mokweri/2560_TrainingKit/README.md

# 2560_TrainingKit
 A Microcontroller Training Kit based on ATmega2560
 
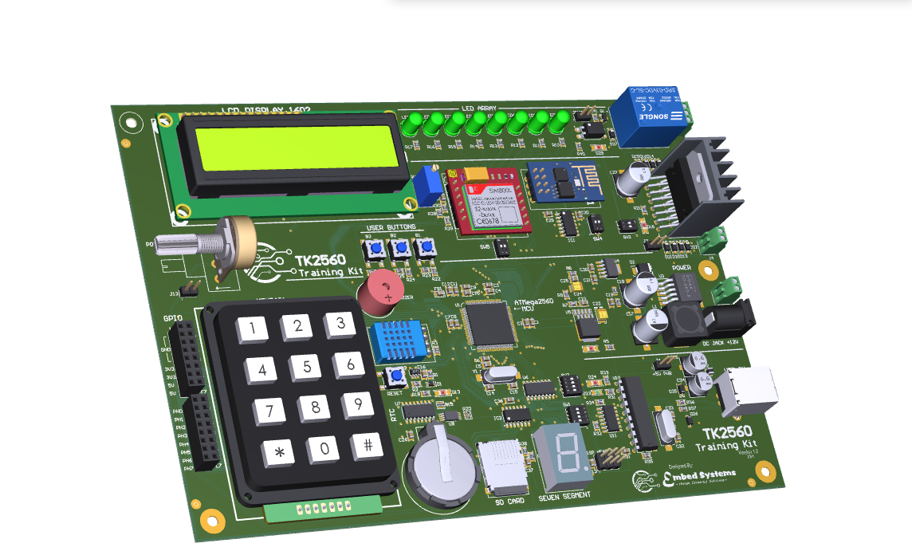
[picture p1: DesignFiles/TK2560_Images/TK2560_1.png]
