mokweri/2560_TrainingKit/Documentation/TK2560 Features.pptx

## TK2560 FEATURES

- Realtime Clock (DS3231) with backup battery

- ATMega2560 MCU

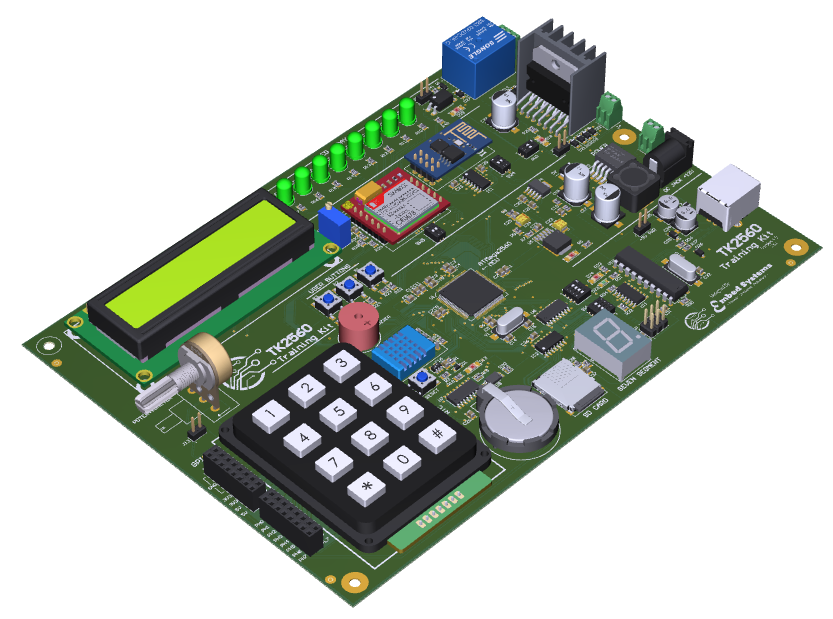
[picture p2: figure]

- 1 Digit Seven Segment

- 16x2 LCD Display

- EEPROM

- WIFI (ESP8166)

- Buzzer

- 8 LEDs Array

- Micro SD Card Slot

- GSM (SIM800L)

- Opto-coupled Solenoid relay

- 4x3 Keypad

- Motor Driver (L298N)

- Onboard ISP (USBTiny)

- DHT11 Temp. sensor

- 3 User Buttons

- Analog in; Potentiometer

- 24 GPIOs

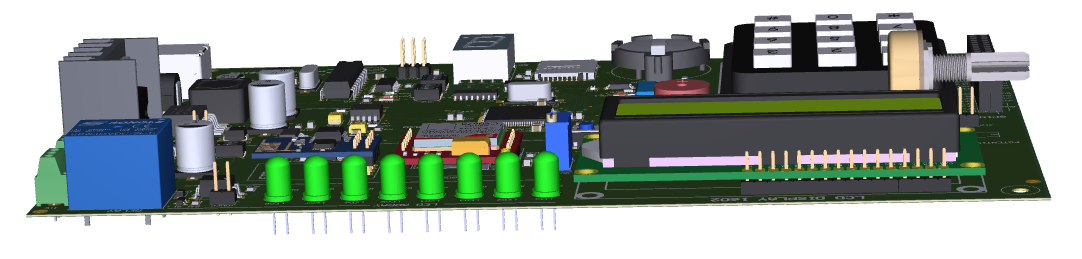
[picture p3: figure]

## TK2560 FEATURES

- ATMega2560 MCU

- Realtime Clock (DS3231) with backup battery

- 1 Digit Seven Segment

- 16x2 LCD Display

- EEPROM

- WIFI (ESP8166)

- Buzzer

- 8 LEDs Array

- Micro SD Card Slot

- GSM (SIM800L)

- Opto-coupled Solenoid relay

- 4x3 Keypad

- Motor Driver (L298N)

- Onboard ISP (USBTiny)

- DHT11 Temp. sensor

- 3 User Buttons

- Analog in; Potentiometer

- 24 GPIOs

## Slide 3

Opto-coupled Solenoid relay

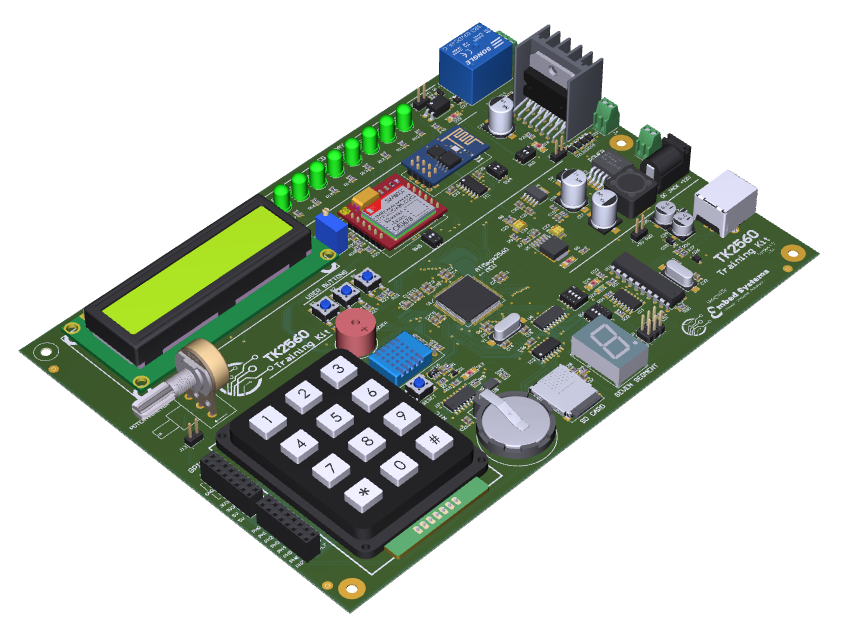
[picture p4: figure]

Motor Driver (L298N)

GSM (SIM800L)

WIFI (ESP8166)

Power: 5-12V

8 LEDs Array

3 User Buttons

16x2 LCD Display

Onboard ISP (USBTiny)

Buzzer

ATMega2560 MCU

1 Digit Seven Segment

Analog in; Potentiometer

24 GPIOs

Realtime Clock (DS3231) with backup battery

Micro SD Card Slot

4x3 Keypad

DHT11 Temp. sensor

## Slide 4

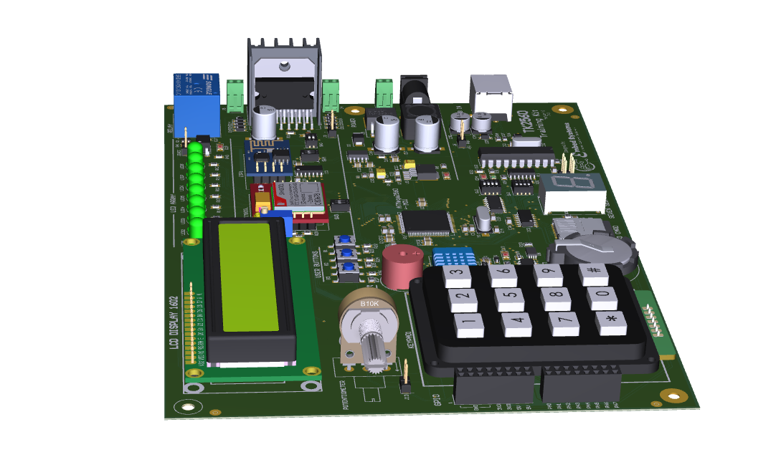
[picture p5: figure]

## Slide 5

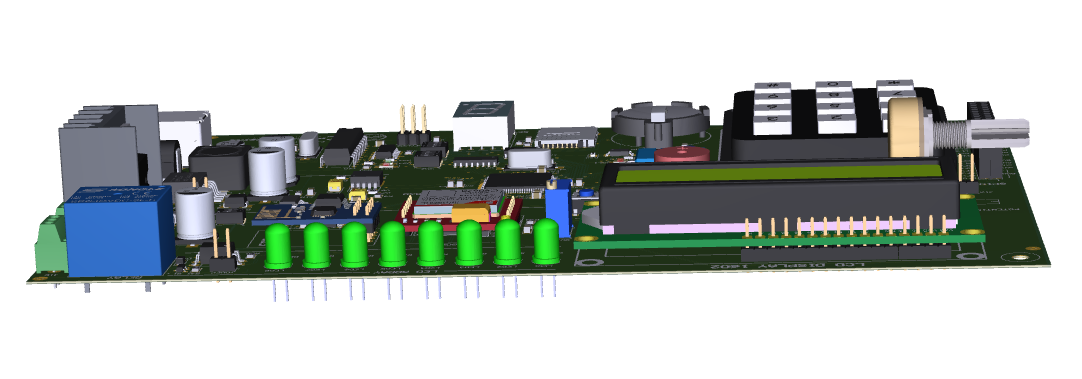
[picture p6: figure]
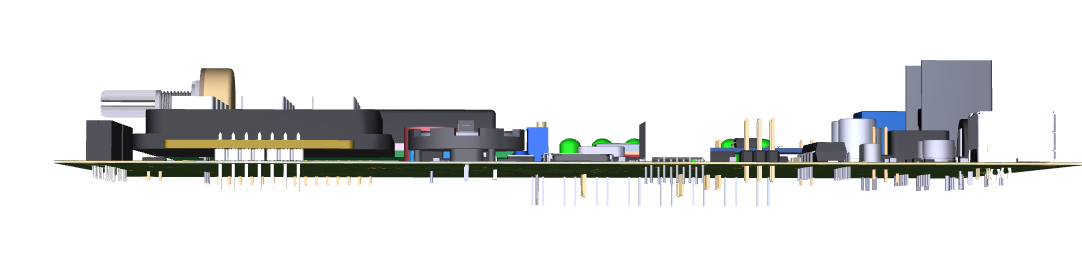
[picture p7: figure]

## Slide 6

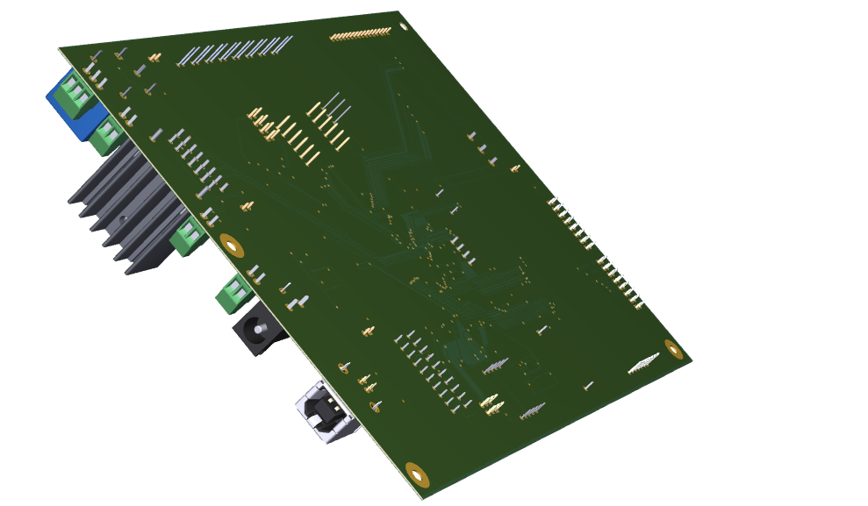
[picture p8: figure]
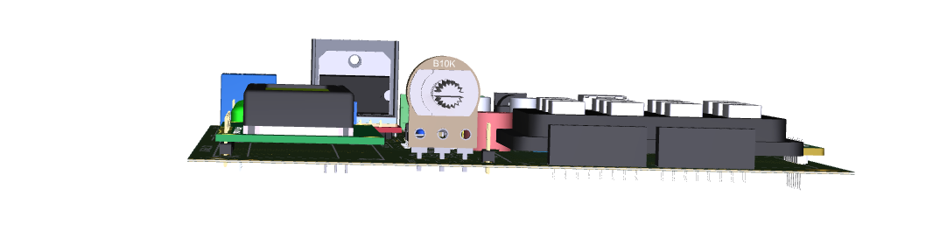
[picture p9: figure]

## TK2560 FEATURES

- Realtime Clock (DS3231) with backup battery

- ATMega2560 MCU

- 1 Digit Seven Segment

- 16x2 LCD Display

- EEPROM

- WIFI (ESP8166)

- Buzzer

- 8 LEDs Array

- Micro SD Card Slot

- GSM (SIM800L)

- Opto-coupled Solenoid relay

- 4x3 Keypad

- Motor Driver (L298N)

- Onboard ISP (USBTiny)

- DHT11 Temp. sensor

- 3 User Buttons

- Analog in; Potentiometer

- 24 GPIOs
