mokweri/2560_TrainingKit/Release Files/Invoice.pdf

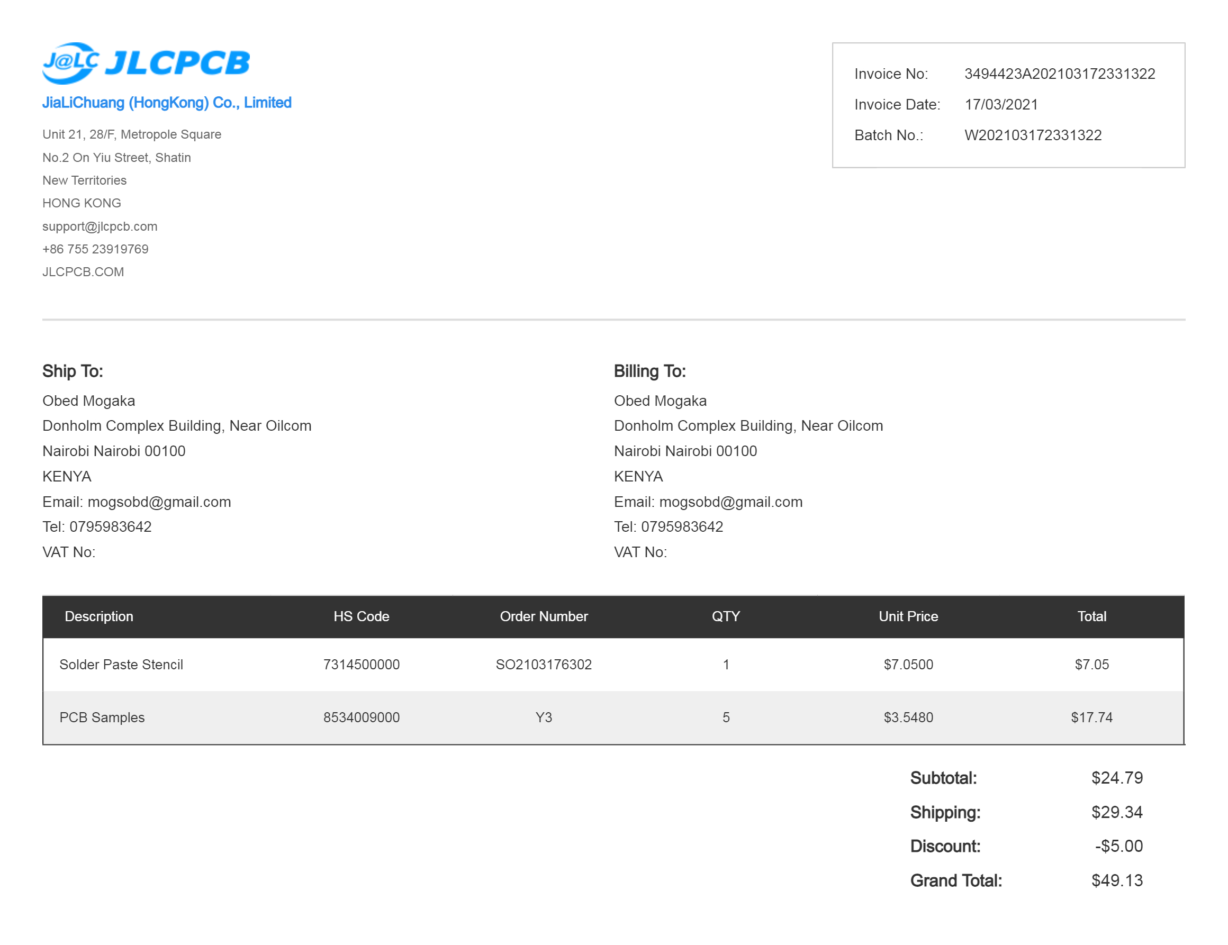
[picture p10: figure]
