mokweri/2560_TrainingKit/DesignFiles/TK2560_Images/TK2560 Features/Slide3.JPG

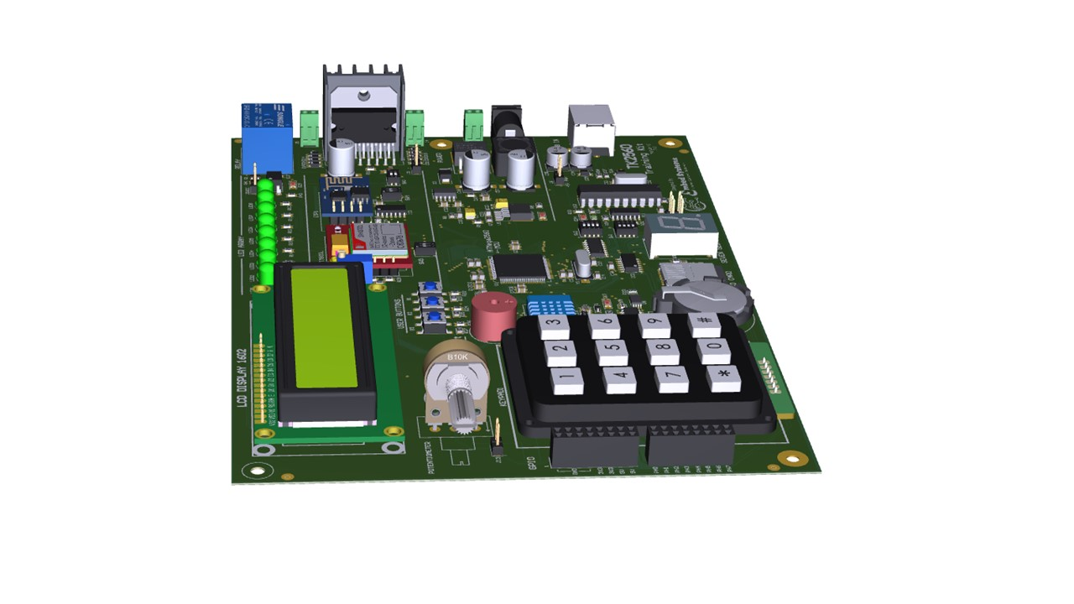
DesignFiles/TK2560_Images/TK2560 Features/Slide3.JPG
