mokweri/2560_TrainingKit/DesignFiles/TK2560_Images/TK2560 Features/Slide5.JPG

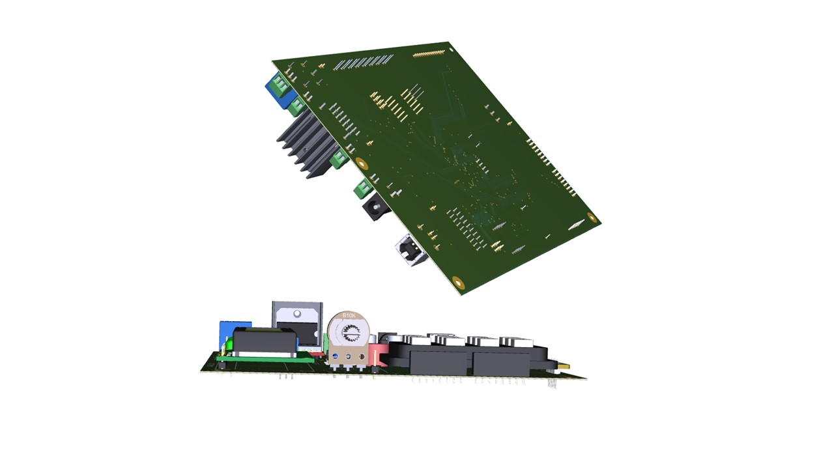
DesignFiles/TK2560_Images/TK2560 Features/Slide5.JPG
