mokweri/2560_TrainingKit/Documentation/Datasheet Library/100tqfp.gif

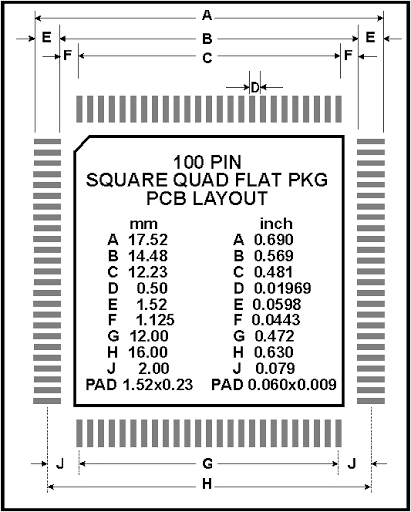
Documentation/Datasheet Library/100tqfp.gif
