mokweri/2560_TrainingKit/Documentation/Datasheet Library/Arduino_Mega_2560_schematic-AasmEVd7P.png

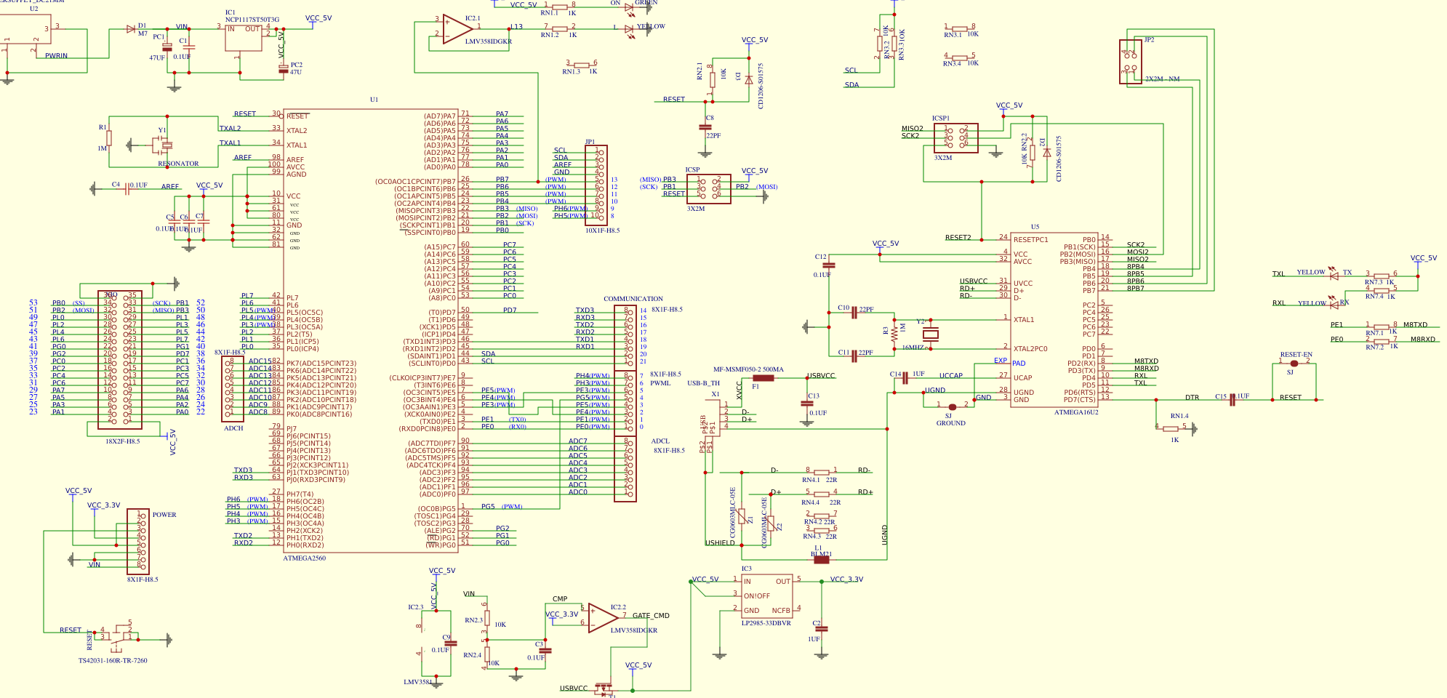
Documentation/Datasheet Library/Arduino_Mega_2560_schematic-AasmEVd7P.png
