mokweri/2560_TrainingKit/Documentation/Datasheet Library/Card Detection Switches.PNG

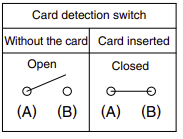
Documentation/Datasheet Library/Card Detection Switches.PNG
