mokweri/2560_TrainingKit/Documentation/Datasheet Library/DS3231-with-EEPROM-Schematic-2.jpg

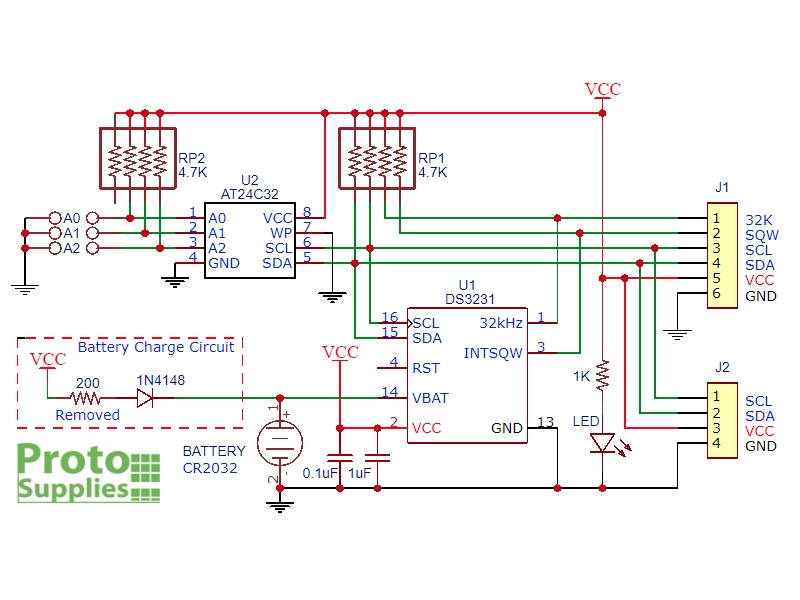
Documentation/Datasheet Library/DS3231-with-EEPROM-Schematic-2.jpg
