mokweri/2560_TrainingKit/Documentation/Schematic Samples/Existing_Reference.jpg

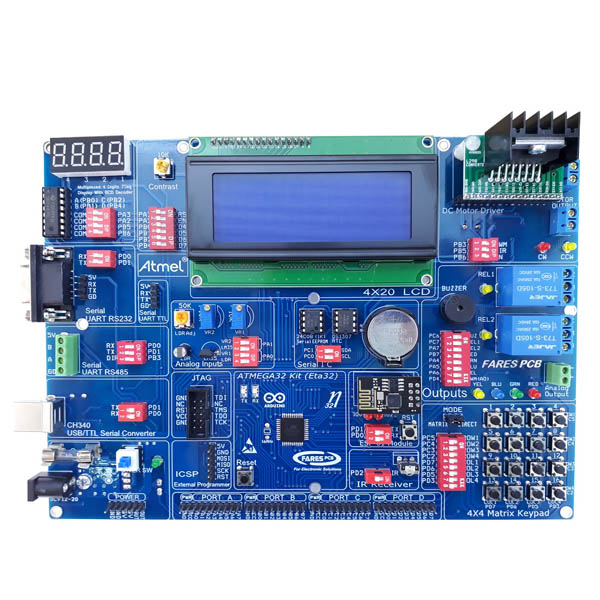
Documentation/Schematic Samples/Existing_Reference.jpg
