mokweri/2560_TrainingKit/Release Files/Images/TK2560/Slide1.JPG

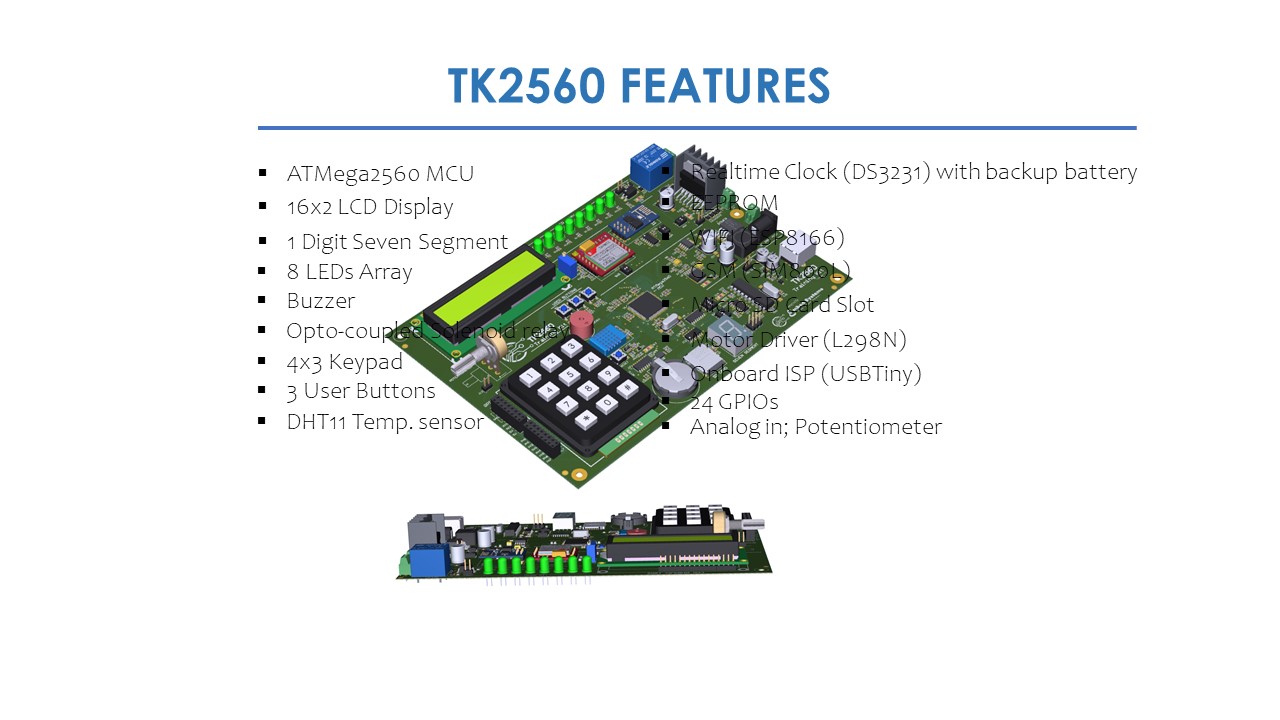
Release Files/Images/TK2560/Slide1.JPG
