mokweri/2560_TrainingKit/Release Files/Images/TK2560/Slide2.JPG

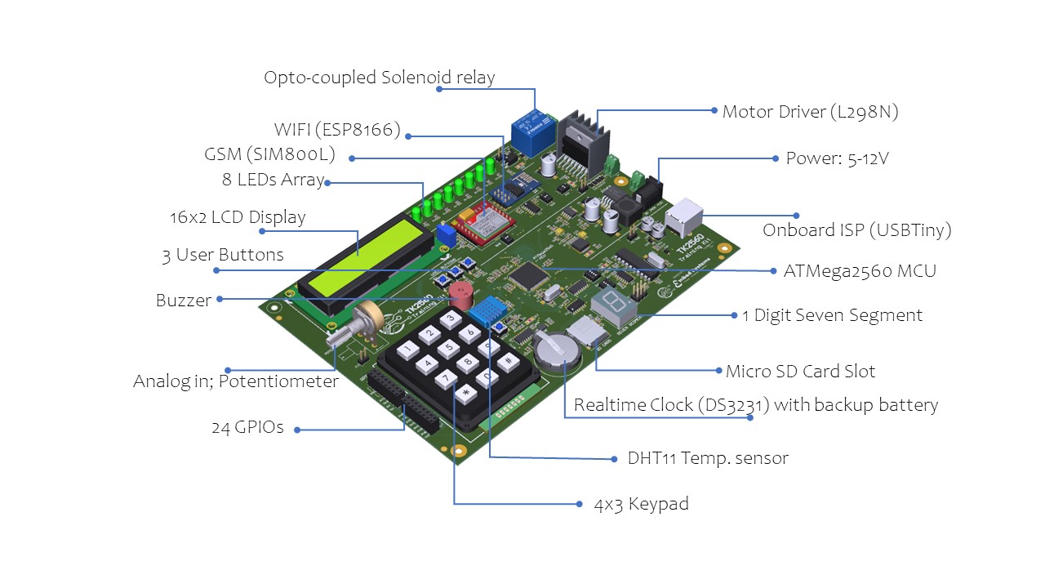
Release Files/Images/TK2560/Slide2.JPG
