mokweri/2560_TrainingKit/Release Files/Images/TK2560/Slide6.JPG

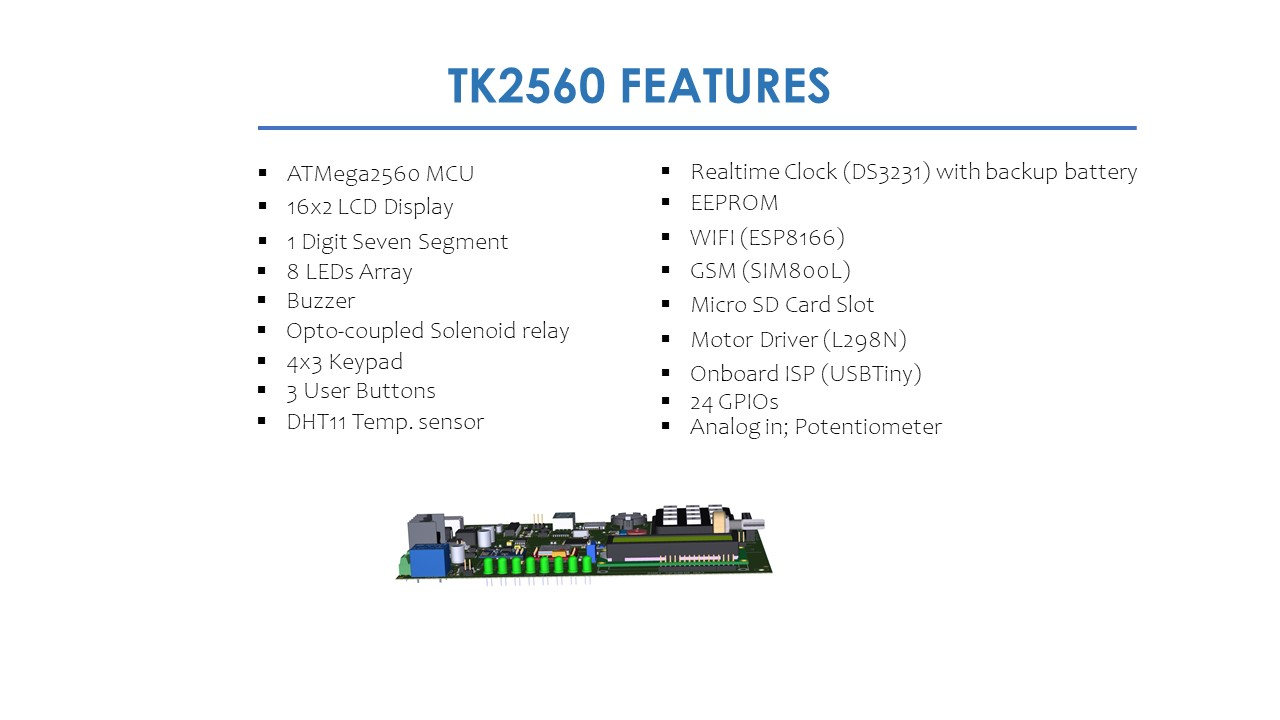
Release Files/Images/TK2560/Slide6.JPG
