mokweri/2560_TrainingKit/Release Files/Images/TK2560/TK2560_10.png

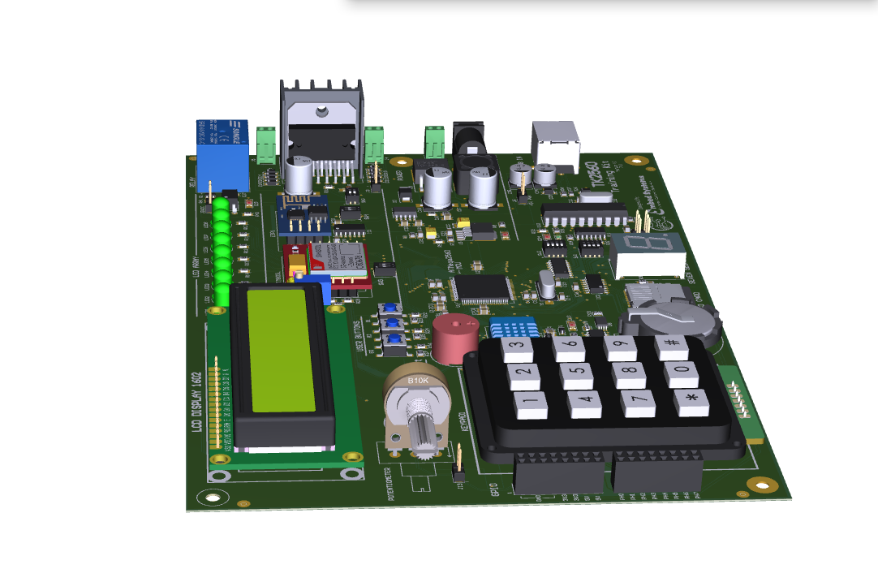
Release Files/Images/TK2560/TK2560_10.png
