mokweri/2560_TrainingKit/Production/TK2560_Grouped BOM.xlsx

Sheet: Part List Report
 | Component reference list (grouped) |  |  |  | 2560_TrainingKit
 | Source Data From: |  | 2560_TrainingKit.PrjPcb |  |  | Contact: |  | Generated by:
 | Project: |  | 2560_TrainingKit.PrjPcb
 | Variant: |  | None |  |  |  |  | EMBEDSYSTEMS
 | Report Date: |  | 3/13/2021 | 19:58
 | Print Date: |  | 2021-03-16 | 12:39:30
# | Designator | Quantity | Comment | Description | Manufacturer 1 | Manufacturer Part Number 1 | Package / Case | Supplier 1 | Supplier Part Number 1
1 | Y2 | 1 | 12MHz | CRYSTAL 12.0000MHZ 30PF SMD |  |  | HC-49/US | DigiKey | 535-14871-1-ND
2 | Y1 | 1 | 16MHz | CRYSTAL 16.0000MHZ 16PF SMD |  |  | HC-49/US | DigiKey | 535-14880-1-ND
3 | USB IN | 1 | 61729-1011BLF | CONN RCPT USB2.0 TYPEB 4POS R/A |  |  |  | DigiKey | 609-3657-ND
4 | U11 | 1 | SN74AHC125NSR | Buffer/Line Driver 4-CH Non-Inverting 3-ST CMOS 14-Pin SOP T/R |  |  |  | Digi-Key | 296-31733-1-ND
5 | U10 | 1 | ATTINY2313-20PU | ATMEL ATTINY2313-20PU 8 Bit Microcontroller, Low Power High Performance, ATtiny, 20 MHz, 2 KB, 128 Byte, 20 Pins, DIP |  |  |  | Digi-Key | ATTINY2313-20PU-ND
6 | U9 | 1 | L298N | Motor / Motion / Ignition Controllers & Drivers Dual Full Bridge |  |  |  | Digi-Key | 497-1395-5-ND
7 | U8 | 1 | AT24C32D-SSHM-T | EEPROM Serial-2Wire 32K-bit 4K x 8 1.8V/2.5V/3.3V/5V 8-Pin SOIC T/R |  |  |  |  | AT24C32D-SSHM-TCT-ND
8 | U7 | 1 | DS3231SN | MAXIM INTEGRATED PRODUCTS - DS3231SN#T&R - IC, RTC, Datum-/Zeitformat (Tag/Datum/Monat/Jahr, hh:mm:ss), I2C, 2.3V-5.5V Versorgung, SOIC-16 |  |  |  | Digi-Key | DS3231SN#T&RCT-ND
9 | U6 | 1 | MC74HC595ADR2 | IC SHIFT REGISTR 8BIT 3ST 16SOIC |  |  |  | Digi-Key | MC74HC595ADR2OSCT-ND
10 | U5 | 1 | MIC29302AWD-TR | IC REG LINEAR POS ADJ 3A TO252-5 |  |  |  | Digi-Key | 576-4106-1-ND
11 | U4 | 1 | TL1963A-33DCQR | IC REG LINEAR 3.3V 1.5A SOT223-6 |  |  |  | Arrow Electronics | TL1963A-33DCQR
12 | U3 | 1 | LM2596DSADJR4G | Sw. Regulator 3A Adj. Step-Down D2PAK-5 |  |  |  | Digi-Key | LM2596DSADJR4GOSCT-ND
13 | U2 | 1 | SN74AHC1G09DBVR | TEXAS INSTRUMENTS - SN74AHC1G09DBVR - AND Gate, 74AHC1G09, 2 Input, 2 V to 5.5 V, SOT-23-5 |  |  |  | Digi-Key | 296-29202-1-ND
14 | U1 | 1 | ATMEGA2560-16AUR | ATMEGA2560 IC MCU 8BIT 256KB FLASH 100TQFP |  |  |  | Digi-Key | ATMEGA2560-16AURCT-ND
15 | SW3, SW4, SW5 | 3 | 218-2LPST | SWITCH SLIDE DIP SPST 25MA 24V |  |  |  | DigiKey | CT2182LPST-ND
16 | SW1, SW2 | 2 | DIP SWITCH | SWITCH SLIDE DIP SPST 25MA 24V |  |  |  | DigiKey | CT3110CT-ND
17 | SIM800L | 1 | Sim800l Breakout
18 | SEVEN SEGMENT | 1 | 7SEG_1DG | LED Displays & Accessories Single Red 640nm Common Anode |  |  |  | Digi-Key | 754-1677-5-ND
19 | SD CARD | 1 | DM3BT-DSF-PEJS | CONN MICRO SD CARD PUSH-PUSH R/A |  |  |  | DigiKey | HR1942TR-ND
20 | RV1 | 1 | 3296W-10K_Trim_Pot | TRIMMER 10K OHM 0.5W PC PIN TOP |  |  |  |  | 3296W-103-ND
21 | RELAY | 1 | SRD-05VDC | TE CONNECTIVITY - 1-1721150-0 - POWER RELAY, SPDT, 277VAC, 10A, TH |  |  |  | Digi-Key | PB2032-ND
22 | R36, R37 | 2 | 33.2 Ohms | RES 33.2 OHM 1% 1/4W 0805 |  |  | 0805 (2012 Metric) | DigiKey | RNCP0805FTD33R2CT-ND
23 | R35 | 1 | 10 kOhms | RES 10K OHM 5% 1/4W 0805 |  |  | 0805 (2012 Metric) | DigiKey | 2019-SG73S2ATTD103JCT-ND
24 | R32, R34 | 2 | 1.5 kOhms | RES 1.5K OHM 1% 1/4W 0805 |  |  | 0805 (2012 Metric) | DigiKey | 2019-SG73S2ATTD1501FCT-ND
25 | R31, R33 | 2 | 220 Ohms | RES 220 OHM 1% 1/4W 0805 |  |  | 0805 (2012 Metric) | DigiKey | 2019-RK73H2ATTD2200FCT-ND
26 | R30 | 1 | 2 kOhms | RES SMD 2K OHM 1% 0.4W 0805 |  |  | 0805 (2012 Metric) | DigiKey | 541-2840-1-ND
27 | R28, R29 | 2 | 1 kOhms | RES 1K OHM 0.1% 1/10W 0805 |  |  | 0805 (2012 Metric) | DigiKey | RNCS0805BKE1K00CT-ND
28 | R23, R25, R27, R39 | 4 | 10 kOhms | RES SMD 10K OHM 0.1% 1/10W 0805 |  |  | 0805 (2012 Metric) | DigiKey | A106043CT-ND
29 | R22, R24, R26, R38 | 4 | 220 Ohms | RES SMD 220 OHM 1% 1/8W 0805 |  |  | 0805 (2012 Metric) | DigiKey | P220CCT-ND
30 | R19, R20 | 2 | EXB-28V472JX | RES ARRAY 4 RES 4.7K OHM 0804 |  |  | 0804, Convex, Long Side Terminals | DigiKey | Y7472CT-ND
31 | R10, R11, R12, R13, R14, R15, R16, R17 | 8 | 330 Ohms | RES SMD 330 OHM 1% 1/8W 0805 |  |  | 0805 (2012 Metric) | DigiKey | 311-330CRCT-ND
32 | R9 | 1 | 43 kOhms | RES SMD 43K OHM 0.1% 1/8W 0805 |  |  | 0805 (2012 Metric) | DigiKey | YAG1899CT-ND
33 | R8 | 1 | 470 Ohms | RES SMD 470 OHM 1% 1/2W 0805 |  |  | 0805 (2012 Metric) | DigiKey | 541-470TCT-ND
34 | R7 | 1 | 100 kOhms | RES SMD 100K OHM 1% 0.4W 0805 |  |  | 0805 (2012 Metric) | DigiKey | 541-2850-1-ND
35 | R6, R40, R41 | 3 | 1 kOhms | RES 1K OHM 1% 1/4W 0805 |  |  | 0805 (2012 Metric) | DigiKey | RNCP0805FTD1K00CT-ND
36 | R5, R18, R21 | 3 | 330 Ohms | RES SMD 330 OHM 5% 1/8W 0805 |  |  | 0805 (2012 Metric) | DigiKey | P330ACT-ND
37 | R4 | 1 | 3 kOhms | RES SMD 3K OHM 0.5% 1/4W 0805 |  |  | 0805 (2012 Metric) | DigiKey | P21071CT-ND
38 | R3 | 1 | 4.7 kOhms | RES SMD 4.7K OHM 1% 1/8W 0805 |  |  | 0805 (2012 Metric) | DigiKey | YAG1325CT-ND
39 | R2 | 1 | 22 Ohms | RES SMD 22 OHM 5% 1/8W 0805 |  |  | 0805 (2012 Metric) | DigiKey | 311-22ARCT-ND
40 | R1 | 1 | 10 kOhms | RES SMD 10K OHM 0.5% 1/8W 0805 |  |  | 0805 (2012 Metric) | DigiKey | 311-2699-1-ND
41 | Q1 | 1 | BC847BLT3G | TRANS NPN 45V 0.1A SOT-23 |  |  | TO-236-3, SC-59, SOT-23-3 | DigiKey | BC847BLT3GOSCT-ND
42 | POTENTIOMETER | 1 | POT 10K | Res Conductive Plastic POT 10K Ohm 20% 1/5W 1(Elec)/1(Mech)Turn 6mm Pin Panel Mount/Through Hole |  |  |  | Digi-Key | 987-1715-ND
43 | MH4 | 1 | MH_7.4MMNC_3.2MMD | Mounting Hole 7.4mm Diameter (Non Copper), 3.2mm Dril NPTH
44 | MH1, MH2, MH3 | 3 | MH_7.4MMC_3.2MMD | Mounting Hole 7.4mm Diameter, 3.2mm Dril
45 | LED1, LED2, LED3, LED4, LED5, LED6, LED7, LED8 | 8 | LED_5mm | 5MM LED |  |  |  | Digi-Key | 754-1896-ND
46 | LCD DISPLAY 1602 | 1 | LCD-1602 | LUMEX LCM-S01602DTR/C Alphanumeric LCD, 16 x 2, Black on Grey, 5V, Parallel, English, Japanese, Reflective |  |  |  | Digi-Key | 67-1780-ND
47 | L2 | 1 | 2.2µH | FIXED IND 2.2UH 2A 168 MOHM SMD |  |  | 0806 (2016 Metric) | DigiKey | 490-10609-1-ND
48 | L1 | 1 | 33µH | FIXED IND 33UH 3.5A 57 MOHM SMD |  |  | Nonstandard | DigiKey | SRR1280-330MCT-ND
49 | KEYPAD1 | 1 | 3X4Keypad | 3x4 Matrix Keypad |  |  |  | Digi-Key | 1528-2673-ND
50 | J10 | 1 | 282834-3 | TERM BLK 3P SIDE ENT 2.54MM PCB |  |  |  | DigiKey | A98334-ND
51 | J4, J5, J14 | 3 | 282834-2 | TERM BLK 2P SIDE ENT 2.54MM PCB |  |  |  | DigiKey | A98333-ND
52 | J3, J6, J13, JDVCC | 4 | HDR_1x2, OUTPWR, JDVCC | Pin Header 2.54MM Pitch Str, 1X2PIN, Full G/f, NY6T, 6.1MM*2.5MM*3.0MM / Bag |  |  |  | Mouser | 523-G800W306018EU
53 | ISP HEADER | 1 | ISP HDR | CONN HEADER 6POS .100 STR 30AU |  |  |  | Digi-Key | 609-3393-ND
54 | IC1, IC2 | 2 | TXB0104DR | IC TRNSLTR BIDIRECTIONAL 14SOIC |  |  | 14-SOIC (0.154", 3.90mm Width) | DigiKey | 296-21928-1-ND
55 | GPIO, J12 | 2 | HDR_2x8 | CONN HDR FEMALE 16POS 0.1 GOLD PCB |  |  |  | Digi-Key | S7111-ND
56 | FID1, FID2, FID3, FID4 | 4 | FID_1MM | Fiducial 40mil Diameter, 120mil mask
57 | FB1 | 1 | MPZ2012S601AT000 | FERRITE BEAD 600 OHM 0805 1LN |  |  |  | Digi-Key | 445-2206-1-ND
58 | ESP1 | 1 | ESP-01M | TXRX ESP8266 MOD WIFI TRACE ANT |  |  |  | Digi-Key | 1597-1145-ND
59 | DHT11 | 1 | DHT11 | SENSOR HUMID/TEMP 5V DTL 5% MOD |  |  |  | Digi-Key | 1528-1228-ND
60 | DC JACK +12V | 1 | PJ-102AH | CONN PWR JACK 2X5.5MM SOLDER |  |  |  | DigiKey | CP-102AH-ND
61 | D28 | 1 | LTV-817S-TA1 | OPTOISOLATR 5KV TRANSISTOR 4-SMD |  |  | 4-SMD, Gull Wing | DigiKey | 160-1893-1-ND
62 | D25, D26 | 2 | MMSZ5227B-E3-08 | DIODE ZENER 3.6V 500MW SOD123 |  |  | SOD-123 | DigiKey | MMSZ5227B-E3-08GICT-ND
63 | D24, D29 | 2 | Red | LED RED CLEAR 2SMD |  |  | 1206 (3216 Metric) | DigiKey | 1497-1289-1-ND
64 | D23 | 1 | Green | LED GREEN CLEAR 0805 SMD |  |  | 0805 (2012 Metric) | DigiKey | 1080-1411-1-ND
65 | D14, D15, D16, D17, D19, D20, D21, D22, D27 | 9 | 1N4007FLTR | STANDARD RECTIFIER 1000V SOD-123 |  |  | SOD-123F | DigiKey | 1655-1N4007FLCT-ND
66 | D3, D13, D18 | 3 | Red | LED SMD |  |  | 1206 (3216 Metric) | DigiKey | 754-APTL3216SURCK-01CT-ND
67 | D2 | 1 | B340BQ-13-F | DIODE SCHOTTKY 40V 3A SMB |  |  | DO-214AA, SMB | DigiKey | B340BQ-13-FDICT-ND
68 | D1 | 1 | BAT54HT1G | DIODE SCHOTTKY 30V 200MA SOD323 |  |  | SC-76, SOD-323 | DigiKey | BAT54HT1GOSCT-ND
69 | C34, C35 | 2 | 100µF | CAP ALUM 100UF 20% 10V SMD |  |  | Radial, Can - SMD | DigiKey | 493-16092-1-ND
70 | C32, C33 | 2 | 30pF | CAP CER 30PF 25V NP0 0805 |  |  | 0805 (2012 Metric) | DigiKey | 399-17444-1-ND
71 | C27 | 1 | 220µF | CAP ALUM 220UF 20% 35V SMD |  |  | Radial, Can - SMD | DigiKey | PCE4321CT-ND
72 | C24 | 1 | 330µF | CAP TANT 330UF 10% 4V 1411 |  |  | 1411 (3528 Metric) | DigiKey | 478-8377-1-ND
73 | C23 | 1 | 1µF | CAP CER 1UF 16V X5R 0805 |  |  | 0805 (2012 Metric) | DigiKey | 478-11535-1-ND
74 | C22 | 1 | 100µF | CAP TANT 100UF 20% 6.3V 1411 |  |  | 1411 (3528 Metric) | DigiKey | 399-3833-1-ND
75 | C19 | 1 | 0.1µF | CAP CER 0.1UF 16V X7R 0805 |  |  | 0805 (2012 Metric) | DigiKey | 709-1183-1-ND
76 | C18 | 1 | 220µF | CAP ALUM 220UF 20% 25V SMD |  |  | Radial, Can - SMD | DigiKey | 493-6222-1-ND
77 | C17 | 1 | 100µF | CAP ALUM 100UF 20% 50V SMD |  |  | Radial, Can - SMD | DigiKey | 493-6336-1-ND
78 | C14, C15 | 2 | 22pF | CAP CER 22PF 100V C0G/NP0 0805 |  |  | 0805 (2012 Metric) | DigiKey | 478-10819-1-ND
79 | C2, C4, C6, C8, C10, C12, C13, C16, C25, C26, C28, C29, C30, C31, C36, C37 | 16 | 100nF, 0.1µF | CAP CER 0805 10% X8R 50V 100NF |  |  | 0805 (2012 Metric) | DigiKey | 311-4624-1-ND
80 | C1, C3, C5, C7, C9, C11, C20, C21 | 8 | 10µF | CAP CER 10UF 16V X5R 0805 |  |  | 0805 (2012 Metric) | DigiKey | 1763-1170-1-ND
81 | BUZZER | 1 | BUZZER | AUDIO MAGNETIC XDCR 3-7V TH |  |  |  | Digi-Key | 668-1470-ND
82 | BH1 | 1 | Batt Holder | BATTERY HOLDER COIN 20MM PC PIN |  |  |  | Digi-Key | BS-7-ND
83 | B1, B2, B3, RESET | 4 | PTS645SM43SMTR92 LFS | SWITCH TACTILE SPST-NO 0.05A 12V |  |  |  | DigiKey | CKN9112CT-ND
Approved |  |  |  |  | Notes

Sheet: Project Information
Project Full Path | D:\2560_TrainingKit\DesignFiles\2560_TrainingKit\2560_TrainingKit.PrjPcb
Project Filename | 2560_TrainingKit.PrjPcb
Variant Name | None
Data-Source Filename | 2560_TrainingKit.PrjPcb
Data-Source Full Path | D:\2560_TrainingKit\DesignFiles\2560_TrainingKit\2560_TrainingKit.PrjPcb
Title | 2560_TrainingKit.PrjPcb
Total Quantity | 167
Report Time | 19:58
Report Date | 3/13/2021
Report Date & Tine | 3/13/2021 19:58
Output Name | TK2560_Grouped BOM
Output Type | BOM_PartType
Output Generator Name | BOM
Output Generator Description | Bill of Materials
