mokweri/2560_TrainingKit/Production/TK2560_BOM Purchasing.xlsx

Sheet: Part List Report
 | Component list |  |  | TK2560_BOM Purchasing for Project [2560_TrainingKit.PrjPcb] (No PCB Document Selected)
 | Source Data From: | 2560_TrainingKit.PrjPcb |  |  | Contact: |  |  |  | Generated by:
 | Project: | 2560_TrainingKit.PrjPcb
 | Variant: | None |  |  |  |  |  |  | EMDEDSYSTEMS
 | Report Date: | 3/13/2021 | 19:37
 | Print Date: | 2021-03-13 | 19:38:11
# | Category | Manufacturer 1 | Manufacturer Part Number 1 | Package / Case | Description | Quantity | Supplier 1 | Supplier Part Number 1 | Supplier Order Qty 1 | Supplier Stock 1 | Supplier Unit Price 1 | Supplier Subtotal 1 | Supplier Currency 1
1 |  |  |  | 0805 (2012 Metric) | CAP CER 0805 10% X8R 50V 100NF, CAP CER 0.1UF 16V X7R 0805 | 2 | DigiKey | 311-4624-1-ND, 709-1183-1-ND
2 |  |  |  | 0805 (2012 Metric) | RES 1K OHM 1% 1/4W 0805, RES 1K OHM 0.1% 1/10W 0805 | 5 | DigiKey | RNCP0805FTD1K00CT-ND, RNCS0805BKE1K00CT-ND
3 |  |  |  | 0805 (2012 Metric) | CAP CER 1UF 16V X5R 0805 | 1 | DigiKey | 478-11535-1-ND
4 |  |  |  | SOD-123F | STANDARD RECTIFIER 1000V SOD-123 | 9 | DigiKey | 1655-1N4007FLCT-ND
5 |  |  |  | 0805 (2012 Metric) | RES 1.5K OHM 1% 1/4W 0805 | 2 | DigiKey | 2019-SG73S2ATTD1501FCT-ND
6 |  |  |  | 0805 (2012 Metric) | RES SMD 2K OHM 1% 0.4W 0805 | 1 | DigiKey | 541-2840-1-ND
7 |  |  |  | 0806 (2016 Metric) | FIXED IND 2.2UH 2A 168 MOHM SMD | 1 | DigiKey | 490-10609-1-ND
8 |  |  |  | 0805 (2012 Metric) | RES SMD 3K OHM 0.5% 1/4W 0805 | 1 | DigiKey | P21071CT-ND
9 |  |  |  |  | 3x4 Matrix Keypad | 1 | Digi-Key | 1528-2673-ND
10 |  |  |  | 0805 (2012 Metric) | RES SMD 4.7K OHM 1% 1/8W 0805 | 1 | DigiKey | YAG1325CT-ND
11 |  |  |  | 0805 (2012 Metric) | RES SMD 10K OHM 0.5% 1/8W 0805, RES SMD 10K OHM 0.1% 1/10W 0805, RES 10K OHM 5% 1/4W 0805 | 6 | DigiKey | 311-2699-1-ND, A106043CT-ND, 2019-SG73S2ATTD103JCT-ND
12 |  |  |  | 0805 (2012 Metric) | CAP CER 10UF 16V X5R 0805 | 8 | DigiKey | 1763-1170-1-ND
13 |  |  |  | HC-49/US | CRYSTAL 12.0000MHZ 30PF SMD | 1 | DigiKey | 535-14871-1-ND
14 |  |  |  | HC-49/US | CRYSTAL 16.0000MHZ 16PF SMD | 1 | DigiKey | 535-14880-1-ND
15 |  |  |  | 0805 (2012 Metric) | RES SMD 22 OHM 5% 1/8W 0805 | 1 | DigiKey | 311-22ARCT-ND
16 |  |  |  | 0805 (2012 Metric) | CAP CER 22PF 100V C0G/NP0 0805 | 2 | DigiKey | 478-10819-1-ND
17 |  |  |  | 0805 (2012 Metric) | CAP CER 30PF 25V NP0 0805 | 2 | DigiKey | 399-17444-1-ND
18 |  |  |  | Nonstandard | FIXED IND 33UH 3.5A 57 MOHM SMD | 1 | DigiKey | SRR1280-330MCT-ND
19 |  |  |  | 0805 (2012 Metric) | RES 33.2 OHM 1% 1/4W 0805 | 2 | DigiKey | RNCP0805FTD33R2CT-ND
20 |  |  |  | 0805 (2012 Metric) | RES SMD 43K OHM 0.1% 1/8W 0805 | 1 | DigiKey | YAG1899CT-ND
21 |  |  |  | 0805 (2012 Metric) | RES SMD 100K OHM 1% 0.4W 0805 | 1 | DigiKey | 541-2850-1-ND
22 |  |  |  | Radial, Can - SMD | CAP ALUM 100UF 20% 10V SMD | 2 | DigiKey | 493-16092-1-ND
23 |  |  |  | Radial, Can - SMD | CAP ALUM 100UF 20% 50V SMD | 1 | DigiKey | 493-6336-1-ND
24 |  |  |  | 1411 (3528 Metric) | CAP TANT 100UF 20% 6.3V 1411 | 1 | DigiKey | 399-3833-1-ND
25 |  |  |  | 0805 (2012 Metric) | CAP CER 0805 10% X8R 50V 100NF | 15 | DigiKey | 311-4624-1-ND
26 |  |  |  |  | SWITCH SLIDE DIP SPST 25MA 24V | 3 | DigiKey | CT2182LPST-ND
27 |  |  |  | 0805 (2012 Metric) | RES SMD 220 OHM 1% 1/8W 0805, RES 220 OHM 1% 1/4W 0805 | 6 | DigiKey | P220CCT-ND, 2019-RK73H2ATTD2200FCT-ND
28 |  |  |  | Radial, Can - SMD | CAP ALUM 220UF 20% 25V SMD, CAP ALUM 220UF 20% 35V SMD | 2 | DigiKey | 493-6222-1-ND, PCE4321CT-ND
29 |  |  |  | 0805 (2012 Metric) | RES SMD 330 OHM 5% 1/8W 0805, RES SMD 330 OHM 1% 1/8W 0805 | 11 | DigiKey | P330ACT-ND, 311-330CRCT-ND
30 |  |  |  | 1411 (3528 Metric) | CAP TANT 330UF 10% 4V 1411 | 1 | DigiKey | 478-8377-1-ND
31 |  |  |  | 0805 (2012 Metric) | RES SMD 470 OHM 1% 1/2W 0805 | 1 | DigiKey | 541-470TCT-ND
32 |  |  |  |  | CONN RCPT USB2.0 TYPEB 4POS R/A | 1 | DigiKey | 609-3657-ND
33 |  |  |  |  | TERM BLK 2P SIDE ENT 2.54MM PCB | 3 | DigiKey | A98333-ND
34 |  |  |  |  | TERM BLK 3P SIDE ENT 2.54MM PCB | 1 | DigiKey | A98334-ND
35 |  |  |  | DO-214AA, SMB | DIODE SCHOTTKY 40V 3A SMB | 1 | DigiKey | B340BQ-13-FDICT-ND
36 |  |  |  | SC-76, SOD-323 | DIODE SCHOTTKY 30V 200MA SOD323 | 1 | DigiKey | BAT54HT1GOSCT-ND
37 |  |  |  | TO-236-3, SC-59, SOT-23-3 | TRANS NPN 45V 0.1A SOT-23 | 1 | DigiKey | BC847BLT3GOSCT-ND
38 |  |  |  |  | SWITCH SLIDE DIP SPST 25MA 24V | 2 | DigiKey | CT3110CT-ND
39 |  |  |  |  | CONN MICRO SD CARD PUSH-PUSH R/A | 1 | DigiKey | HR1942TR-ND
40 |  |  |  | 0804, Convex, Long Side Terminals | RES ARRAY 4 RES 4.7K OHM 0804 | 2 | DigiKey | Y7472CT-ND
41 |  |  |  |  | Fiducial 40mil Diameter, 120mil mask | 4
42 |  |  |  | 0805 (2012 Metric) | LED GREEN CLEAR 0805 SMD | 1 | DigiKey | 1080-1411-1-ND
43 |  |  |  |  | Pin Header 2.54MM Pitch Str, 1X2PIN, Full G/f, NY6T, 6.1MM*2.5MM*3.0MM / Bag | 2 | Mouser | 523-G800W306018EU
44 |  |  |  |  | Pin Header 2.54MM Pitch Str, 1X2PIN, Full G/f, NY6T, 6.1MM*2.5MM*3.0MM / Bag | 1 | Mouser | 523-G800W306018EU
45 |  |  |  |  | 5MM LED | 8 | Digi-Key | 754-1896-ND
46 |  |  |  | 4-SMD, Gull Wing | OPTOISOLATR 5KV TRANSISTOR 4-SMD | 1 | DigiKey | 160-1893-1-ND
47 |  |  |  |  | Mounting Hole 7.4mm Diameter, 3.2mm Dril | 3
48 |  |  |  |  | Mounting Hole 7.4mm Diameter (Non Copper), 3.2mm Dril NPTH | 1
49 |  |  |  | SOD-123 | DIODE ZENER 3.6V 500MW SOD123 | 2 | DigiKey | MMSZ5227B-E3-08GICT-ND
50 |  |  |  |  | Pin Header 2.54MM Pitch Str, 1X2PIN, Full G/f, NY6T, 6.1MM*2.5MM*3.0MM / Bag | 1 | Mouser | 523-G800W306018EU
51 |  |  |  |  | CONN PWR JACK 2X5.5MM SOLDER | 1 | DigiKey | CP-102AH-ND
52 |  |  |  |  | SWITCH TACTILE SPST-NO 0.05A 12V | 4 | DigiKey | CKN9112CT-ND
53 |  |  |  | 1206 (3216 Metric) | LED SMD, LED RED CLEAR 2SMD | 5 | DigiKey | 754-APTL3216SURCK-01CT-ND, 1497-1289-1-ND
54 |  |  |  |  |  | 1
55 |  |  |  | 14-SOIC (0.154", 3.90mm Width) | IC TRNSLTR BIDIRECTIONAL 14SOIC | 2 | DigiKey | 296-21928-1-ND
56 | Audio Products |  |  |  | AUDIO MAGNETIC XDCR 3-7V TH | 1 | Digi-Key | 668-1470-ND
57 | Batteries and Accessories |  |  |  | BATTERY HOLDER COIN 20MM PC PIN | 1 | Digi-Key | BS-7-ND
58 | Buffers, Drivers and Transceivers |  |  |  | Buffer/Line Driver 4-CH Non-Inverting 3-ST CMOS 14-Pin SOP T/R | 1 | Digi-Key | 296-31733-1-ND
59 | Connectors |  |  |  | CONN HDR FEMALE 16POS 0.1 GOLD PCB | 2 | Digi-Key | S7111-ND
60 | EEPROM |  |  |  | EEPROM Serial-2Wire 32K-bit 4K x 8 1.8V/2.5V/3.3V/5V 8-Pin SOIC T/R | 1 |  | AT24C32D-SSHM-TCT-ND
61 | Embedded Processors and Controllers |  |  |  | TXRX ESP8266 MOD WIFI TRACE ANT | 1 | Digi-Key | 1597-1145-ND
62 | Ferrite Beads and Chips |  |  |  | FERRITE BEAD 600 OHM 0805 1LN | 1 | Digi-Key | 445-2206-1-ND
63 | Headers and Wire Housings |  |  |  | CONN HEADER 6POS .100 STR 30AU | 1 | Digi-Key | 609-3393-ND
64 | LCD, OLED, Graphic Displays |  |  |  | LUMEX LCM-S01602DTR/C Alphanumeric LCD, 16 x 2, Black on Grey, 5V, Parallel, English, Japanese, Reflective | 1 | Digi-Key | 67-1780-ND
65 | LED Displays |  |  |  | LED Displays & Accessories Single Red 640nm Common Anode | 1 | Digi-Key | 754-1677-5-ND
66 | Logic Gates |  |  |  | TEXAS INSTRUMENTS - SN74AHC1G09DBVR - AND Gate, 74AHC1G09, 2 Input, 2 V to 5.5 V, SOT-23-5 | 1 | Digi-Key | 296-29202-1-ND
67 | Microcontrollers |  |  |  | ATMEGA2560 IC MCU 8BIT 256KB FLASH 100TQFP | 1 | Digi-Key | ATMEGA2560-16AURCT-ND
68 | Microcontrollers |  |  |  | ATMEL ATTINY2313-20PU 8 Bit Microcontroller, Low Power High Performance, ATtiny, 20 MHz, 2 KB, 128 Byte, 20 Pins, DIP | 1 | Digi-Key | ATTINY2313-20PU-ND
69 | Motor Drivers |  |  |  | Motor / Motion / Ignition Controllers & Drivers Dual Full Bridge | 1 | Digi-Key | 497-1395-5-ND
70 | Optoelectronics |  |  |  | SENSOR HUMID/TEMP 5V DTL 5% MOD | 1 | Digi-Key | 1528-1228-ND
71 | Real Time Clocks |  |  |  | MAXIM INTEGRATED PRODUCTS - DS3231SN#T&R - IC, RTC, Datum-/Zeitformat (Tag/Datum/Monat/Jahr, hh:mm:ss), I2C, 2.3V-5.5V Versorgung, SOIC-16 | 1 | Digi-Key | DS3231SN#T&RCT-ND
72 | Shift Registers |  |  |  | IC SHIFT REGISTR 8BIT 3ST 16SOIC | 1 | Digi-Key | MC74HC595ADR2OSCT-ND
73 | Signal Relays |  |  |  | TE CONNECTIVITY - 1-1721150-0 - POWER RELAY, SPDT, 277VAC, 10A, TH | 1 | Digi-Key | PB2032-ND
74 | Variable Resistors and Potentiometers |  |  |  | TRIMMER 10K OHM 0.5W PC PIN TOP | 1 |  | 3296W-103-ND
75 | Variable Resistors and Potentiometers |  |  |  | Res Conductive Plastic POT 10K Ohm 20% 1/5W 1(Elec)/1(Mech)Turn 6mm Pin Panel Mount/Through Hole | 1 | Digi-Key | 987-1715-ND
76 | Voltage Regulators - Linear |  |  |  | IC REG LINEAR POS ADJ 3A TO252-5 | 1 | Digi-Key | 576-4106-1-ND
77 | Voltage Regulators - Linear |  |  |  | IC REG LINEAR 3.3V 1.5A SOT223-6 | 1 | Arrow Electronics | TL1963A-33DCQR
78 | Voltage Regulators - Switching |  |  |  | Sw. Regulator 3A Adj. Step-Down D2PAK-5 | 1 | Digi-Key | LM2596DSADJR4GOSCT-ND
 |  |  |  |  |  | 167 |  |  | 0 |  |  | 0
Approved |  |  |  | Notes
 |  |  |  |  |  | 5 | pcs: | Total |  | 0 |  | USD
 |  |  |  |  |  |  |  | Price for 1pcs |  | 0.00 |  | USD

Sheet: Project Information
Project Full Path | D:\2560_TrainingKit\DesignFiles\2560_TrainingKit\2560_TrainingKit.PrjPcb
Project Filename | 2560_TrainingKit.PrjPcb
Variant Name | None
Data-Source Filename | 2560_TrainingKit.PrjPcb
Data-Source Full Path | D:\2560_TrainingKit\DesignFiles\2560_TrainingKit\2560_TrainingKit.PrjPcb
Title | TK2560_BOM Purchasing for Project [2560_TrainingKit.PrjPcb] (No PCB Document Selected)
Total Quantity | 167
Report Time | 19:37
Report Date | 3/13/2021
Report Date & Tine | 3/13/2021 19:37
Output Name | TK2560_BOM Purchasing
Output Type | BOM_PartType
Output Generator Name | BOM
Output Generator Description | Bill of Materials
