mokweri/2560_TrainingKit/Release Files/2 - Board Assembly/JLCSMT_BOM.xlsx

 | Comment | Designator | Description | Footprint | LCSC Part
1 | CRYSTAL 12.0000MHZ 30PF SMD | Y2 | CRYSTAL 12.0000MHZ 30PF SMD | HC-49/US | C188206 (https://lcsc.com/product-detail/SMD-Crystal-Resonators_Yangxing-Tech-X49SM12MSB2SI_C188206.html/?href=jlc-SMT)
2 | CRYSTAL 16.0000MHZ 16PF SMD | Y1 | CRYSTAL 16.0000MHZ 16PF SMD | HC-49/US | C252319 (https://lcsc.com/product-detail/SMD-Crystal-Resonators_SJK-SHENZHEN-CRYSTAL-TECH-6CS16000F20UCG_C252319.html/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)
3 | CONN RCPT USB2.0 TYPEB 4POS R/A | USB IN | CONN RCPT USB2.0 TYPEB 4POS R/A |  | C388656 (https://lcsc.com/product-detail/USB-Connectors_XKB-Connectivity-U241-041N-1WR85-5_C388656.html/?href=jlc-SMT)
4 | SN74AHC125NSR | U11 | Buffer/Line Driver 4-CH Non-Inverting 3-ST CMOS 14-Pin SOP T/R | 14SOP | C7775 (https://lcsc.com/product-detail/74-Series_TI_SN74LV126APWRG4_SN74LV126APWRG4_C7775.html/?href=jlc-SMT)
5 | ATTINY2313-20PU | U10 | ATMEL ATTINY2313-20PU 8 Bit Microcontroller, DIP
6 | L298N | U9 | Motor / Motion / Ignition Controllers & Drivers Dual Full Bridge | Multiwatt15 | C19922 (https://lcsc.com/product-detail/Motor-Drivers_STMicroelectronics-L298N_C19922.html/?href=jlc-SMT)
7 | AT24C32D-SSHM-T | U8 | EEPROM Serial-2Wire 32K-bit 4K x 8 1.8V/2.5V/3.3V/5V 8-Pin SOIC T/R | SOIC-8 | C60583 (https://lcsc.com/product-detail/EEPROM_MICROCHIP_AT24C32D-SSHM-T_AT24C32D-SSHM-T_C60583.html/?href=jlc-SMT)
8 | DS3231SN | U7 | MAXIM INTEGRATED PRODUCTS - DS3231SN#T&R - IC, RTC, Datum-/Zeitformat (Tag/Datum/Monat/Jahr, hh:mm:ss), I2C, 2.3V-5.5V Versorgung, SOIC-16 | SOIC-16 | C9866 (https://lcsc.com/product-detail/Real-time-Clocks_MAXIM_DS3231SN_DS3231SN_C9866.html/?href=jlc-SMT)
9 | MC74HC595ADR2 | U6 | IC SHIFT REGISTR 8BIT 3ST 16SOIC | SOIC-16 | C7344 (https://lcsc.com/product-detail/74-Series_ON-Semicon_MC74HC595ADR2G_ON-Semicon-ON-MC74HC595ADR2G_C7344.html/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)
10 | MIC29302AWD-TR | U5 | IC REG LINEAR POS ADJ 3A TO252-5 | TO252-5 | C411869 (https://lcsc.com/product-detail/Dropout-Regulators-LDO_Microchip-Tech-MIC29302AWU-TR_C411869.html/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)
11 | TL1963A-33DCQR | U4 | IC REG LINEAR 3.3V 1.5A SOT223-6 | SOT223-6
12 | LM2596DSADJR4G | U3 | Sw. Regulator 3A Adj. Step-Down D2PAK-5 | TO-263-5 | C99046 (https://lcsc.com/product-detail/DC-DC-Converters_ON-Semicon_LM2596DSADJR4G_ON-Semicon-ON-LM2596DSADJR4G_C99046.html/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)
13 | SN74AHC1G09DBVR | U2 | TEXAS INSTRUMENTS - SN74AHC1G09DBVR - AND Gate, 74AHC1G09, 2 Input, 2 V to 5.5 V, SOT-23-5 | SOT23-5 | C7835 (https://lcsc.com/product-detail/74-Series_TI_SN74LVC1G14DBVR_SN74LVC1G14DBVR_C7835.html/?href=jlc-SMT)
14 | ATMEGA2560-16AUR | U1 | ATMEGA2560 IC MCU 8BIT 256KB FLASH 100TQFP | TQFP-100 | C22460 (https://lcsc.com/product-detail/ATMEL-AVR_MICROCHIP_ATMEGA2560-16AU_ATMEGA2560-16AU_C22460.html/?href=jlc-SMT)
15 | 218-2LPST | SW3, SW4, SW5 | SWITCH SLIDE DIP SPST 25MA 24V | SW-SMD-4_1.27P | C319052 (https://lcsc.com/product-detail/DIP-Switches_XKB-Connectivity-DSHP02TS-S_C319052.html/?href=jlc-SMT)
16 | DIP SWITCH | SW1, SW2 | SWITCH SLIDE DIP SPST 25MA 24V | SW-SMD-8 | C319050 (https://lcsc.com/product-detail/DIP-Switches_XKB-Connectivity-DSHP04TS-S_C319050.html/?href=jlc-SMT)
17 | Sim800l Breakout | SIM800L
18 | 7SEG_1DG | SEVEN SEGMENT | LED Displays & Accessories Single Red 640nm Common Anode | LED-SEG-TH_SLR0561DBA1BD | C141368 (https://lcsc.com/product-detail/Led-Segment-Display_ARKLED-Wuxi-ARK-Tech-Elec-SM410561N_C141368.html/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)
19 | DM3BT-DSF-PEJS | SD CARD | CONN MICRO SD CARD PUSH-PUSH R/A
20 | 3296W-10K_Trim_Pot | RV1 | TRIMMER 10K OHM 0.5W PC PIN TOP | 3296W | C118954 (https://lcsc.com/product-detail/Precision-Potentiometer_BOCHEN-Chengdu-Guosheng-Tech-3296W-1-103_C118954.html/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)
21 | SRD-05VDC | RELAY | TE CONNECTIVITY - 1-1721150-0 - POWER RELAY, SPDT, 277VAC, 10A, TH | RELAY-TH_SRD-XXVDC-XL-C | C35449 (https://lcsc.com/product-detail/Relays_Ningbo-Songle-Relay-SRD-05VDC-SL-C_C35449.html/?href=jlc-SMT)
22 | 33.2 Ohms | R36, R37 | RES 33.2 OHM 1% 1/4W 0805 | 805 | C37252 (https://lcsc.com/product-detail/Chip-Resistor-Surface-Mount_Uniroyal-Elec-0805W8F3322T5E_C37252.html/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)
23 | 10 kOhms | R35 | RES 10K OHM 5% 1/4W 0805 | 805 | C25612 (https://lcsc.com/product-detail/Chip-Resistor-Surface-Mount_Uniroyal-Elec-0805W8J0103T5E_C25612.html/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)
24 | 1.5 kOhms | R32, R34 | RES 1.5K OHM 1% 1/4W 0805 | 805 | C4310 (https://lcsc.com/product-detail/Chip-Resistor-Surface-Mount_Uniroyal-Elec-0805W8F1501T5E_C4310.html/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)
25 | 220 Ohms | R31, R33 | RES 220 OHM 1% 1/4W 0805 | 805 | C17557 (https://lcsc.com/product-detail/Chip-Resistor-Surface-Mount_Uniroyal-Elec-0805W8F2200T5E_C17557.html/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)
26 | 2 kOhms | R30 | RES SMD 2K OHM 1% 0.4W 0805 | 805 | C17604 (https://lcsc.com/product-detail/Chip-Resistor-Surface-Mount_Uniroyal-Elec-0805W8F2001T5E_C17604.html/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)
27 | 1 kOhms | R28, R29 | RES 1K OHM 0.1% 1/10W 0805 | 805 | C17513 (https://lcsc.com/product-detail/Chip-Resistor-Surface-Mount_Uniroyal-Elec-0805W8F1001T5E_C17513.html/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)
28 | 10 kOhms | R23, R25, R27, R39 | RES SMD 10K OHM 0.1% 1/10W 0805 | 805 | C17414 (https://lcsc.com/product-detail/Chip-Resistor-Surface-Mount_Uniroyal-Elec-0805W8F1002T5E_C17414.html/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)
29 | 220 Ohms | R22, R24, R26, R38 | RES SMD 220 OHM 1% 1/8W 0805 | 805 | C17557 (https://lcsc.com/product-detail/Chip-Resistor-Surface-Mount_Uniroyal-Elec-0805W8F2200T5E_C17557.html/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)
30 | RES ARRAY 4 RES 4.7K | R19, R20 | RES ARRAY 4 RES 4.7K OHM 0804 | 805 | C1980 (https://lcsc.com/product-detail/Resistor-Networks-Arrays_Uniroyal-Elec-4D03WGJ0472T5E_C1980.html/?href=jlc-SMT)
31 | 330 Ohms | R10, R11, R12, R13, R14, R15, R16, R17 | RES SMD 330 OHM 1% 1/8W 0805 | 805 | C17630 (https://lcsc.com/product-detail/Chip-Resistor-Surface-Mount_Uniroyal-Elec-0805W8F3300T5E_C17630.html/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)
32 | 43 kOhms | R9 | RES SMD 43K OHM 0.1% 1/8W 0805 | 805 | C17695 (https://lcsc.com/product-detail/Chip-Resistor-Surface-Mount_Uniroyal-Elec-0805W8F4302T5E_C17695.html/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)
33 | 470 Ohms | R8 | RES SMD 470 OHM 1% 1/2W 0805 | 805 | C17710 (https://lcsc.com/product-detail/Chip-Resistor-Surface-Mount_Uniroyal-Elec-0805W8F4700T5E_C17710.html/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)
34 | 100 kOhms | R7 | RES SMD 100K OHM 1% 0.4W 0805 | 805 | C17407 (https://lcsc.com/product-detail/Chip-Resistor-Surface-Mount_Uniroyal-Elec-0805W8F1003T5E_C17407.html/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)
35 | 1 kOhms | R6, R40, R41 | RES 1K OHM 1% 1/4W 0805 | 805 | C17513 (https://lcsc.com/product-detail/Chip-Resistor-Surface-Mount_Uniroyal-Elec-0805W8F1001T5E_C17513.html/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)
36 | 330 Ohms | R5, R18, R21 | RES SMD 330 OHM 5% 1/8W 0805 | 805 | C25306 (https://lcsc.com/product-detail/Chip-Resistor-Surface-Mount_Uniroyal-Elec-0805W8J0331T5E_C25306.html/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)
37 | 3 kOhms | R4 | RES SMD 3K OHM 0.5% 1/4W 0805 | 805 | C17661 (https://lcsc.com/product-detail/Chip-Resistor-Surface-Mount_Uniroyal-Elec-0805W8F3001T5E_C17661.html/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)
38 | 4.7 kOhms | R3 | RES SMD 4.7K OHM 1% 1/8W 0805 | 805 | C17673 (https://lcsc.com/product-detail/Chip-Resistor-Surface-Mount_Uniroyal-Elec-0805W8F4701T5E_C17673.html/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)
39 | 22 Ohms | R2 | RES SMD 22 OHM 5% 1/8W 0805 | 805 | C65068 (https://lcsc.com/product-detail/High-Precision-Low-TCR-SMD-Resistors_Uniroyal-Elec-TC0525F220JT5E_C65068.html/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)
40 | 10 kOhms | R1 | RES SMD 10K OHM 0.5% 1/8W 0805 | 805 | C17414 (https://lcsc.com/product-detail/Chip-Resistor-Surface-Mount_Uniroyal-Elec-0805W8F1002T5E_C17414.html/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)
41 | BC847 TRANS NPN 45V 0.1A | Q1 | TRANS NPN 45V 0.1A SOT-23 | SOT-23-3 | C391423 (https://lcsc.com/product-detail/Transistors-NPN-PNP_PANJIT-International-BC847C-R1-00001_C391423.html/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)
42 | POT 10K | POTENTIOMETER | Res Conductive Plastic POT 10K Ohm 20% 1/5W 1(Elec)/1(Mech)Turn 6mm Pin Panel Mount/Through Hole
43 | MH_7.4MMNC_3.2MMD | MH4 | Mounting Hole 7.4mm Diameter (Non Copper), 3.2mm Dril NPTH
44 | MH_7.4MMC_3.2MMD | MH1, MH2, MH3 | Mounting Hole 7.4mm Diameter, 3.2mm Dril
45 | LED_5mm | LED1, LED2, LED3, LED4, LED5, LED6, LED7, LED8 | 5MM LED | LED-TH_BD5.8-P2.54-FD | C559115 (https://lcsc.com/product-detail/Light-Emitting-Diodes-LED_MEIHUA-MHL5013UWDT_C559115.html/?href=jlc-SMT)
46 | LCD-1602 | LCD DISPLAY 1602 | Alphanumeric LCD, 16 x 2, Yellow
47 | 2.2µH 2A | L2 | FIXED IND 2.2UH 2A 168 MOHM SMD
48 | 33µH 3.5A 57Mohm | L1 | FIXED IND 33UH 3.5A 57 MOHM SMD
49 | 3X4Keypad | KEYPAD1 | 3x4 Matrix Keypad
50 | 282834-3 | J10 | TERM BLK 3P SIDE ENT 2.54MM PCB
51 | 282834-2 | J4, J5, J14 | TERM BLK 2P SIDE ENT 2.54MM PCB
52 | HDR_1x2, OUTPWR, JDVCC | J3, J6, J13, JDVCC | Pin Header 2.54MM Pitch Str, 1X2PIN, Full G/f, NY6T, 6.1MM*2.5MM*3.0MM / Bag
53 | ISP HDR | ISP HEADER | CONN HEADER 6POS .100 STR 30AU
54 | TXB0104DR | IC1, IC2 | IC TRNSLTR BIDIRECTIONAL 14SOIC | SOIC-14
55 | HDR_2x8 | GPIO, J12 | CONN HDR FEMALE 16POS 0.1 GOLD PCB
56 | FID_1MM | FID1, FID2, FID3, FID4 | Fiducial 40mil Diameter, 120mil mask
57 | FERRITE BEAD 600 OHM 0805 1LN | FB1 | FERRITE BEAD 600 OHM 0805 1LN | 805 | C81034 (https://lcsc.com/product-detail/Ferrite-Beads_TDK-MPZ2012S601ATD25_C81034.html/?href=jlc-SMT)
58 | ESP-01M | ESP1 | TXRX ESP8266 MOD WIFI TRACE ANT
59 | DHT11 | DHT11 | SENSOR HUMID/TEMP 5V DTL 5% MOD | SIP-4_6.0x12.5x2.54P | C117051 (https://lcsc.com/product-detail/Temperature-Humidity-Sensors_Aosong-Guangzhou-Elec-DHT11_C117051.html/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)
60 | PJ-102AH | DC JACK +12V | CONN PWR JACK 2X5.5MM SOLDER
61 | LTV-817S-TA1 | D28 | OPTOISOLATR 5KV TRANSISTOR 4-SMD | SMD-4_4.6x6.5x2.54P | C22113 (https://lcsc.com/product-detail/SMD-Optocouplers_LTV-817S-TA1-A_C22113.html/?href=jlc-SMT)
62 | MMSZ5227B-E3-08 3.6V | D25, D26 | DIODE ZENER 3.6V 500MW SOD123 | SOD-123 | C154803 (https://lcsc.com/product-detail/Zener-Diodes_ON-Semicon_MMSZ5227BT1G_ON-Semicon-ON-MMSZ5227BT1G_C154803.html/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)
63 | Red | D24, D29 | LED RED CLEAR 2SMD | LED_0805 | C72037 (https://lcsc.com/product-detail/Light-Emitting-Diodes-LED_0805-Red-LED-Iv-61mcd-Typ-atIF-20mA_C72037.html/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)
64 | Green | D23 | LED GREEN CLEAR 0805 SMD | LED_0806 | C63855 (https://lcsc.com/product-detail/Light-Emitting-Diodes-LED_LED-green0805_C63855.html/?href=jlc-SMT)
65 | 1N4007FLTR | D14, D15, D16, D17, D19, D20, D21, D22, D27 | STANDARD RECTIFIER 1000V SOD-123 | SOD-123 | C110856 (https://lcsc.com/product-detail/Diodes-General-Purpose_Shikues-1N4007F_C110856.html/?href=jlc-SMT)
66 | Red | D3, D13, D18 | LED SMD | LED_0805 | C72037 (https://lcsc.com/product-detail/Light-Emitting-Diodes-LED_0805-Red-LED-Iv-61mcd-Typ-atIF-20mA_C72037.html/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)
67 | B340BQ-13-F | D2 | DIODE SCHOTTKY 40V 3A SMB | DO-214AA, SMB | C85099 (https://lcsc.com/product-detail/Schottky-Barrier-Diodes-SBD_DIODES_B340B-13-F_B340B-13-F_C85099.html/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)
68 | BAT54HT1G | D1 | DIODE SCHOTTKY 30V 200MA SOD323 | SOD-323 | C21107 (https://lcsc.com/product-detail/Schottky-Barrier-Diodes-SBD_ON-Semicon_BAT54HT1G_ON-Semicon-ON-BAT54HT1G_C21107.html/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)
69 | 100µF | C34, C35 | CAP ALUM 100UF 20% 10V SMD | SMD | C445049 (https://lcsc.com/product-detail/Aluminum-Electrolytic-Capacitors-SMD_Nichicon-UWX1A101MCL1GB_C445049.html/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)
70 | 30pF | C32, C33 | CAP CER 30PF 25V NP0 0805 | 805 | C1809 (https://lcsc.com/product-detail/Multilayer-Ceramic-Capacitors-MLCC-SMD-SMT_SAMSUNG_CL21C300JBANNNC_30pF-300-5-50V_C1809.html/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)
71 | 220µF | C27 | CAP ALUM 220UF 20% 35V SMD | SMD-ECAP-8x10 | C311611 (https://lcsc.com/product-detail/Others_Lelon-VEH221M1VTR-0810_C311611.html/?href=jlc-SMT)
72 | 330µF | C24 | CAP TANT 330UF 10% 4V 1411 | CASE-D_7343 | C313072 (https://lcsc.com/product-detail/Others_AVX_TPSD337K006R0100_AVX-TPSD337K006R0100_C313072.html/?href=jlc-SMT)
73 | 1µF | C23 | CAP CER 1UF 16V X5R 0805 | 805 | C89190 (https://lcsc.com/product-detail/Multilayer-Ceramic-Capacitors-MLCC-SMD-SMT_FH-Guangdong-Fenghua-Advanced-Tech-0805B105K250NT_C89190.html/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)
74 | 100µF | C22 | CAP TANT 100UF 20% 6.3V 1411 | CASE-B_3528 | C16133 (https://lcsc.com/product-detail/Tantalum-Capacitors_AVX_TAJB107K006RNJ_100uF-107-10-6-3V_C16133.html/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)
75 | 0.1µF | C19 | CAP CER 0.1UF 16V X7R 0805
76 | 220µF | C18 | CAP ALUM 220UF 20% 25V SMD | SMD-ECAP-10x10 | C176670 (https://lcsc.com/product-detail/Aluminum-Electrolytic-Capacitors-SMD_Lelon-VEJ221M1HTR-1010_C176670.html/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)
77 | 100µF | C17 | CAP ALUM 100UF 20% 50V SMD | SMD-ECAP-8x10 | C176665 (https://lcsc.com/product-detail/Aluminum-Electrolytic-Capacitors-SMD_Lelon-VEJ101M1HTR-0810_C176665.html/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)
78 | 22pF | C14, C15 | CAP CER 22PF 100V C0G/NP0 0805 | 805 | C1804 (https://lcsc.com/product-detail/Multilayer-Ceramic-Capacitors-MLCC-SMD-SMT_SAMSUNG_CL21C220JBANNNC_22pF-220-5-50V_C1804.html/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)
79 | 100nF, 0.1µF | C2, C4, C6, C8, C10, C12, C13, C16, C25, C26, C28, C29, C30, C31, C36, C37 | CAP CER 0805 10% X8R 50V 100NF | 805 | C49678 (https://lcsc.com/product-detail/Multilayer-Ceramic-Capacitors-MLCC-SMD-SMT_100nF-104-10-50V_C49678.html/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)
80 | 10µF | C1, C3, C5, C7, C9, C11, C20, C21 | CAP CER 10UF 16V X5R 0805 | 805 | C90545 (https://lcsc.com/product-detail/Multilayer-Ceramic-Capacitors-MLCC-SMD-SMT_FH-Guangdong-Fenghua-Advanced-Tech-0805F106M160NT_C90545.html/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)
81 | BUZZER | BUZZER | AUDIO MAGNETIC XDCR 3-7V TH | BUZ-TH_BD12.0-P7.60-D0.6-FD | C482357 (https://lcsc.com/product-detail/Buzzers_FUET-FMB1275-05_C482357.html/?href=jlc-SMT)
82 | Batt Holder | BH1 | BATTERY HOLDER COIN 20MM PC PIN
83 | PTS645SM43SMTR92 LFS | B1, B2, B3, RESET | SWITCH TACTILE SPST-NO 0.05A 12V | SMD | C480315 (https://lcsc.com/product-detail/Tactile-Switches_XKB-Connectivity-TS-1109S-B-B_C480315.html/?href=jlc-SMT)
