mokweri/2560_TrainingKit/DesignFiles/3d models/TO-252-5_MCH.step

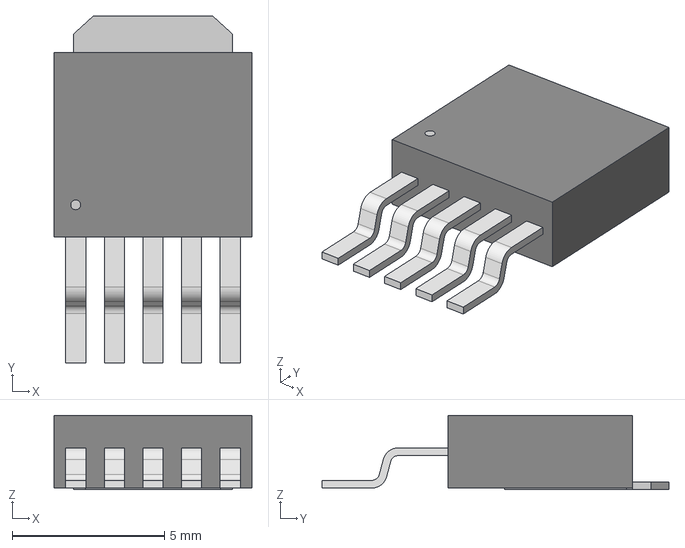
[picture p37: CAD file, 2021-02-23]
DesignFiles/3d models/TO-252-5_MCH.step
6.50 x 11.4 x 2.44 mm
