mokweri/2560_TrainingKit/Mechanical Casing/Bottom.SLDPRT

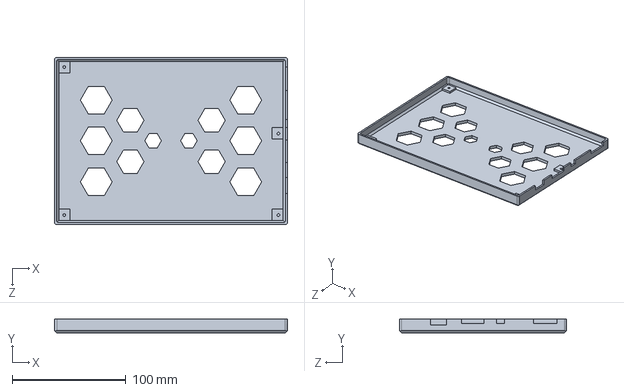
[picture p38: CAD file, 2021-07-04]
Mechanical Casing/Bottom.SLDPRT
205.0 x 12.0 x 147.0 mm
