mokweri/2560_TrainingKit/DesignFiles/3d models/Header1x2.STEP

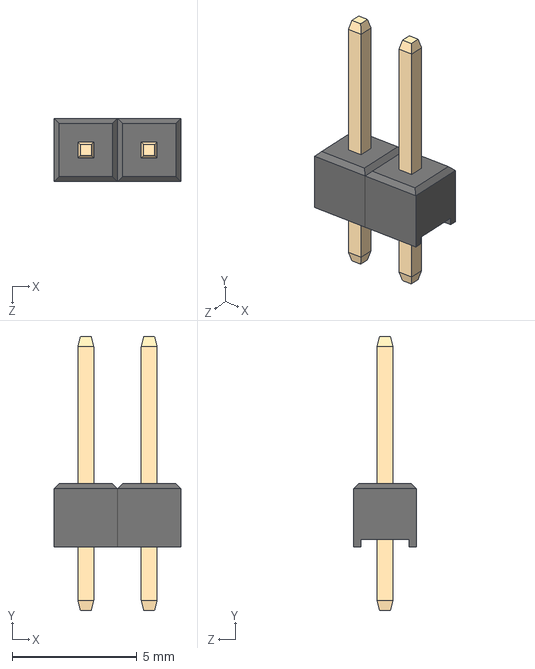
[picture p39: CAD file, 2021-02-23]
DesignFiles/3d models/Header1x2.STEP
5.08 x 11.0 x 2.54 mm
Header1_1 x 2
