mokweri/2560_TrainingKit/DesignFiles/3d models/5MM-LED-GREEN.STEP

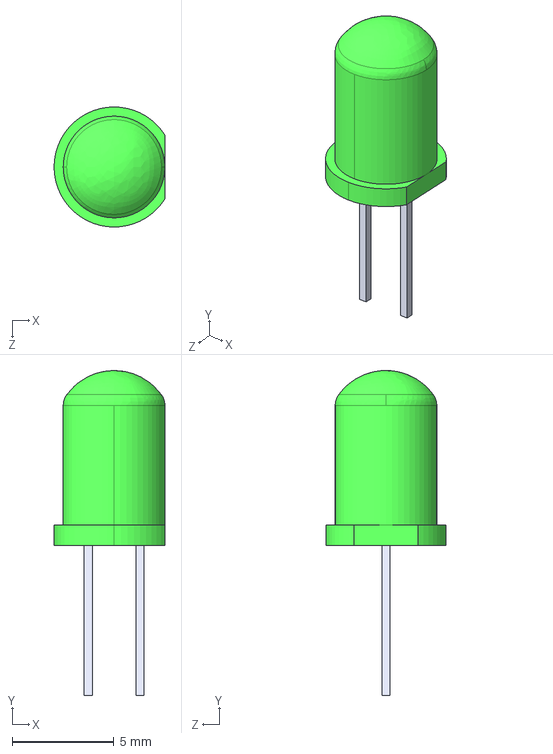
[picture p40: CAD file, 2021-02-18]
DesignFiles/3d models/5MM-LED-GREEN.STEP
5.45 x 16.0 x 5.90 mm
