mokweri/2560_TrainingKit/DesignFiles/3d models/14-SOIC.step

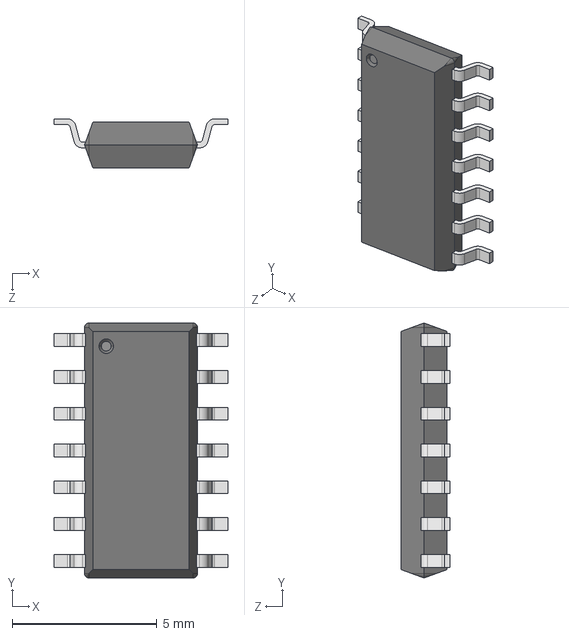
[picture p41: CAD file, 2021-02-07]
DesignFiles/3d models/14-SOIC.step
6.00 x 8.80 x 1.70 mm
