mokweri/2560_TrainingKit/DesignFiles/3d models/NS0014A.stp

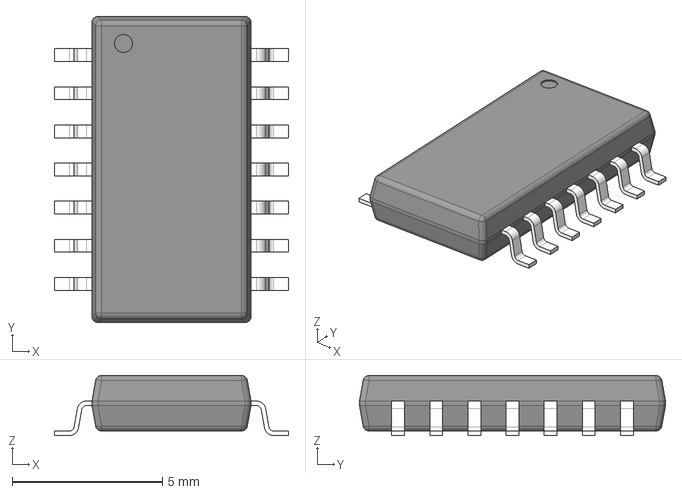
[picture p42: CAD file, 2021-02-07]
DesignFiles/3d models/NS0014A.stp
7.80 x 10.2 x 2.00 mm
BODY-SO
LEAD-SO x 14
