mokweri/2560_TrainingKit/DesignFiles/3d models/Keypad3x4.step

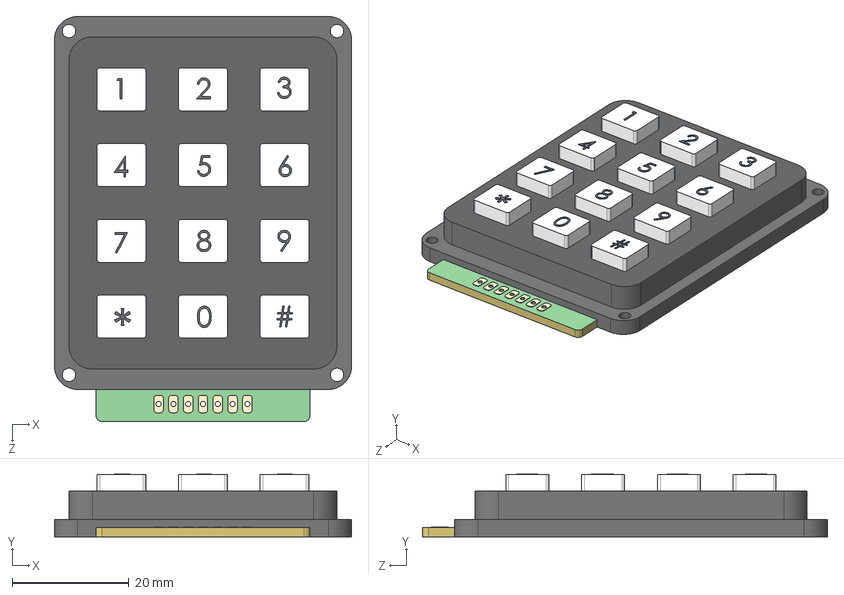
[picture p43: CAD file, 2021-02-01]
DesignFiles/3d models/Keypad3x4.step
51.0 x 10.8 x 69.5 mm
