mokweri/2560_TrainingKit/DesignFiles/3d models/DIP20.STEP

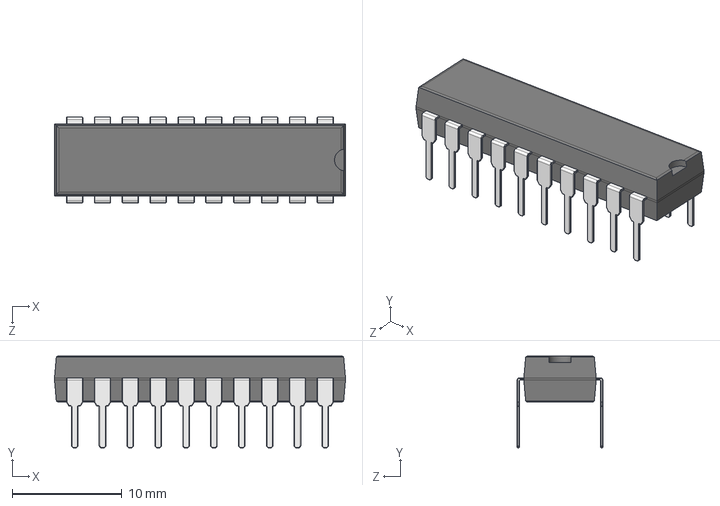
[picture p44: CAD file, 2021-02-01]
DesignFiles/3d models/DIP20.STEP
26.5 x 8.38 x 7.82 mm
K_X_F6rper DIP20_1
Pins Narrow_1 x 20
