mokweri/2560_TrainingKit/DesignFiles/3d models/User Library-DIP-20P-M01.step

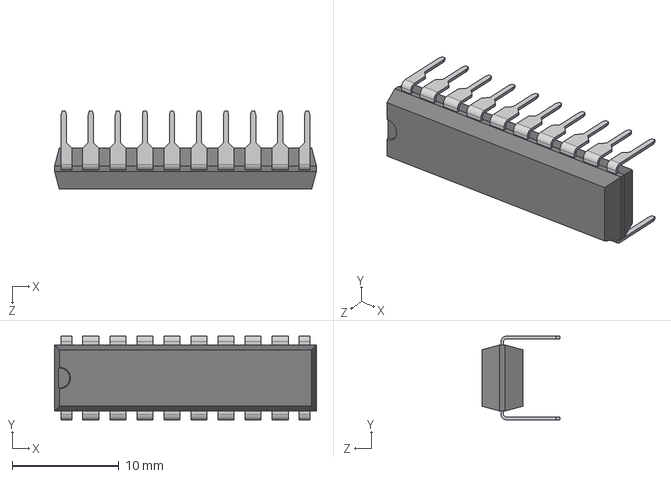
[picture p45: CAD file, 2021-02-01]
DesignFiles/3d models/User Library-DIP-20P-M01.step
24.6 x 7.87 x 7.36 mm
