mokweri/2560_TrainingKit/DesignFiles/3d models/NS16.step

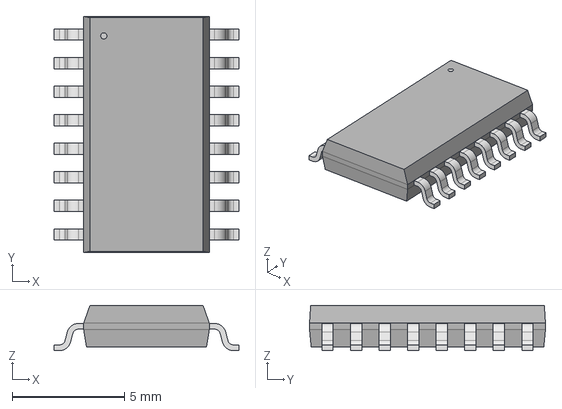
[picture p46: CAD file, 2021-01-28]
DesignFiles/3d models/NS16.step
8.20 x 10.5 x 2.01 mm
