mokweri/2560_TrainingKit/DesignFiles/3d models/3296_Bourns.step

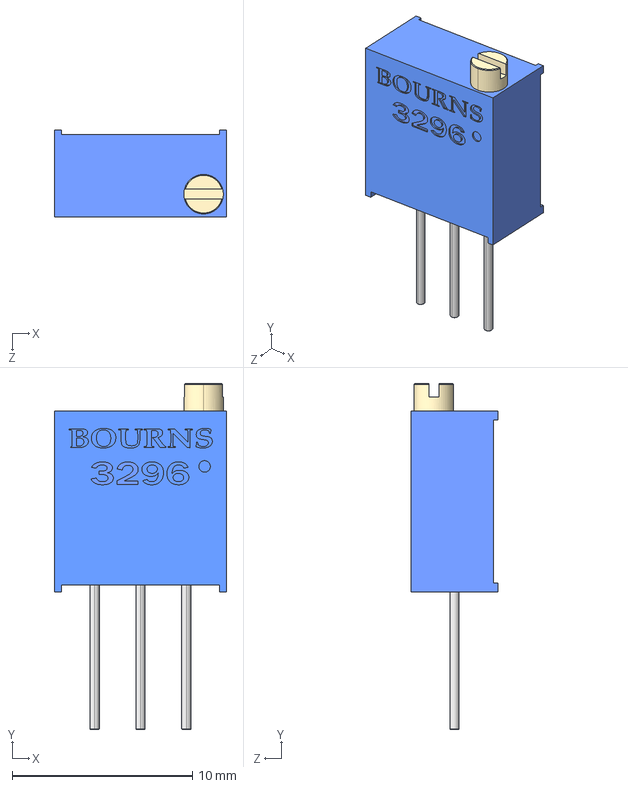
[picture p47: CAD file, 2021-01-25]
DesignFiles/3d models/3296_Bourns.step
9.53 x 19.2 x 4.83 mm
