mokweri/2560_TrainingKit/DesignFiles/3d models/l298n.stp

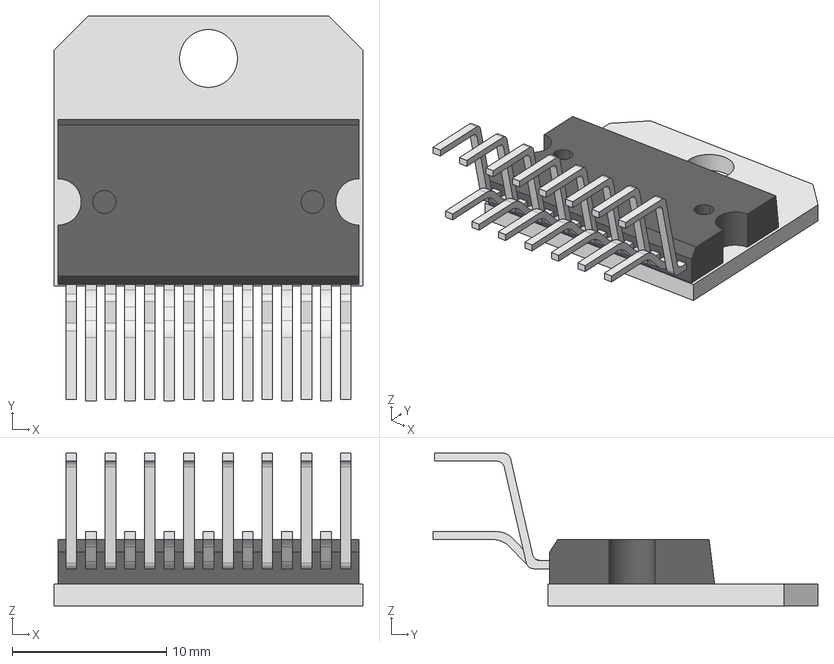
[picture p48: CAD file, 2021-01-25]
DesignFiles/3d models/l298n.stp
20.0 x 24.9 x 9.89 mm
