mokweri/2560_TrainingKit/DesignFiles/3d models/led10mm.STEP

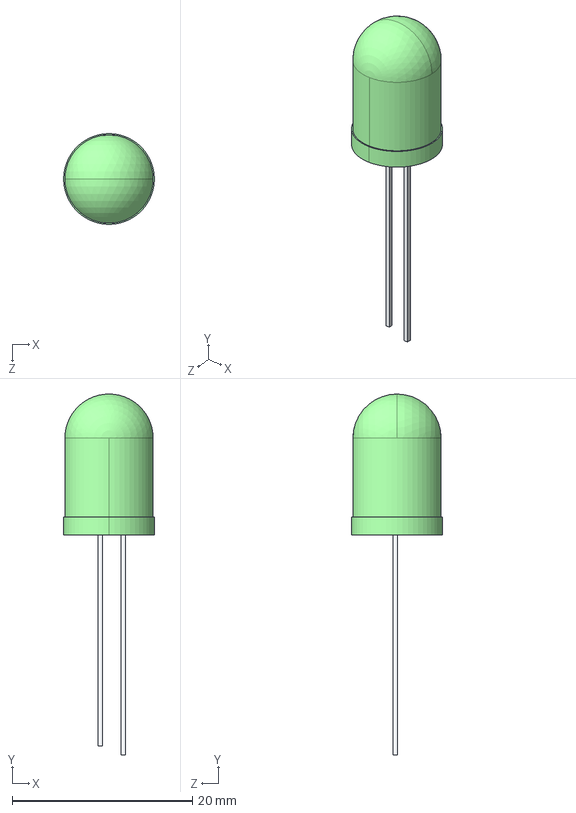
[picture p49: CAD file, 2021-01-25]
DesignFiles/3d models/led10mm.STEP
10.1 x 40.0 x 10.1 mm
leg_an
led_cat
led
