mokweri/2560_TrainingKit/DesignFiles/3d models/radiator_l298.STEP

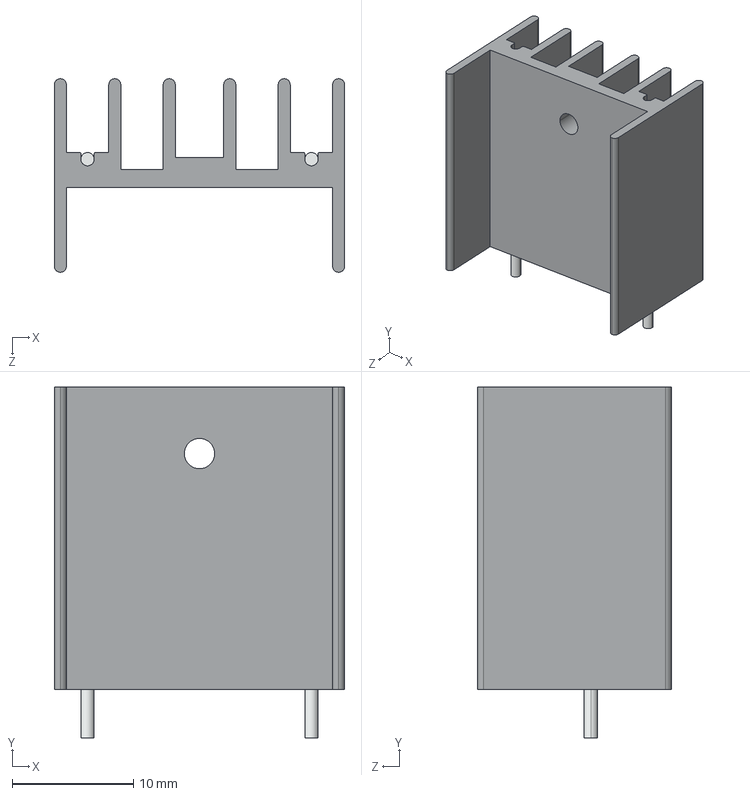
[picture p50: CAD file, 2021-01-25]
DesignFiles/3d models/radiator_l298.STEP
24.0 x 29.0 x 16.0 mm
RADIATOR_L298_SOLID_1
RADIATOR_L298_QUILT_1
