mokweri/2560_TrainingKit/DesignFiles/3d models/SOIC-8-1.step

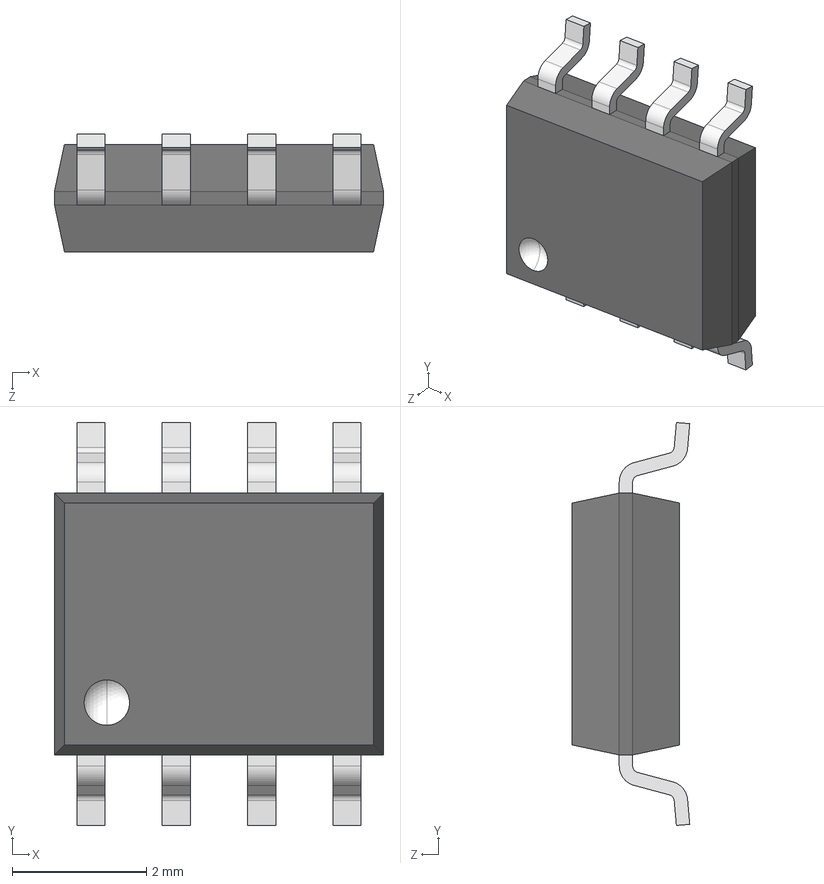
[picture p51: CAD file, 2021-01-21]
DesignFiles/3d models/SOIC-8-1.step
4.90 x 6.00 x 1.75 mm
