mokweri/2560_TrainingKit/DesignFiles/3d models/8 (TSSOP).step

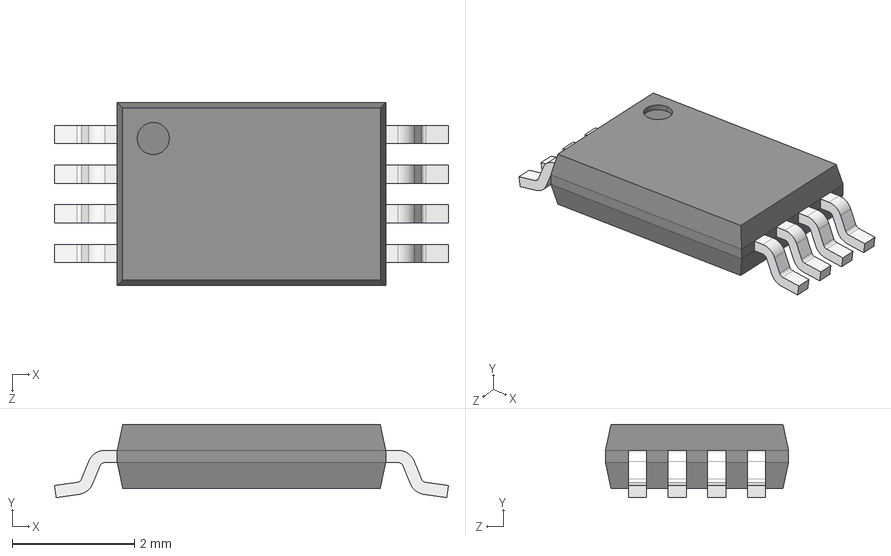
[picture p52: CAD file, 2021-01-21]
DesignFiles/3d models/8 (TSSOP).step
6.46 x 1.20 x 3.00 mm
