mokweri/2560_TrainingKit/DesignFiles/3d models/SOIC-16.step

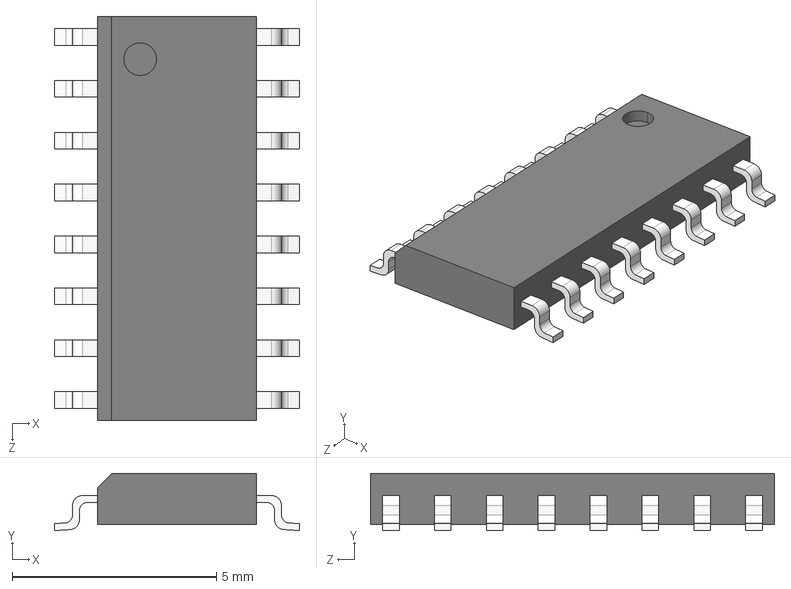
[picture p53: CAD file, 2021-01-21]
DesignFiles/3d models/SOIC-16.step
6.00 x 1.40 x 9.90 mm
