mokweri/2560_TrainingKit/DesignFiles/3d models/User Library-20mm_coin_holder.step

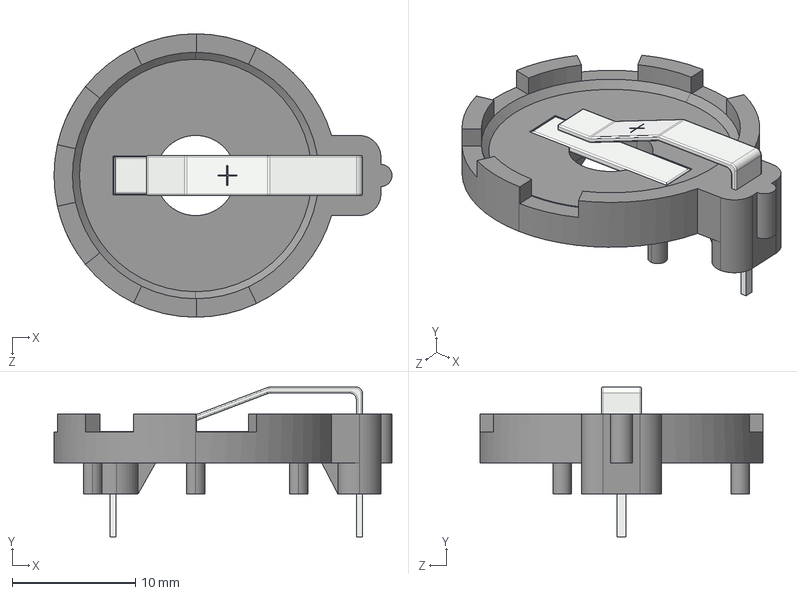
[picture p54: CAD file, 2021-01-21]
DesignFiles/3d models/User Library-20mm_coin_holder.step
27.4 x 12.2 x 23.0 mm
