mokweri/2560_TrainingKit/DesignFiles/3d models/User Library-CR 2032 Lithium Cell.step

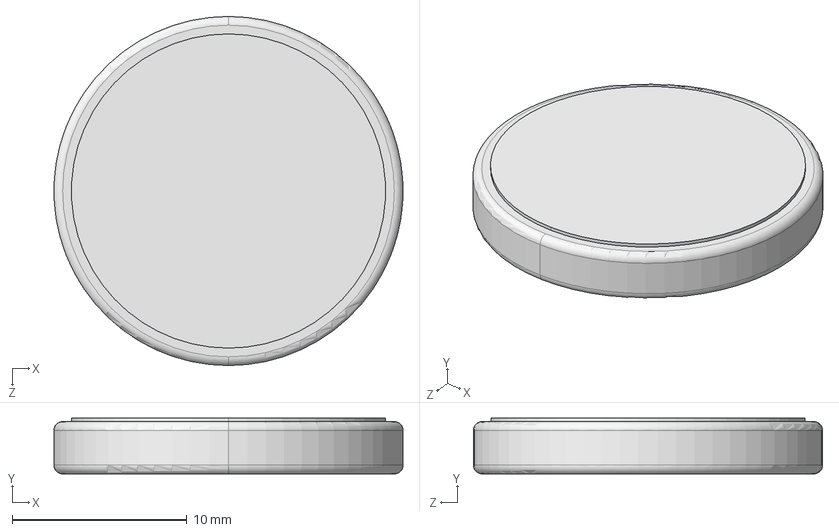
[picture p55: CAD file, 2021-01-21]
DesignFiles/3d models/User Library-CR 2032 Lithium Cell.step
20.0 x 3.20 x 20.0 mm
