mokweri/2560_TrainingKit/DesignFiles/3d models/D²PAK TO-263-5.step

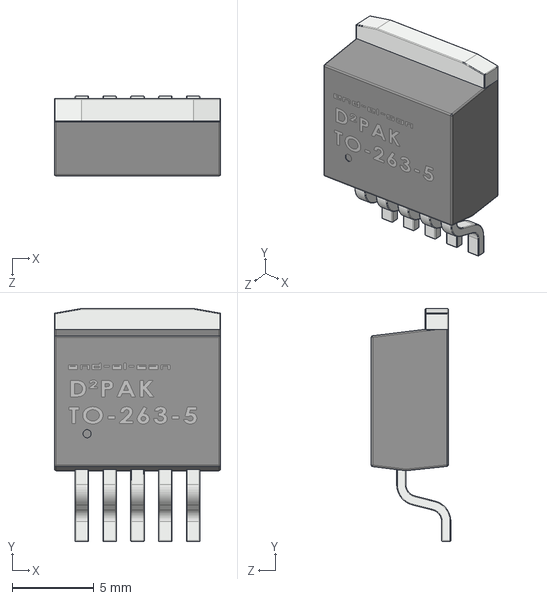
[picture p56: CAD file, 2021-01-21]
DesignFiles/3d models/D²PAK TO-263-5.step
10.2 x 14.2 x 4.87 mm
