mokweri/2560_TrainingKit/DesignFiles/3d models/User Library-DHT11-right.step

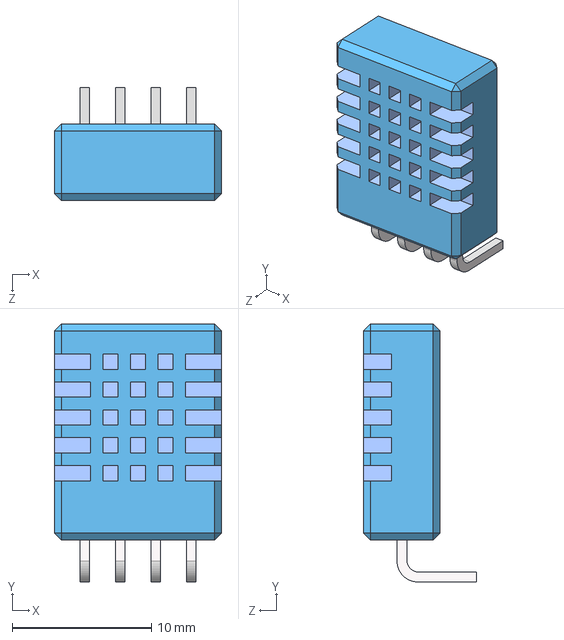
[picture p57: CAD file, 2021-01-20]
DesignFiles/3d models/User Library-DHT11-right.step
12.0 x 18.5 x 8.10 mm
