mokweri/2560_TrainingKit/DesignFiles/3d models/buzzer.STEP

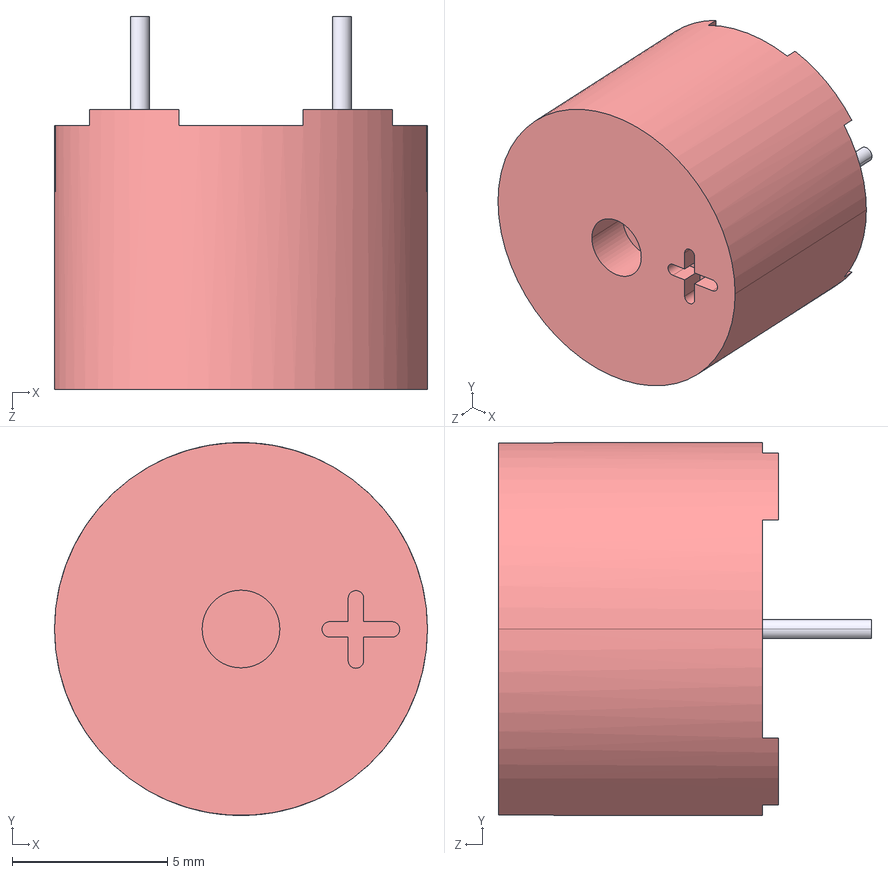
[picture p58: CAD file, 2021-01-20]
DesignFiles/3d models/buzzer.STEP
12.0 x 12.0 x 12.0 mm
Imported
Imported_2
Imported_3
