mokweri/2560_TrainingKit/DesignFiles/3d models/Relay - SRD-03VDC-SL-C.stp

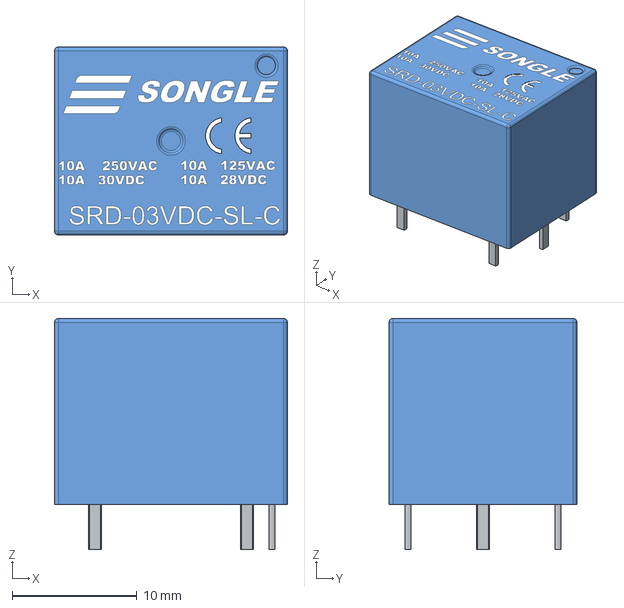
[picture p59: CAD file, 2021-01-14]
DesignFiles/3d models/Relay - SRD-03VDC-SL-C.stp
18.7 x 15.1 x 18.6 mm
