mokweri/2560_TrainingKit/DesignFiles/3d models/PotentiometerB10K.step

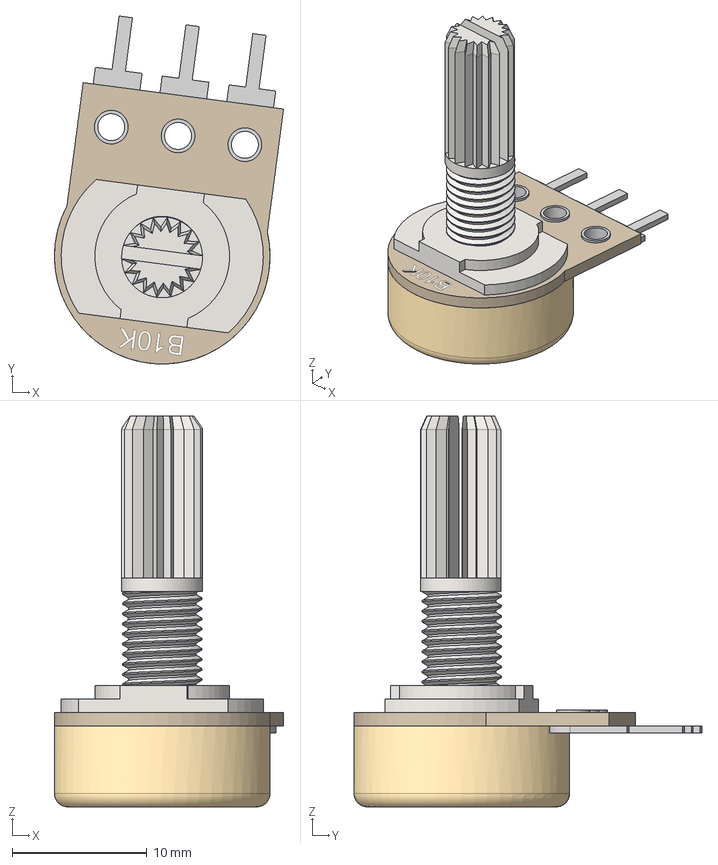
[picture p60: CAD file, 2021-01-14]
DesignFiles/3d models/PotentiometerB10K.step
17.0 x 25.8 x 29.0 mm
Shaft
ScrewBase
Board
Pin1
Pin2
Pin3
Casing
