mokweri/2560_TrainingKit/DesignFiles/3d models/ESP8266 ESP-01.step

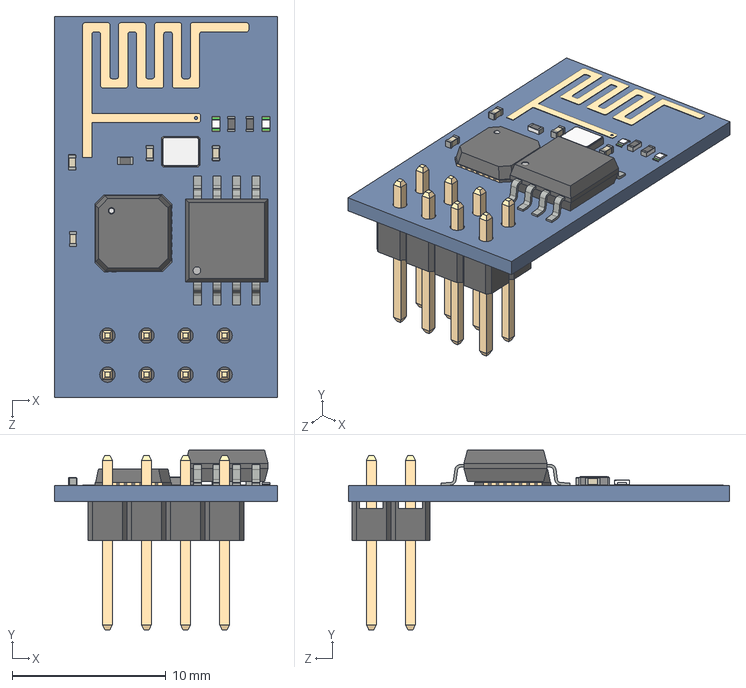
[picture p61: CAD file, 2021-01-13]
DesignFiles/3d models/ESP8266 ESP-01.step
14.5 x 11.7 x 24.8 mm
