mokweri/2560_TrainingKit/DesignFiles/3d models/Potentiometer.step

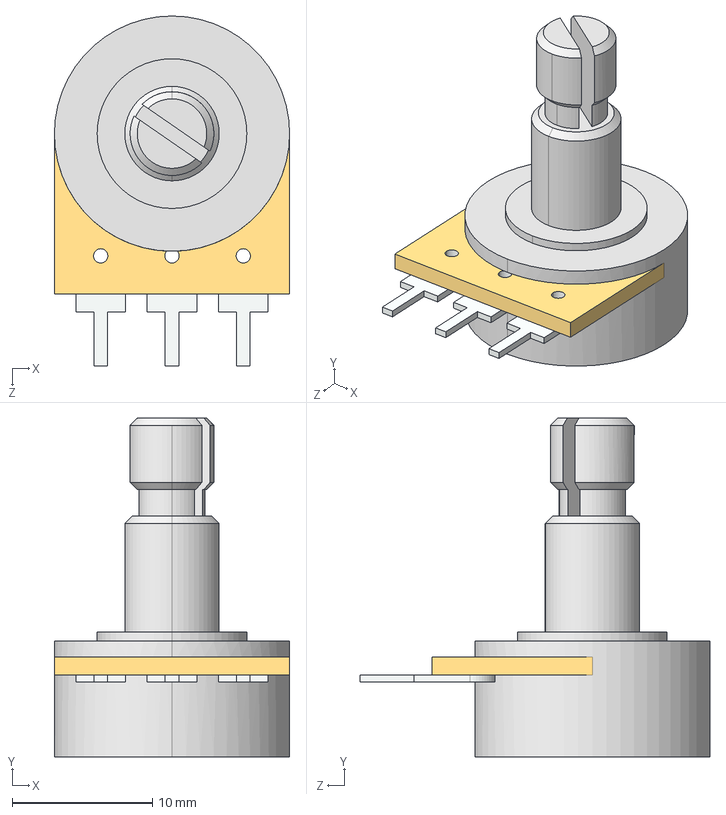
[picture p62: CAD file, 2021-01-13]
DesignFiles/3d models/Potentiometer.step
16.8 x 24.1 x 24.9 mm
