mokweri/2560_TrainingKit/DesignFiles/3d models/King Bright SA05-11.step

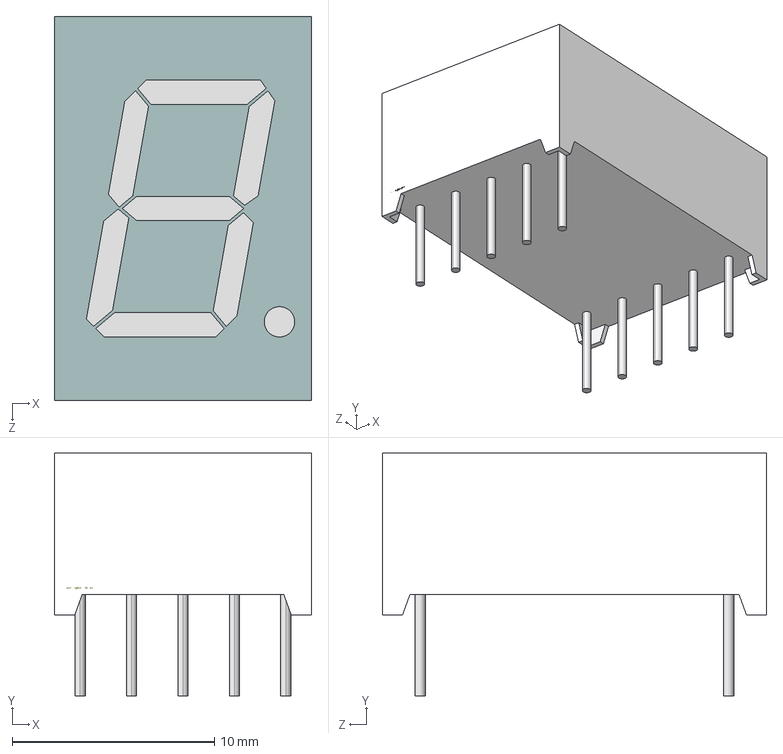
[picture p63: CAD file, 2021-01-13]
DesignFiles/3d models/King Bright SA05-11.step
12.7 x 12.0 x 19.0 mm
