mokweri/2560_TrainingKit/DesignFiles/3d models/TQFP100_Grid_0_5.STEP

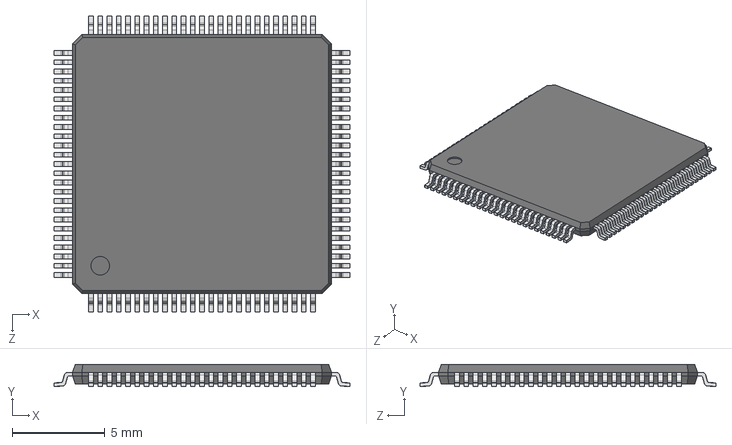
[picture p64: CAD file, 2021-01-12]
DesignFiles/3d models/TQFP100_Grid_0_5.STEP
16.0 x 1.20 x 16.0 mm
TQFP100_Koerper_2
TQFP_PIN_2 x 100
