mokweri/2560_TrainingKit/(list of files, cad)

Other CAD files:
Mechanical Casing/Bottom.STL
