mokweri/2560_TrainingKit/Release Files/5 - Schematic/TK2560_Schematic_V1I1.PDF

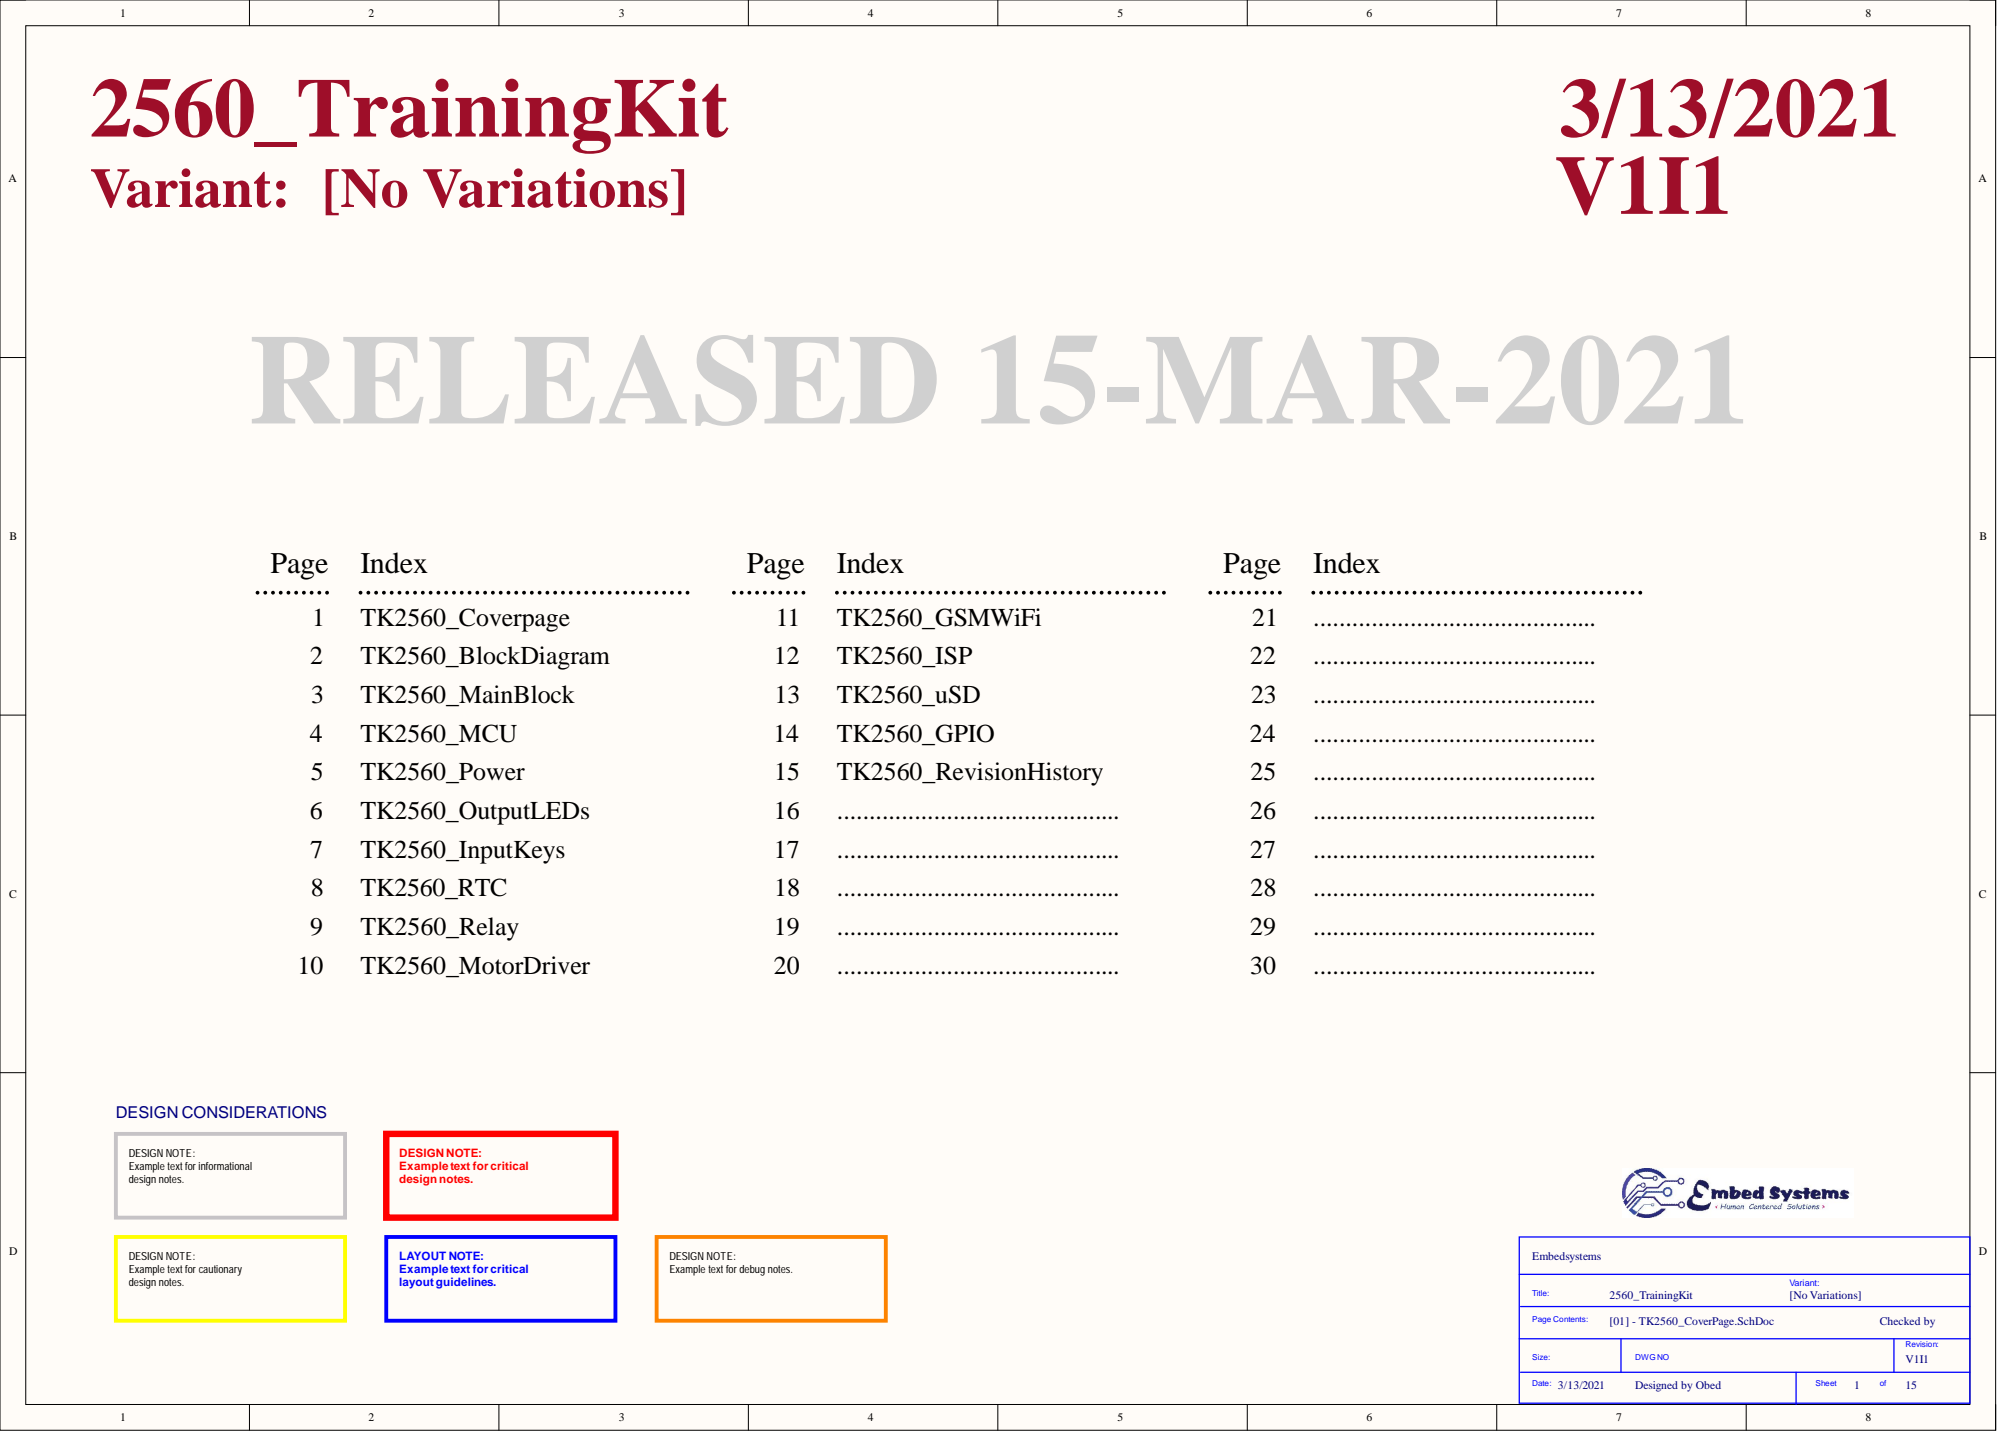
[picture p65: page 1]

DESIGN NOTE:
Example text for informational
design notes.

Example text for critical

Example text for cautionary

LAYOUT NOTE:
layout guidelines.

Example text for debug notes.

Size: | DWG NO | Revision: V1I1

Date: 3/13/2021 Designed by Obed | Sheet of

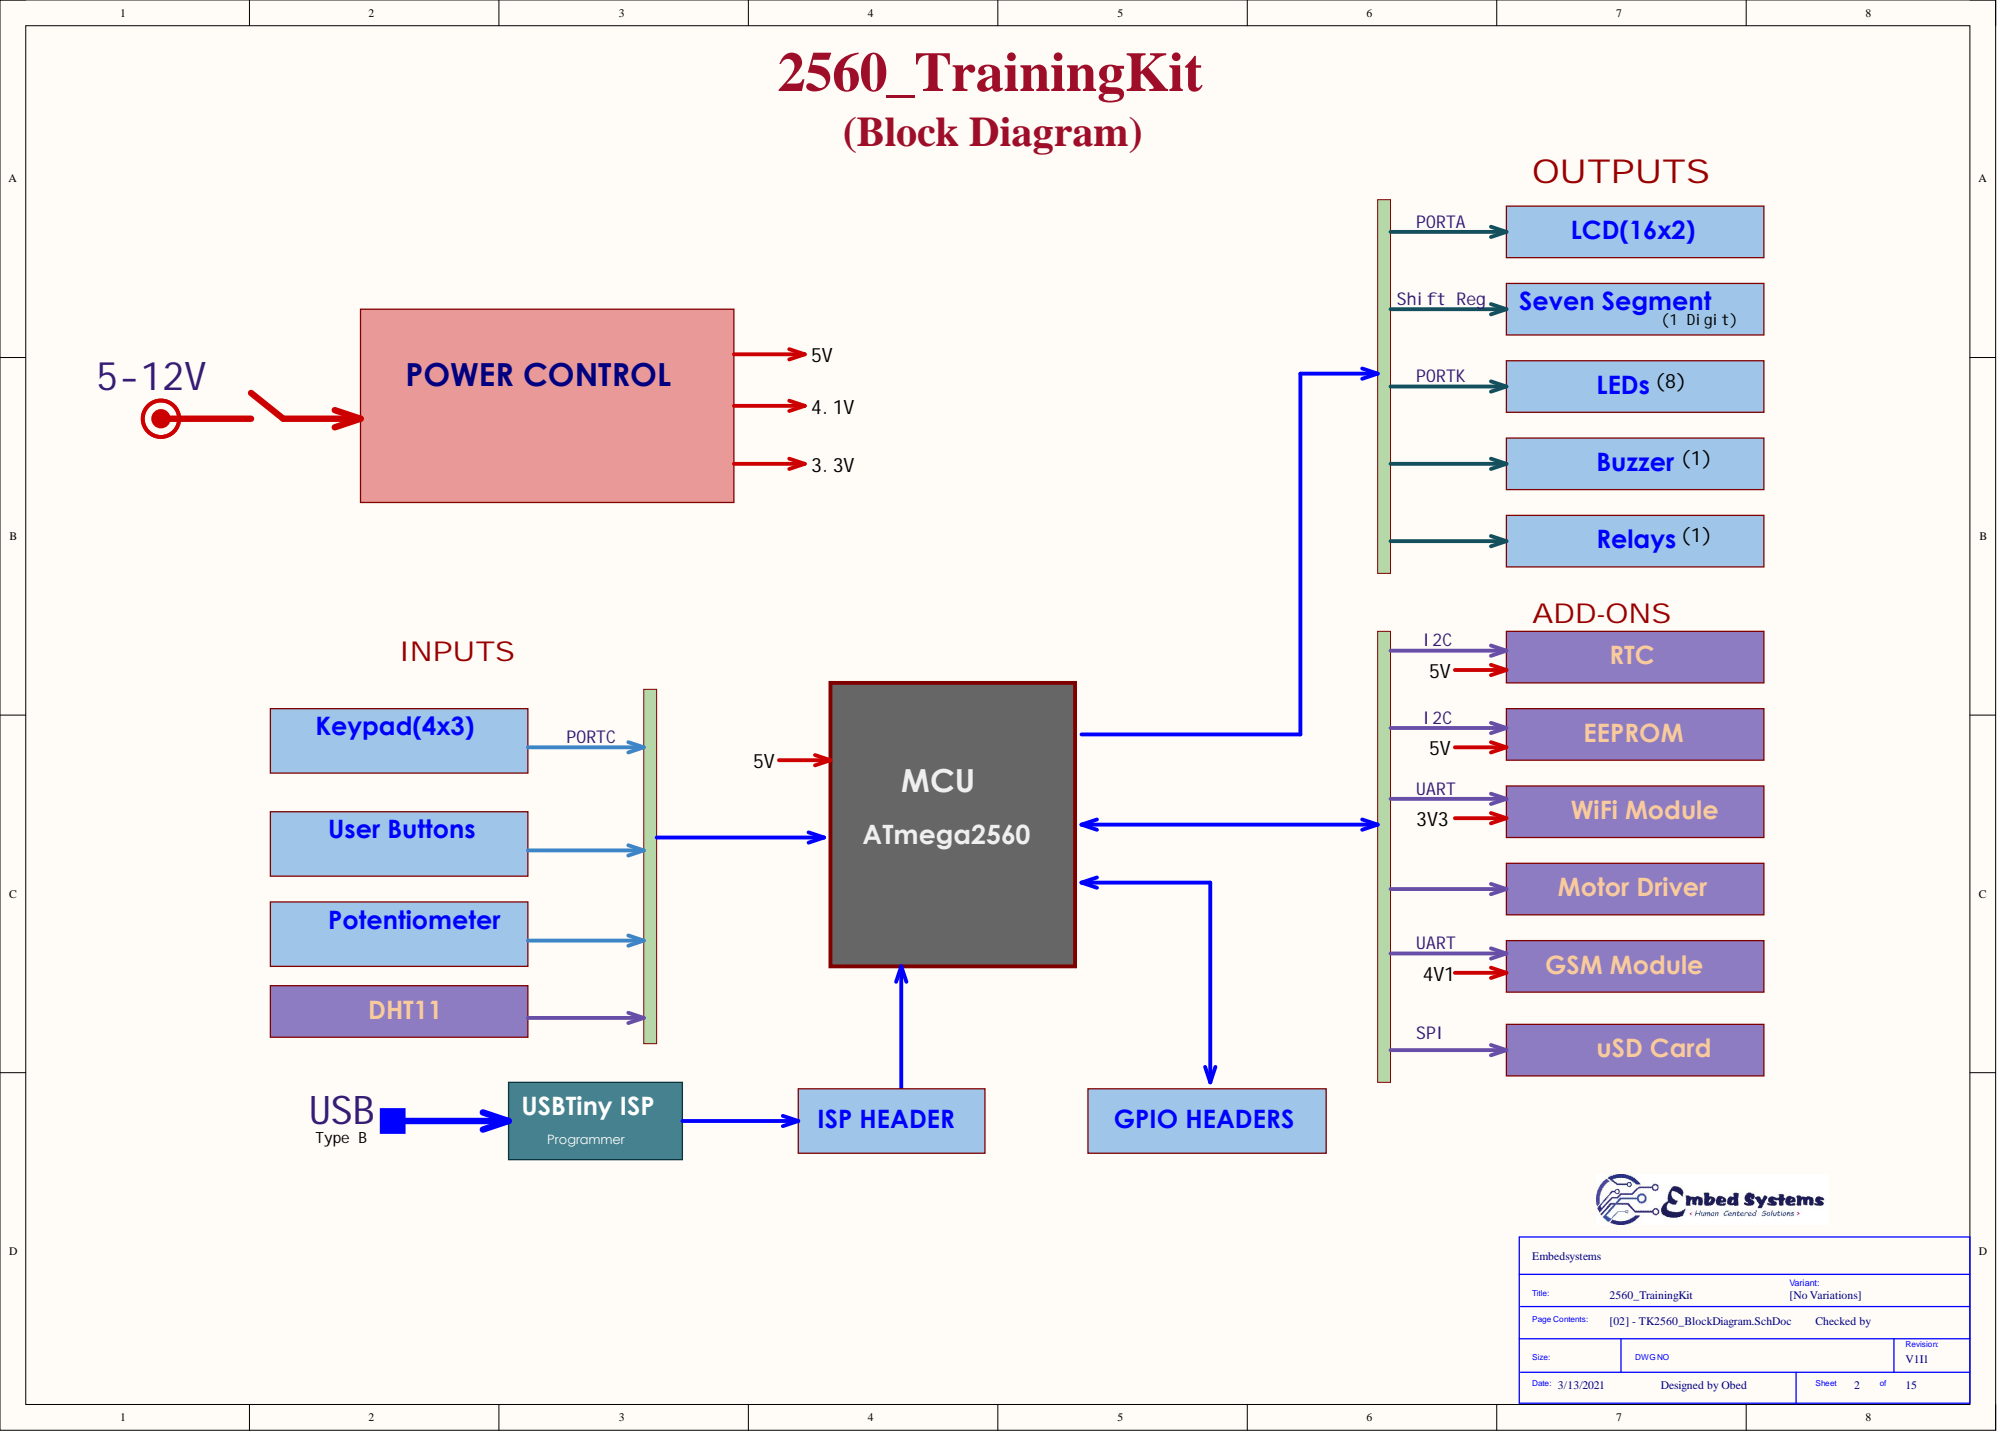
[picture p66: page 2]

GPIO HEADERS USBTiny ISP

Revision:

3/13/2021 Designed by Obed

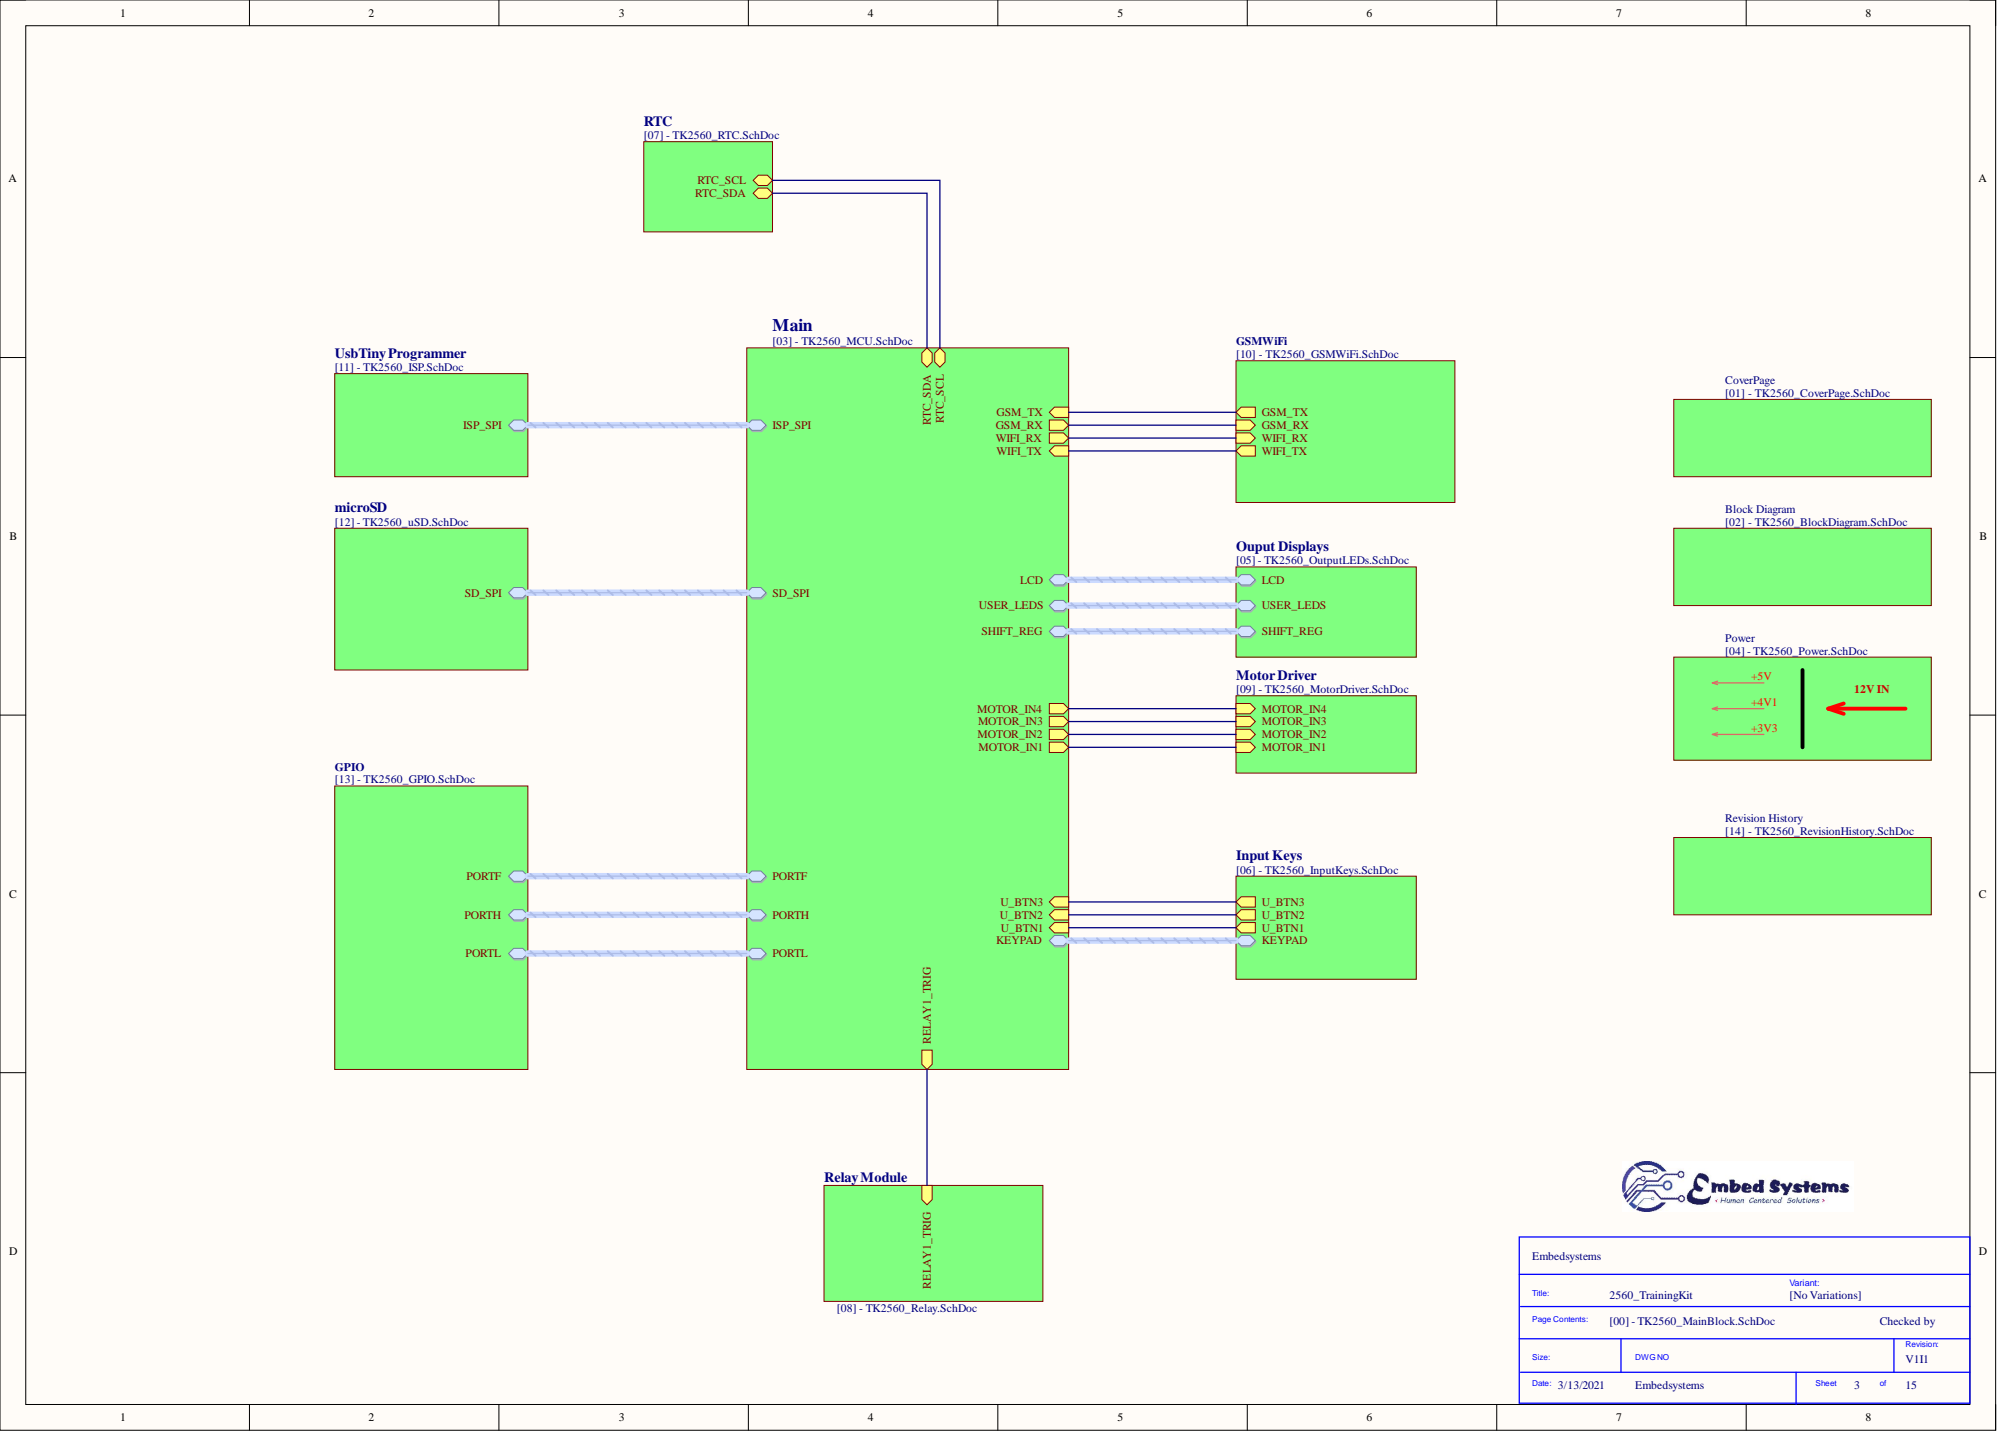
[picture p67: page 3]

Revision:

3/13/2021 Embedsystems

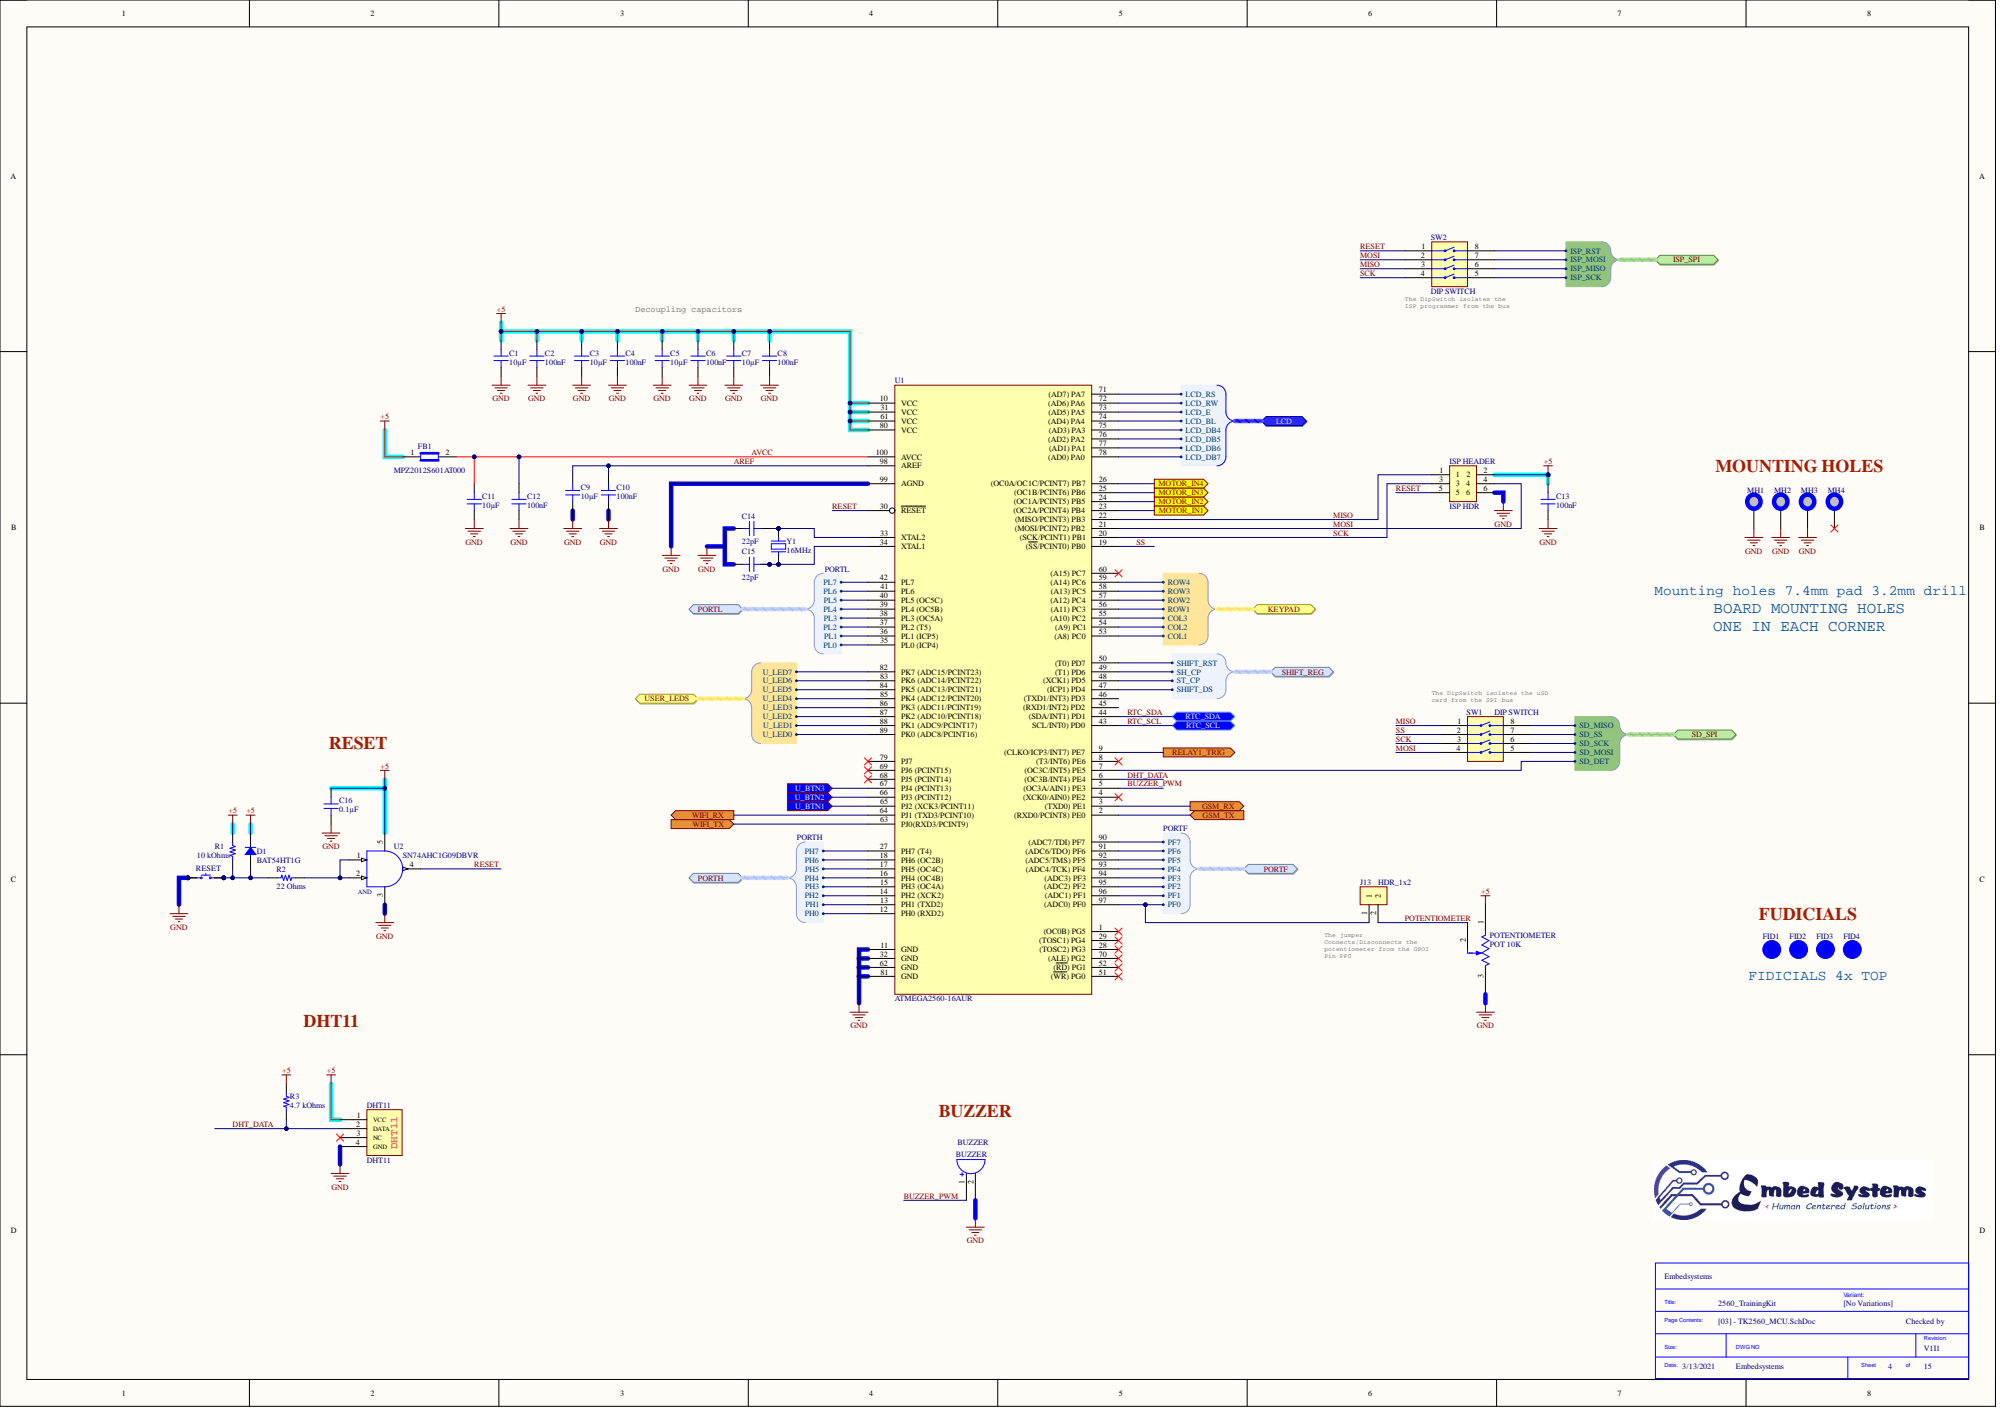
[picture p68: page 4]

The DipSwitch isolates the
ISP programmer from the bus

VCC 31
VCC 61

RESET C14 | | RESET 30 XTAL2 33 | RESET MOTOR_IN3 MOTOR_IN2 MOTOR_IN1 MISO

MOSI

22pF | | | SCK

Mounting holes 7.4mm pad 3.2mm drill

BOARD MOUNTING HOLES
ONE IN EACH CORNER

The DipSwitch isolates the uSD
card from the SPI bus

The jumper
Connects/Disconnects the
potentiometer from the GPOI
Pin PF0

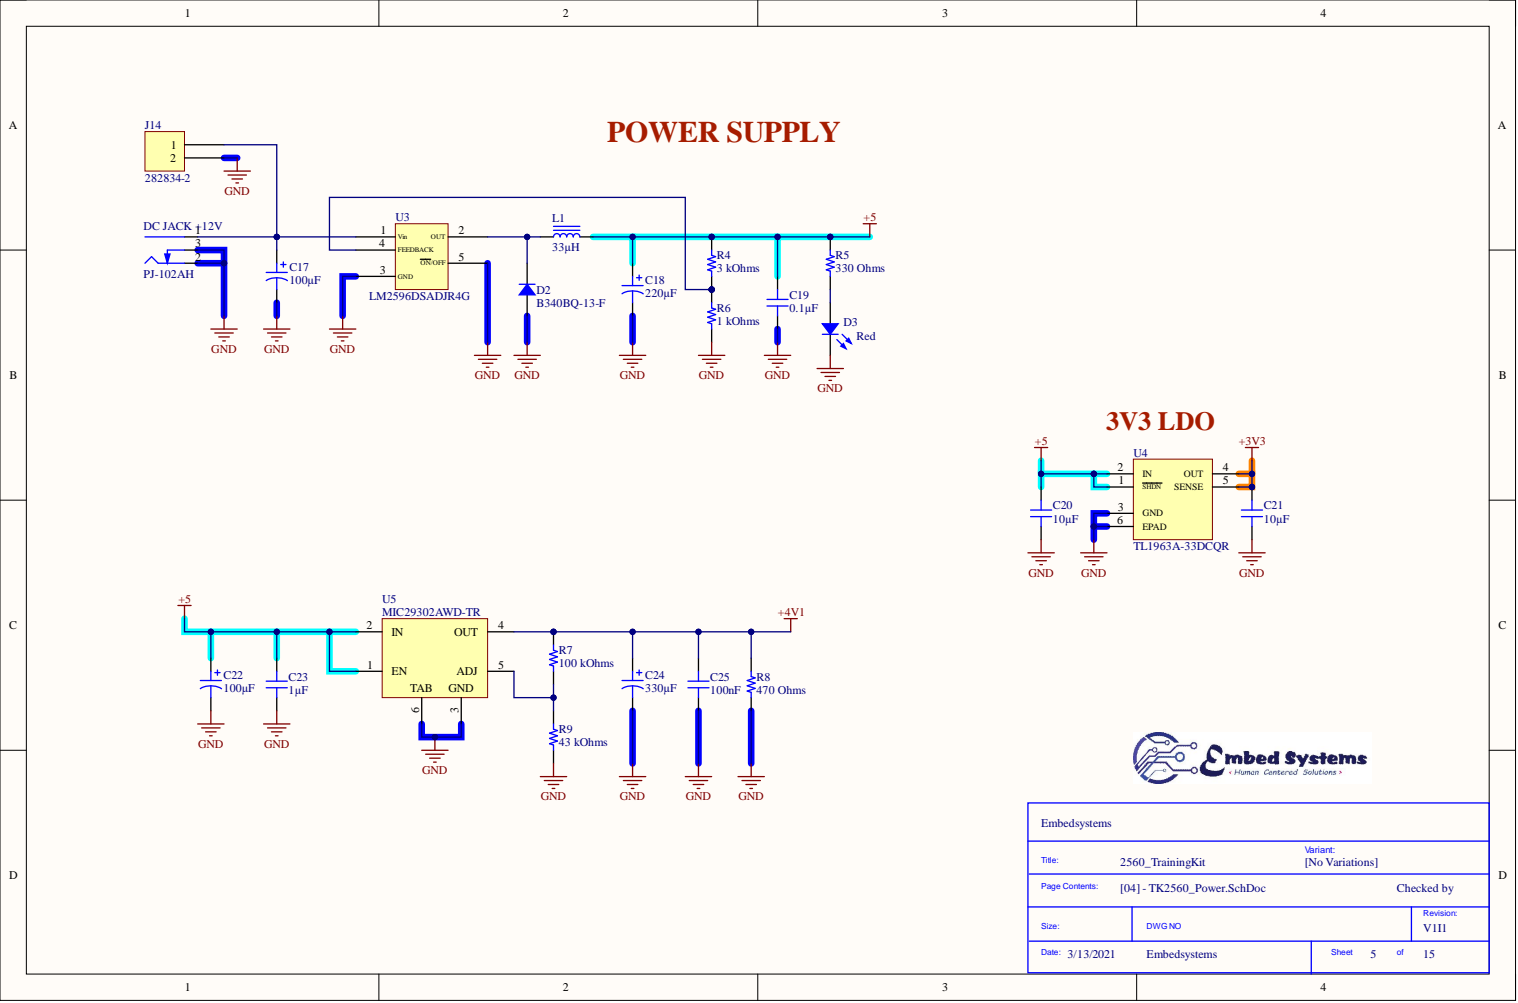
[picture p69: page 5]

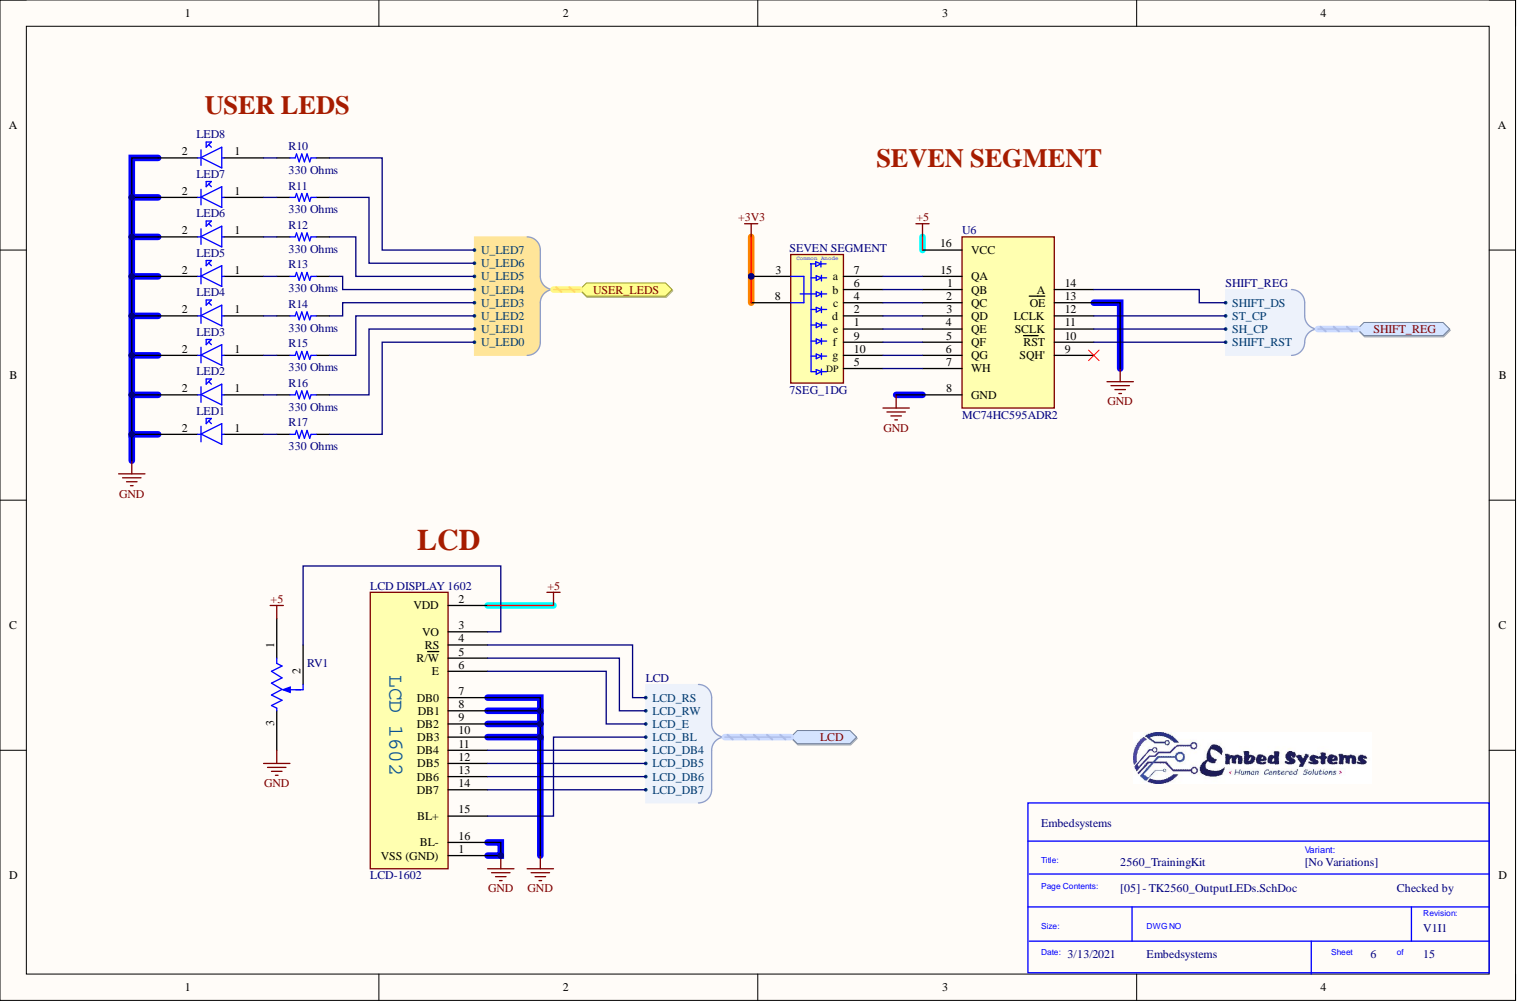
[picture p70: page 6]

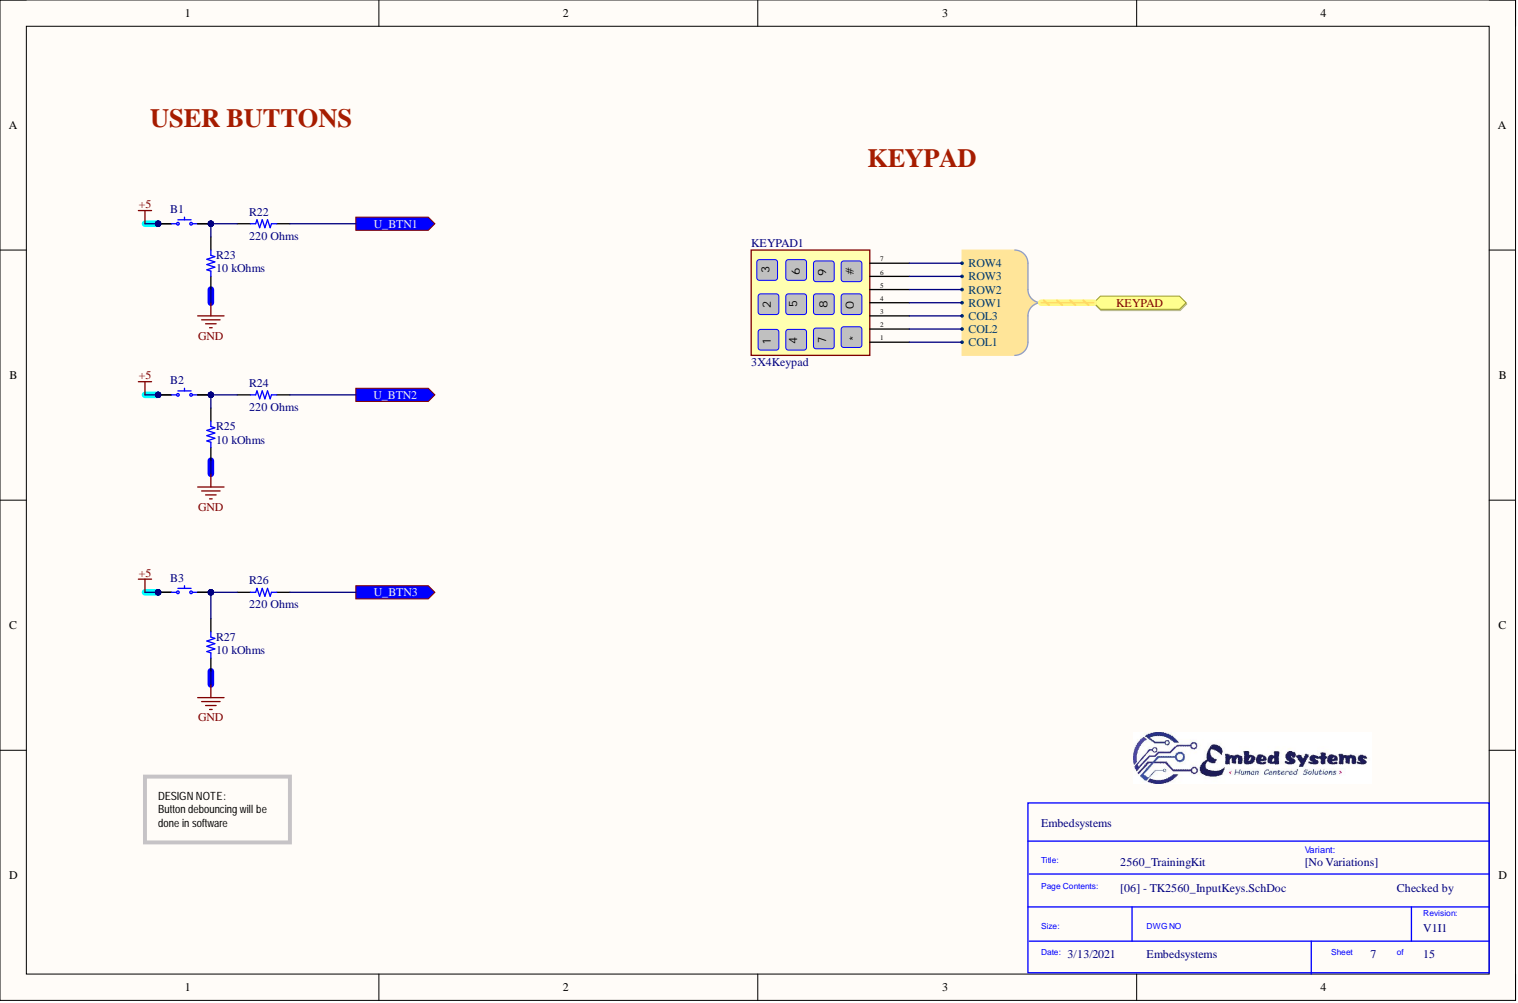
[picture p71: page 7]

DESIGN NOTE:
Button debouncing will be
done in software

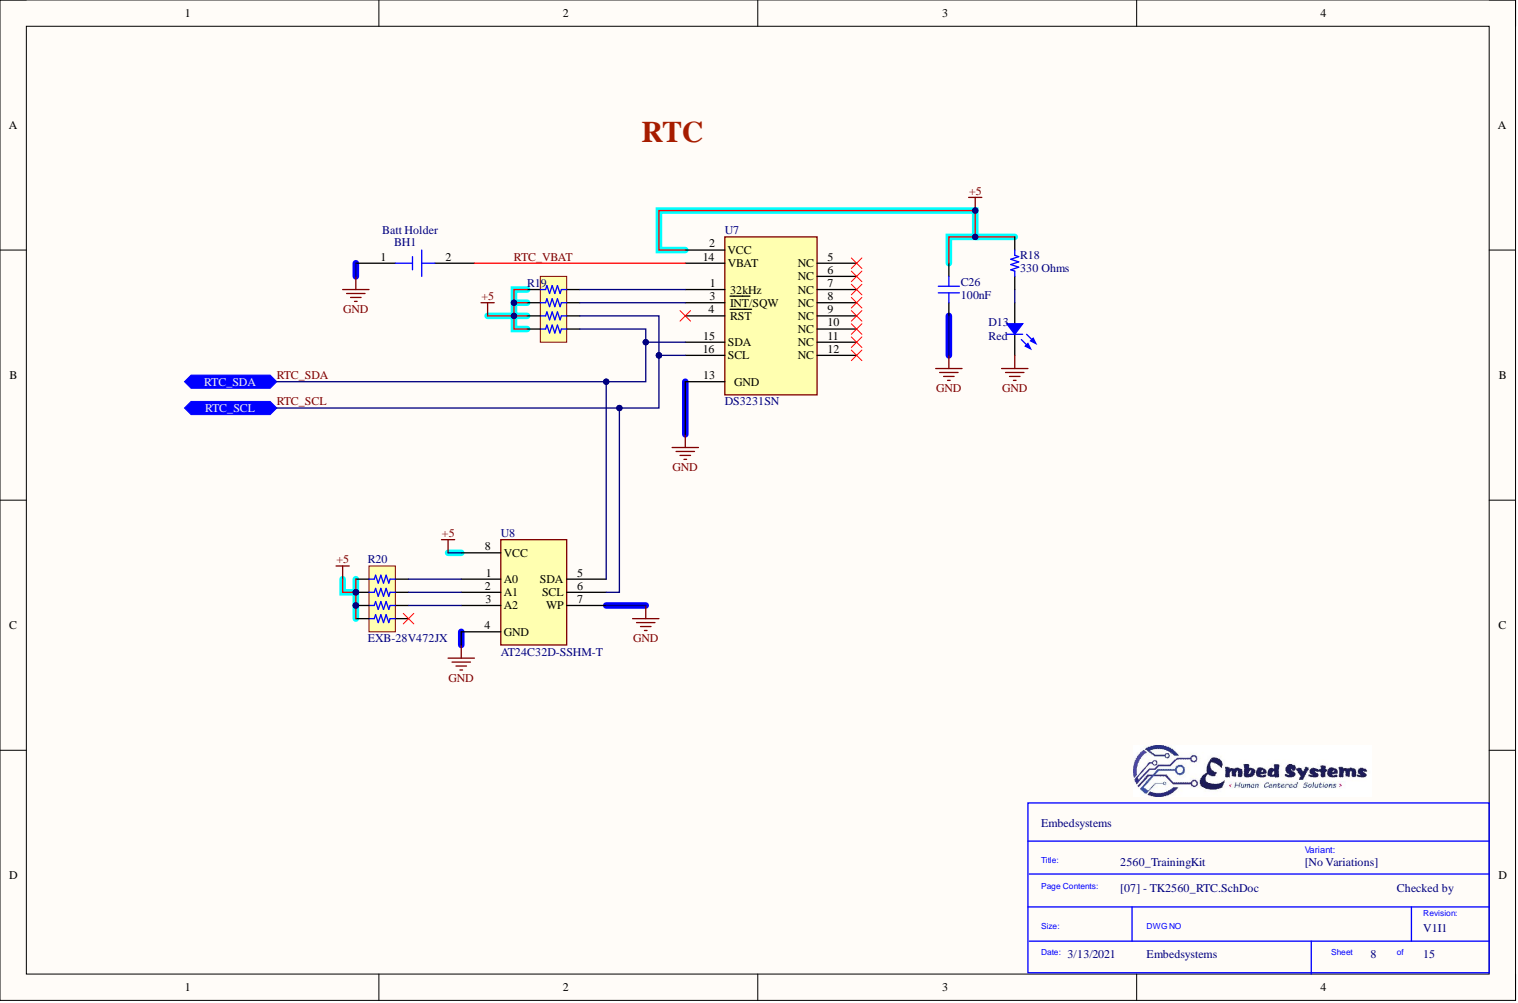
[picture p72: page 8]

32kHz 1

RST 4

SCL 16

RTC_SDA | GND 13

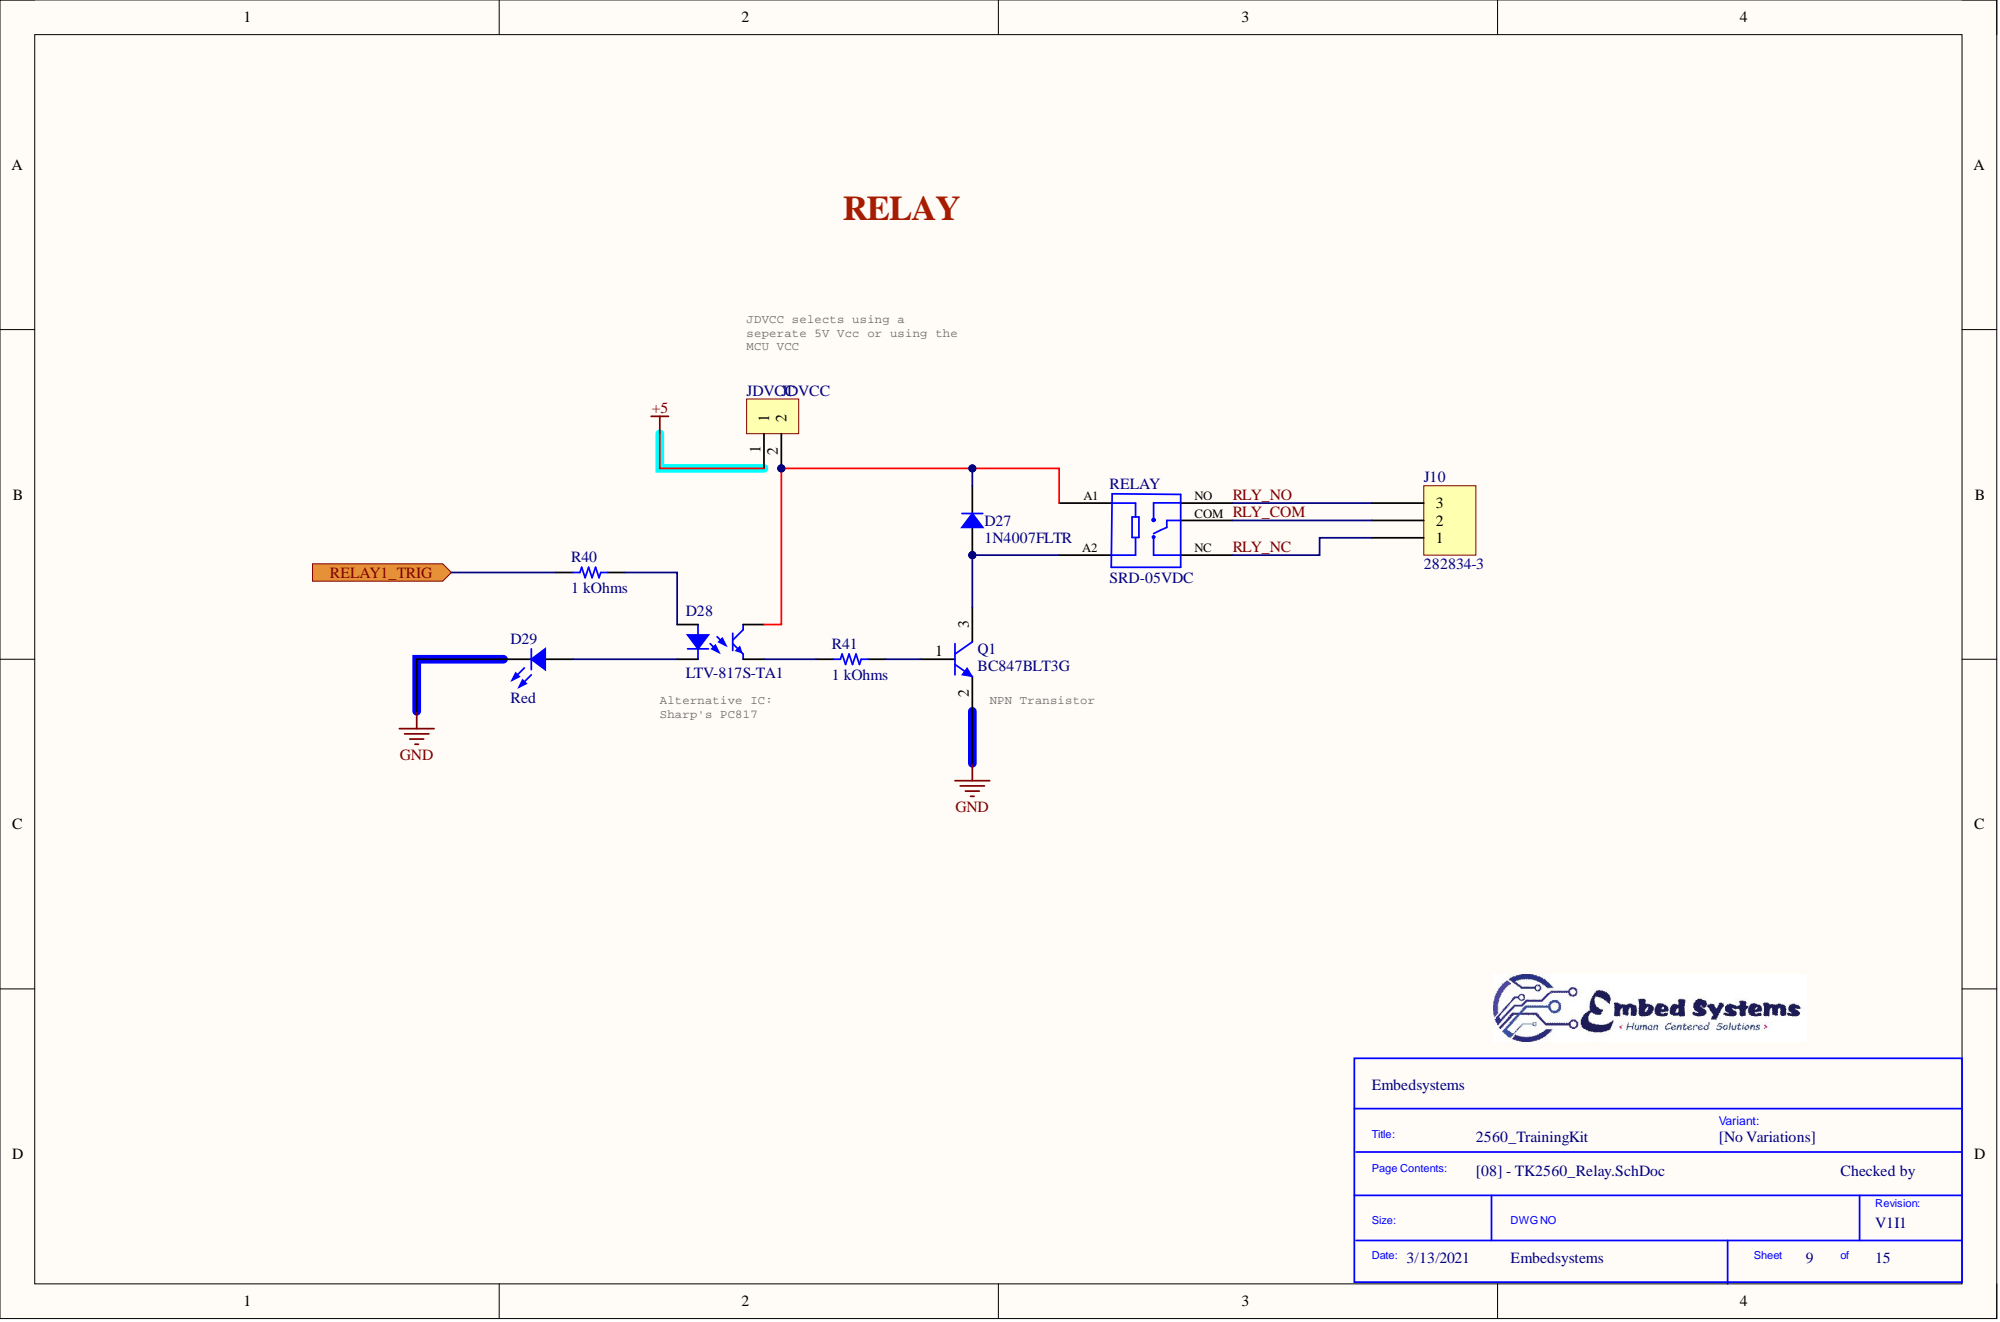
[picture p73: page 9]

D a t e : / / E mbed s y s tem s | S h e e t o f

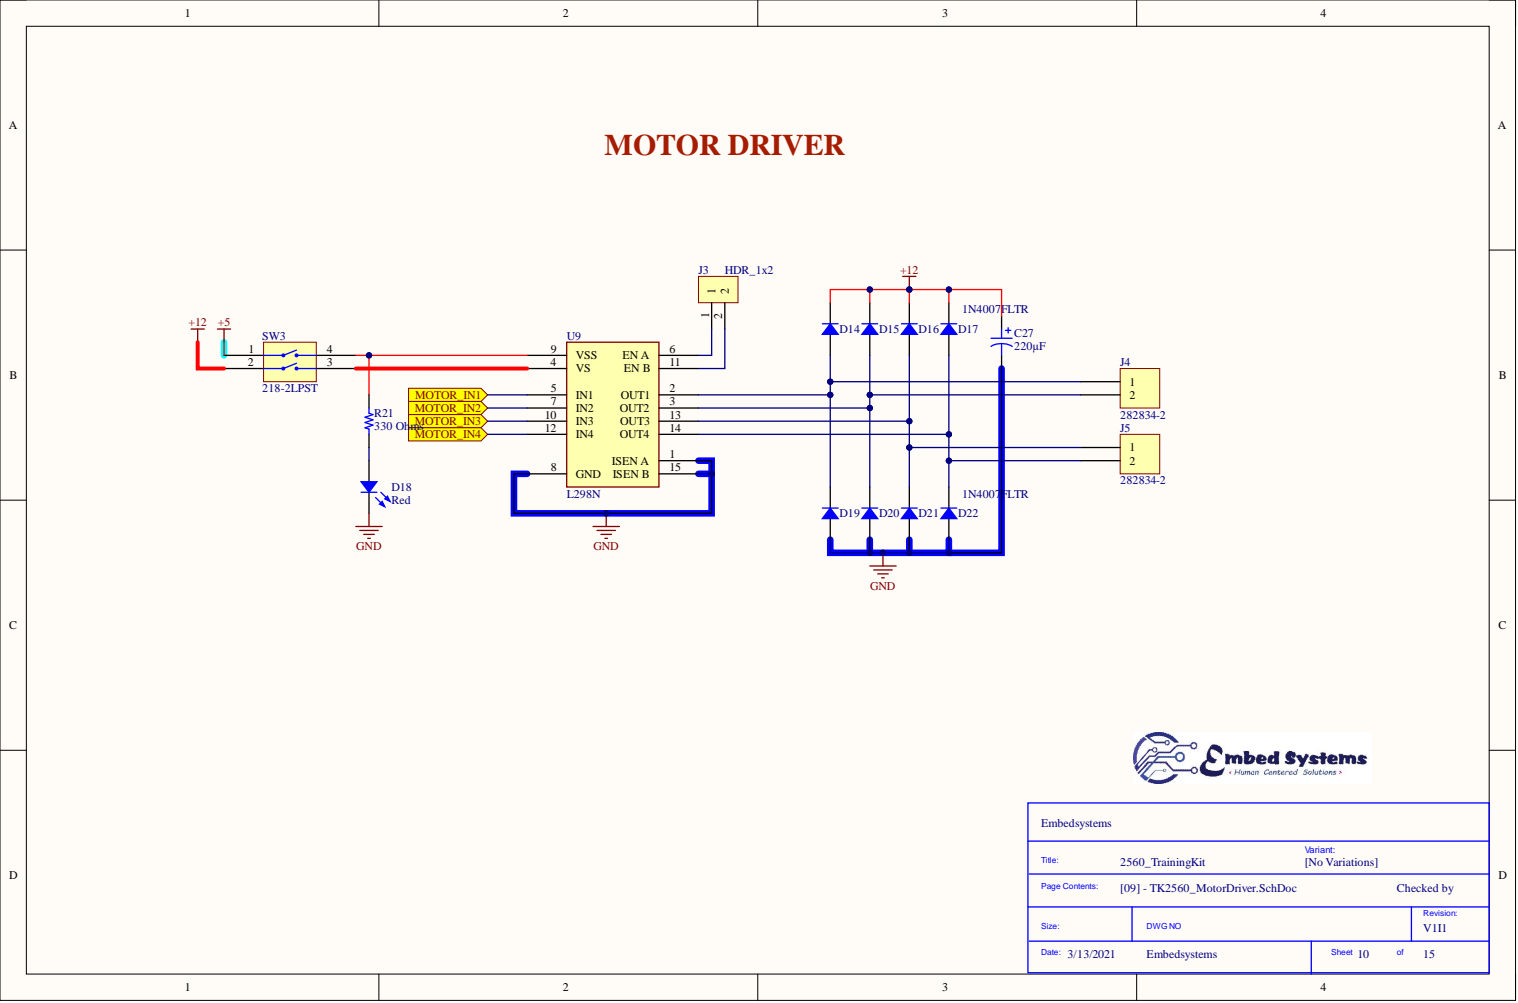
[picture p74: page 10]

1 3
1 4

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

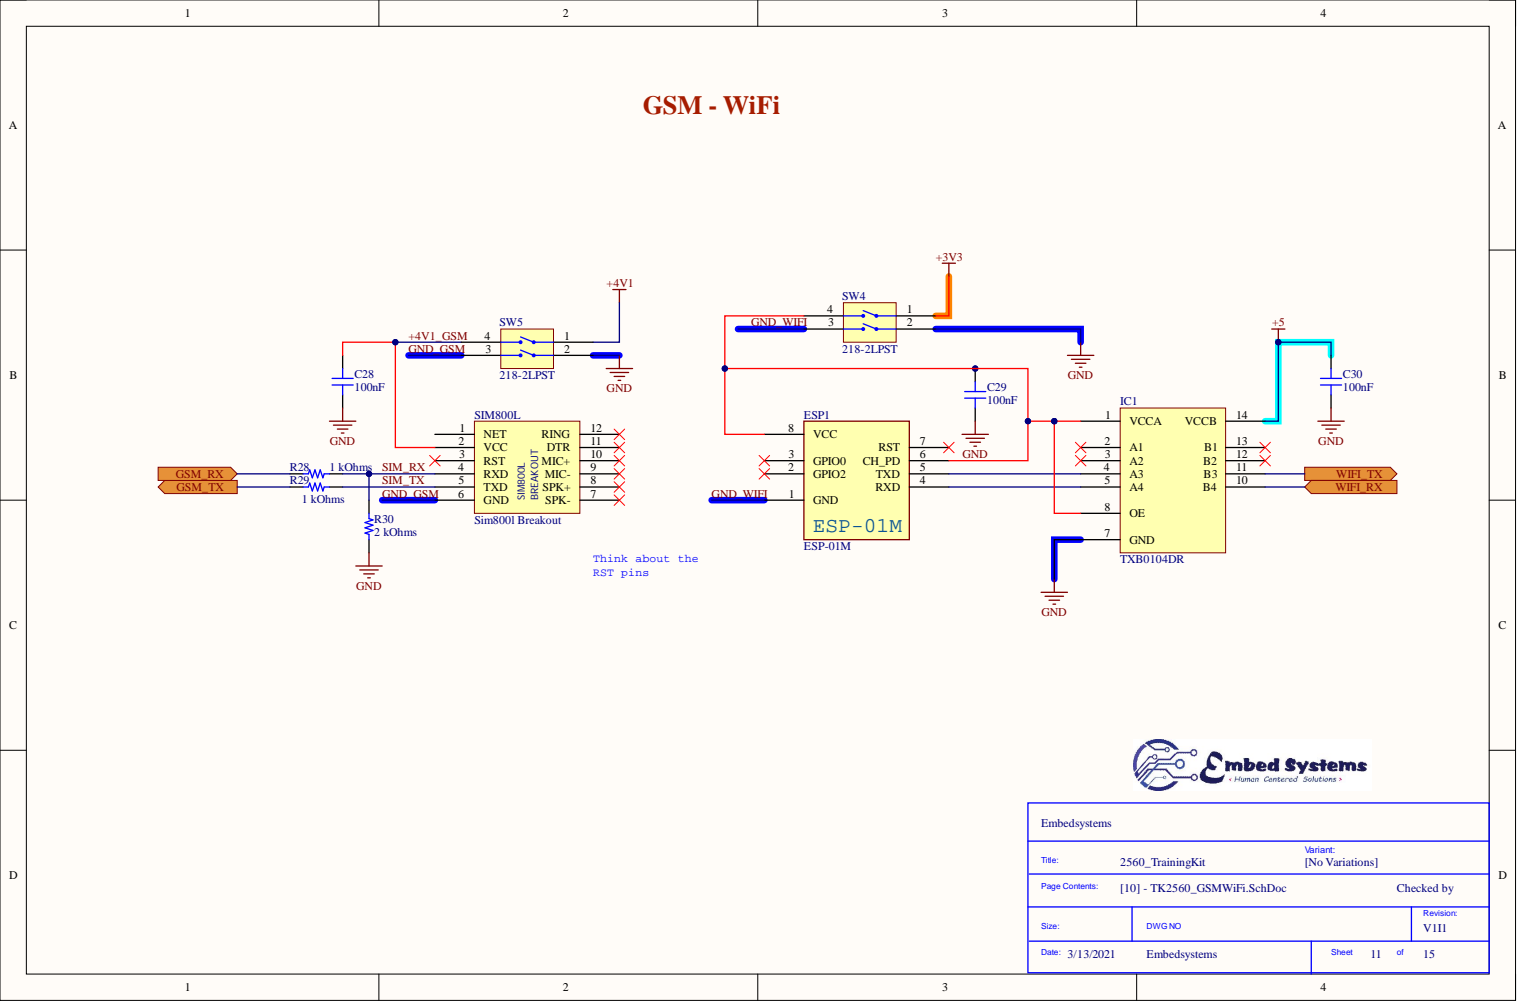
[picture p75: page 11]
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

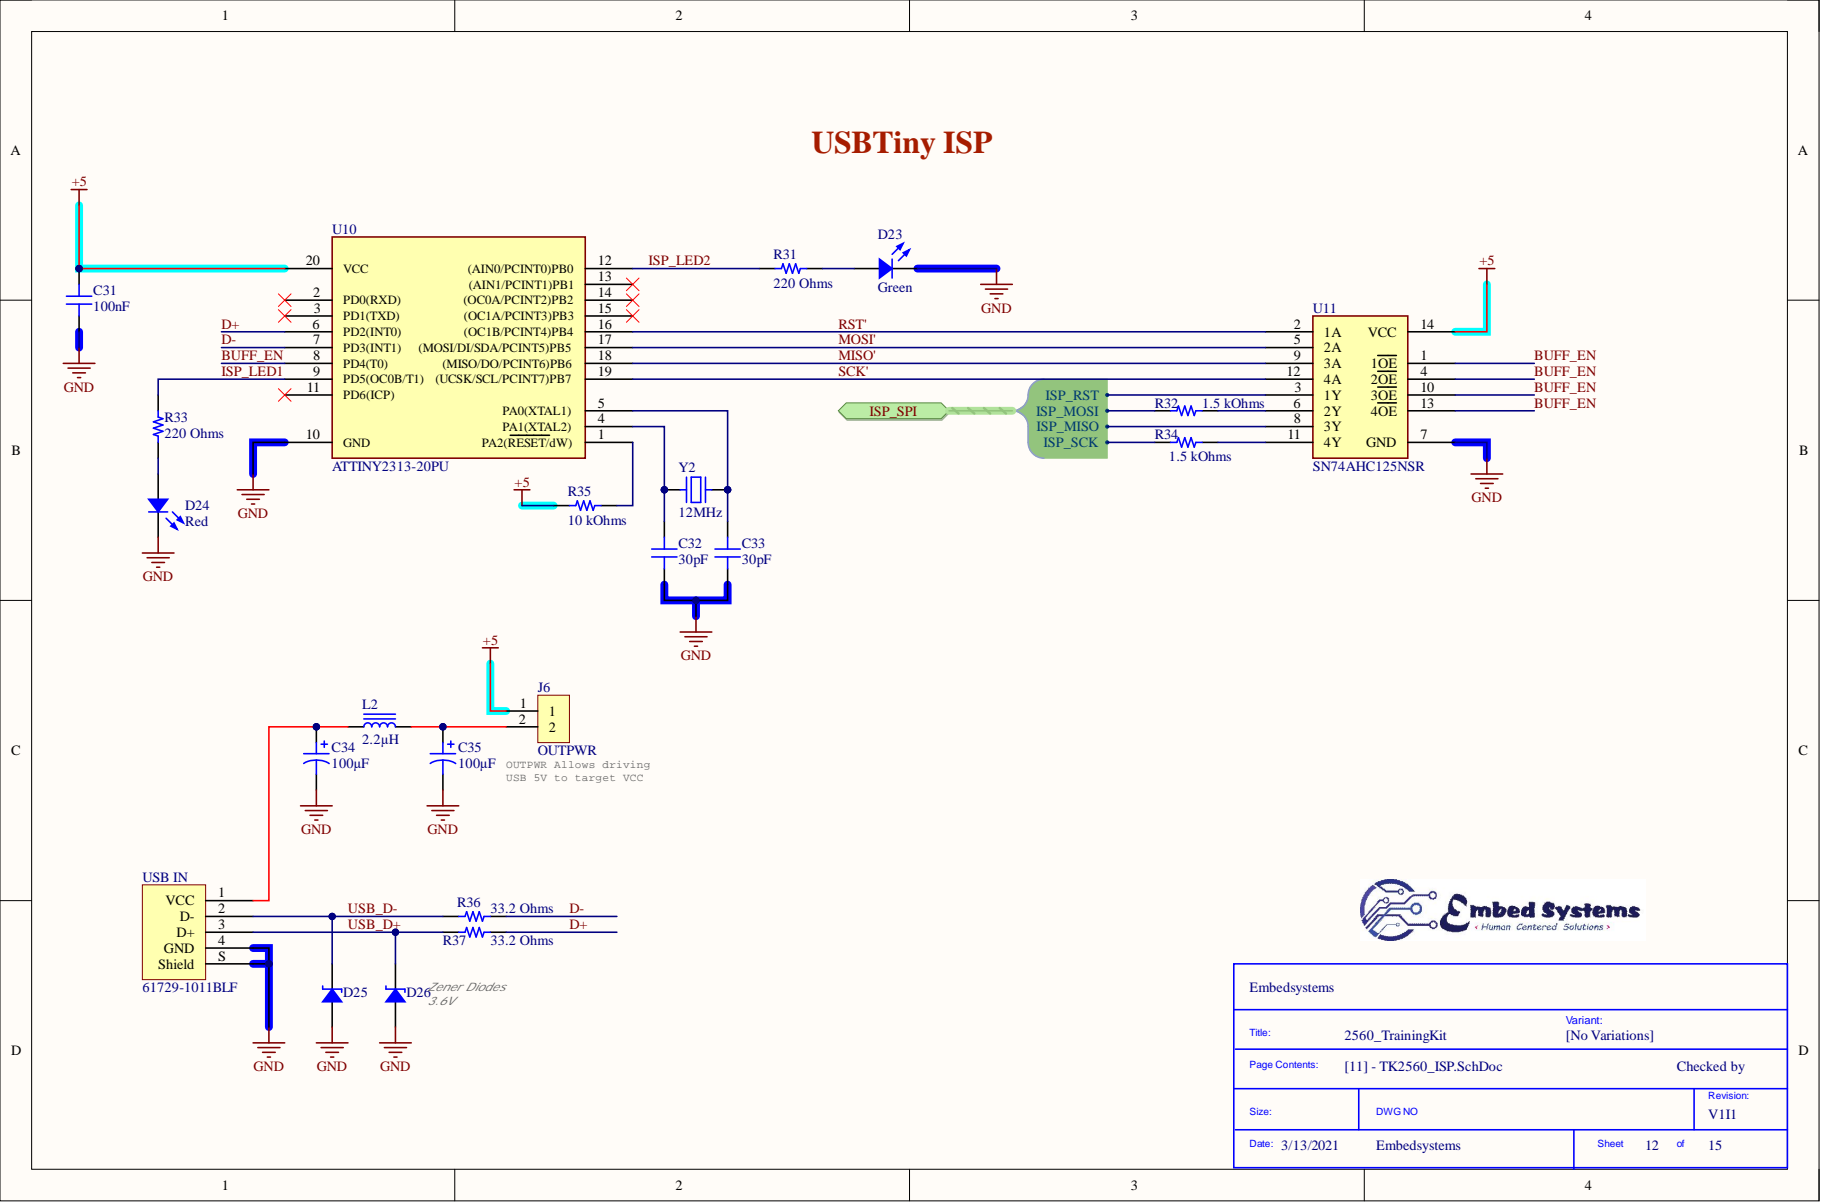
[picture p76: page 12]

OUTPWR Allows driving
USB 5V to target VCC

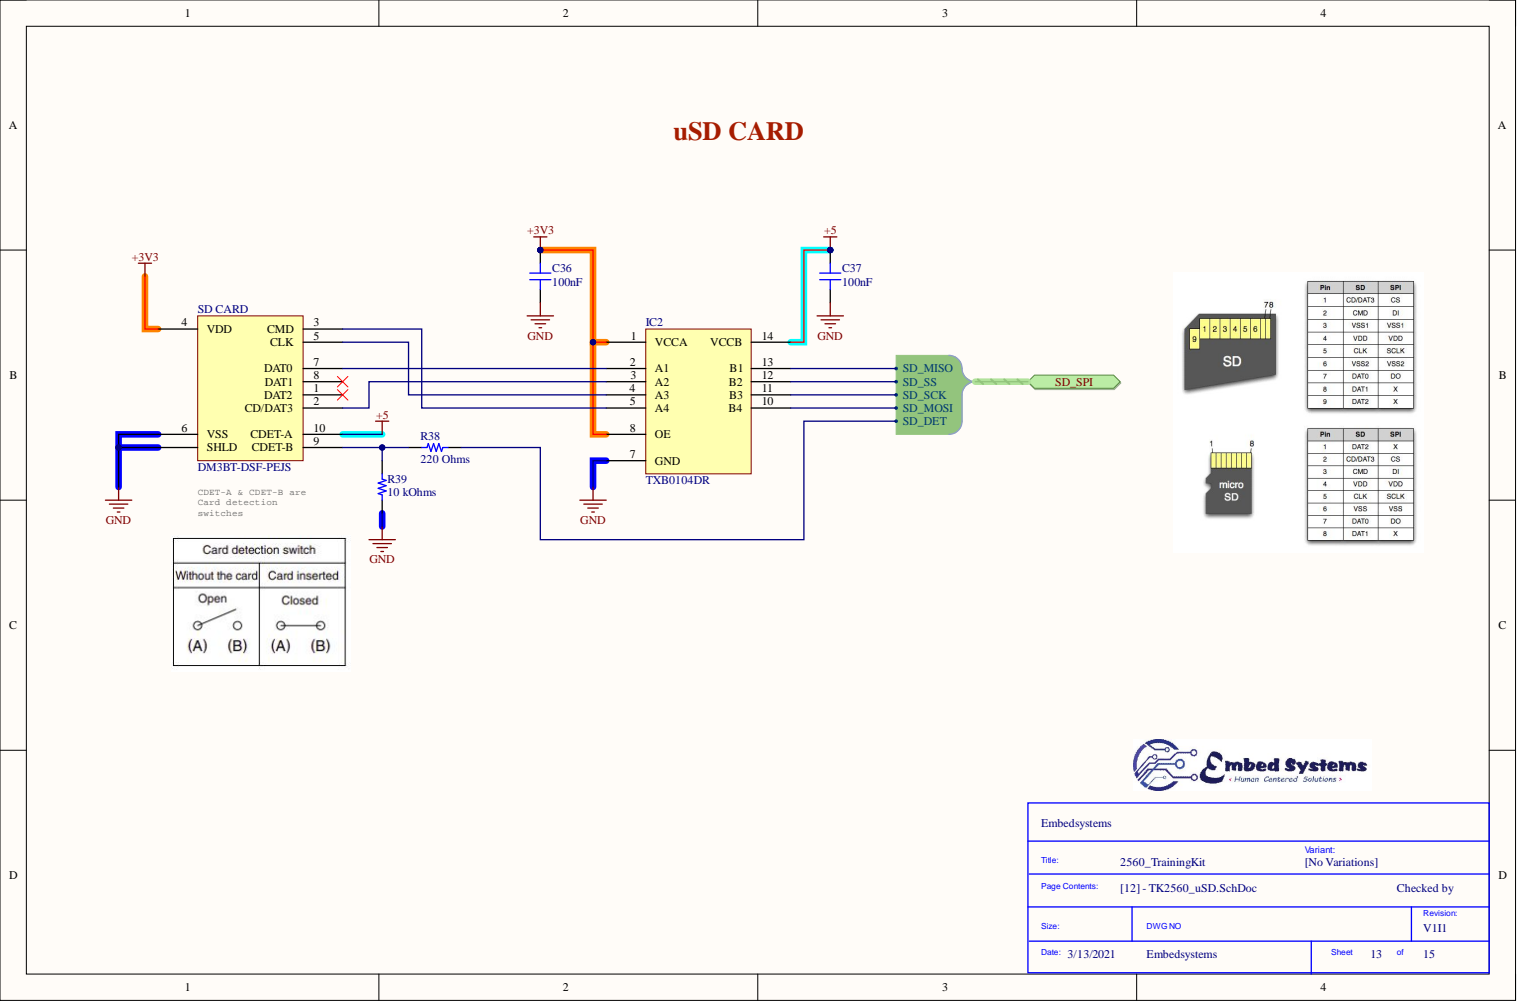
[picture p77: page 13]

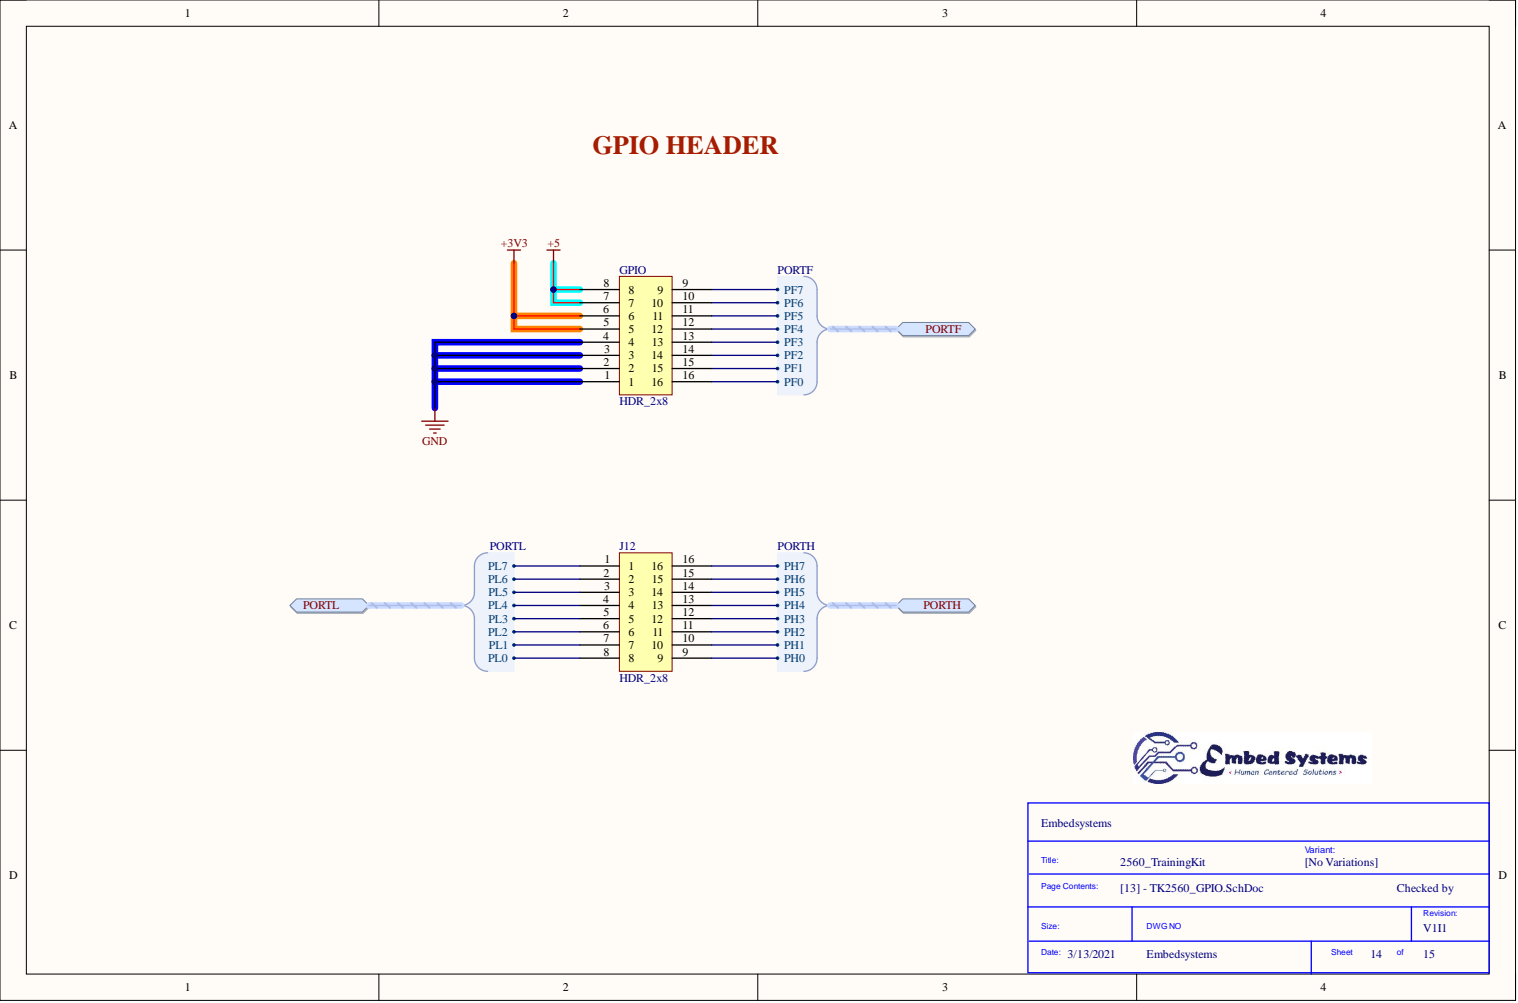
[picture p78: page 14]

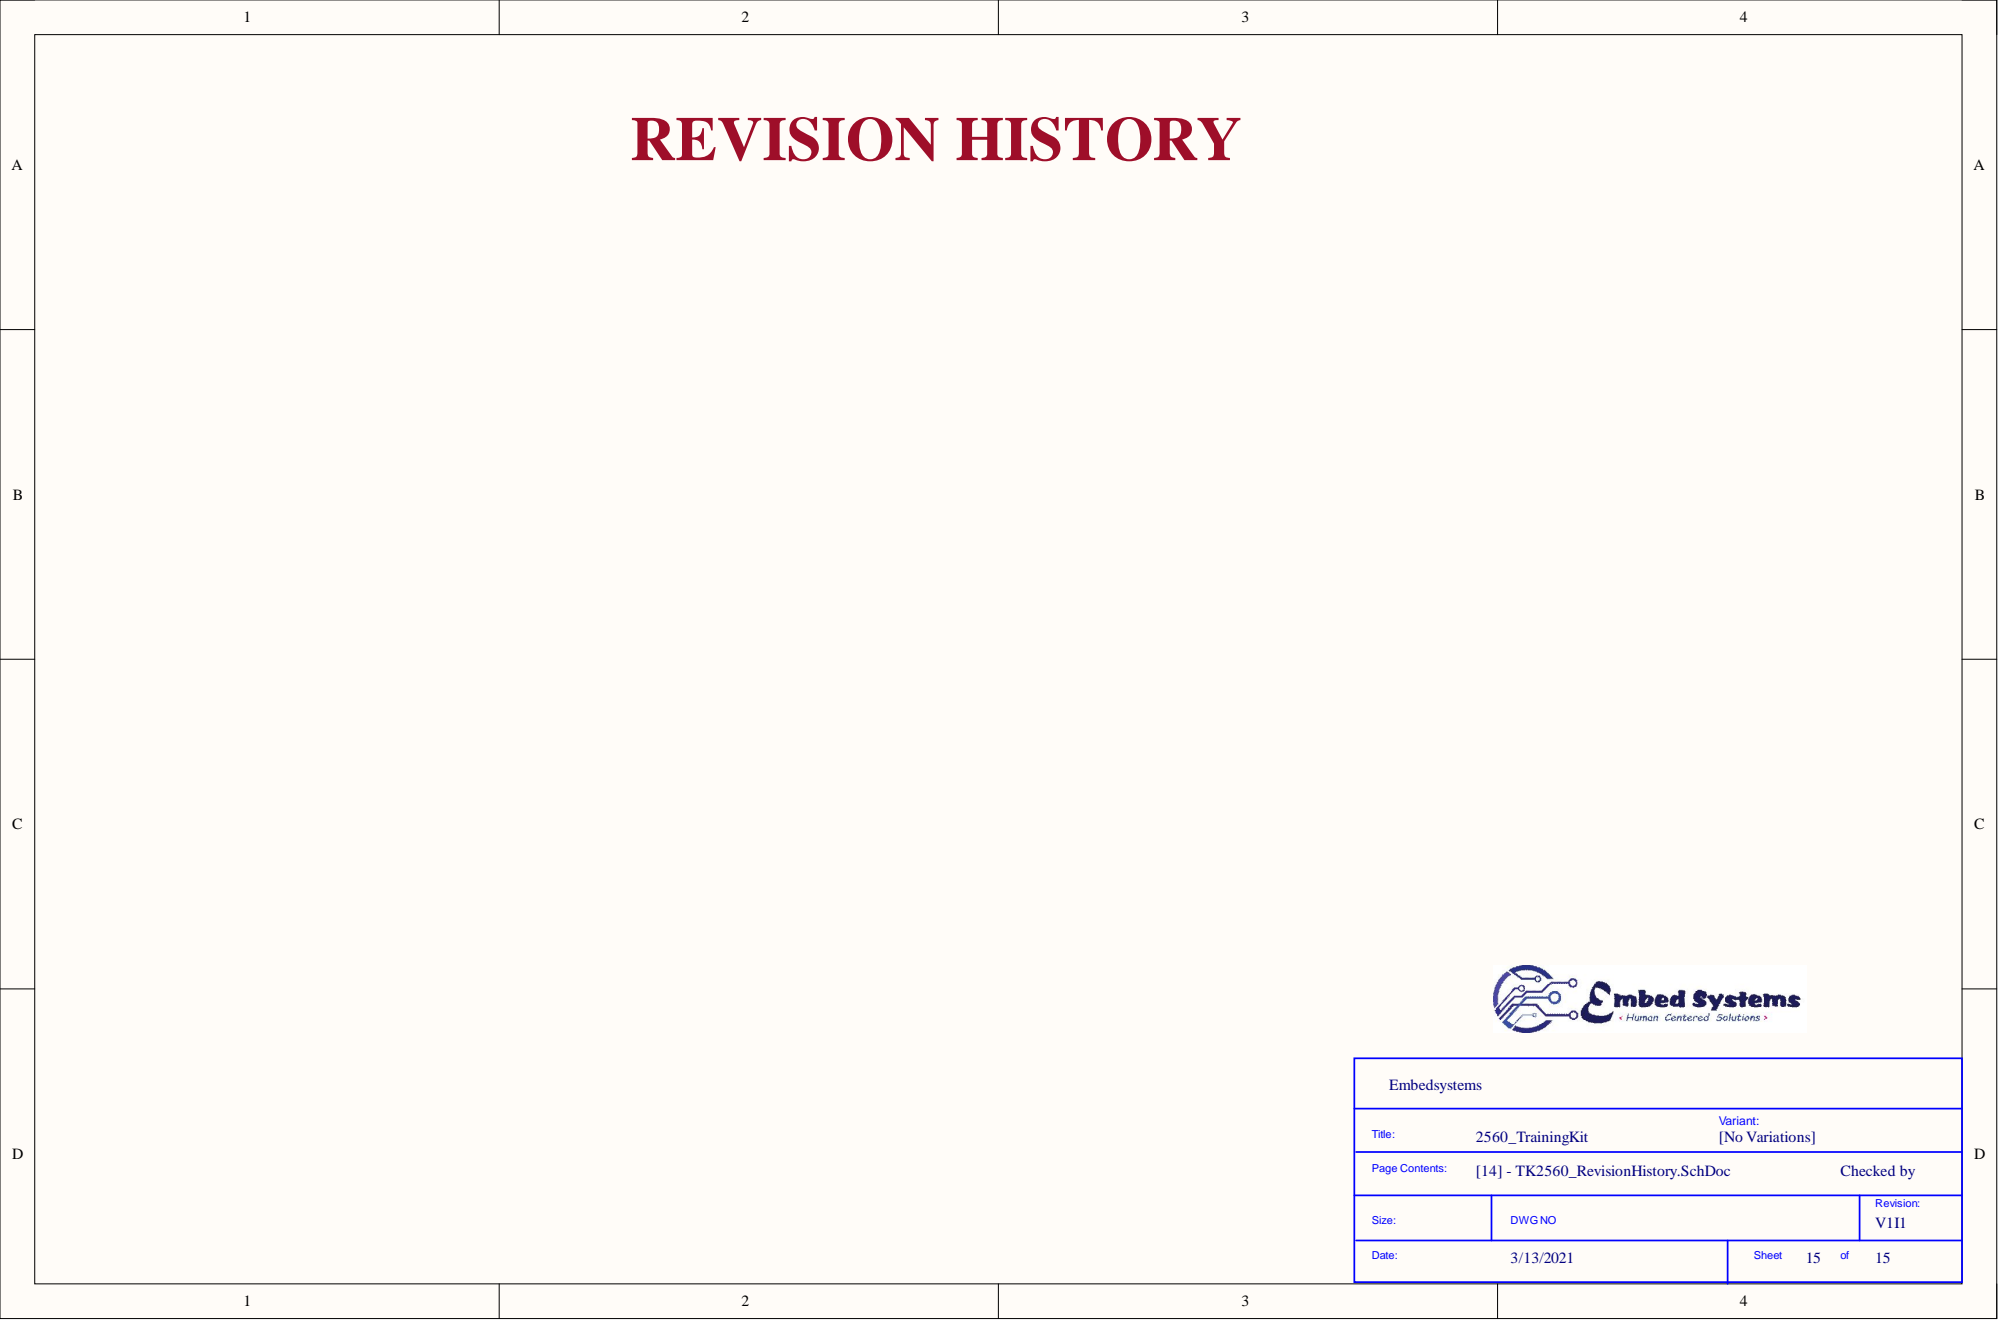
[picture p79: page 15]

Revision:
