mokweri/2560_TrainingKit/Release Files/2 - Board Assembly/TK2560_Assembly Drawing_V1I1.PDF

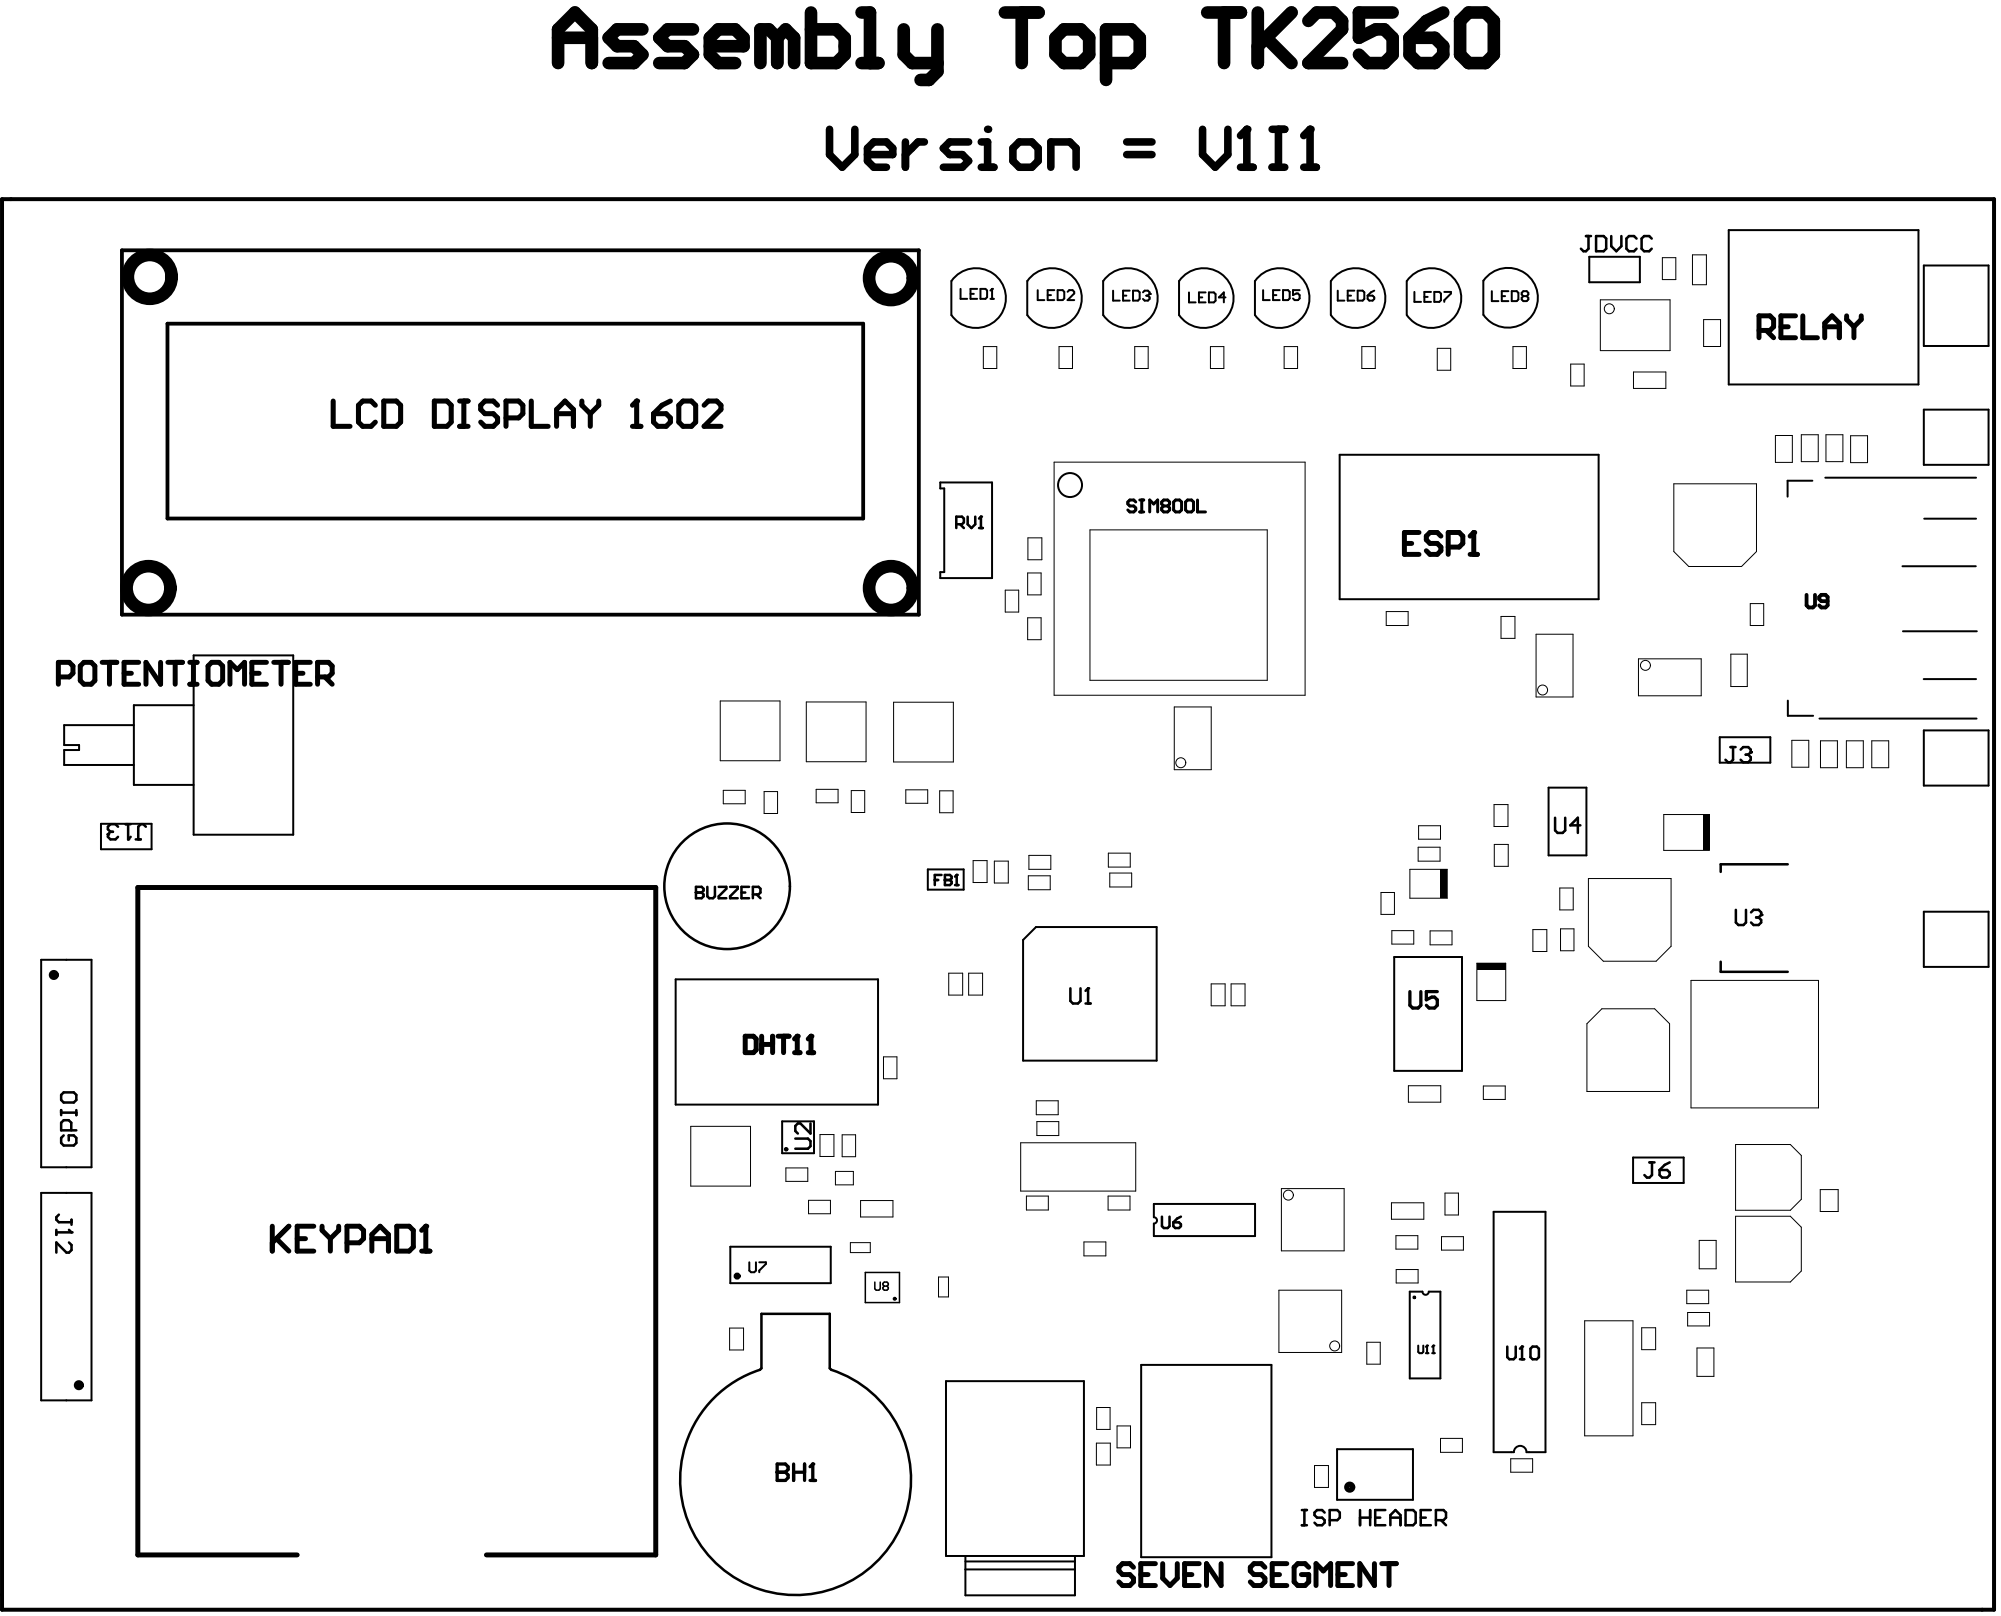
[picture p80: page 1]
