mokweri/2560_TrainingKit/Release Files/2 - Board Assembly/TK2560_Mechanical Drawing.PDF

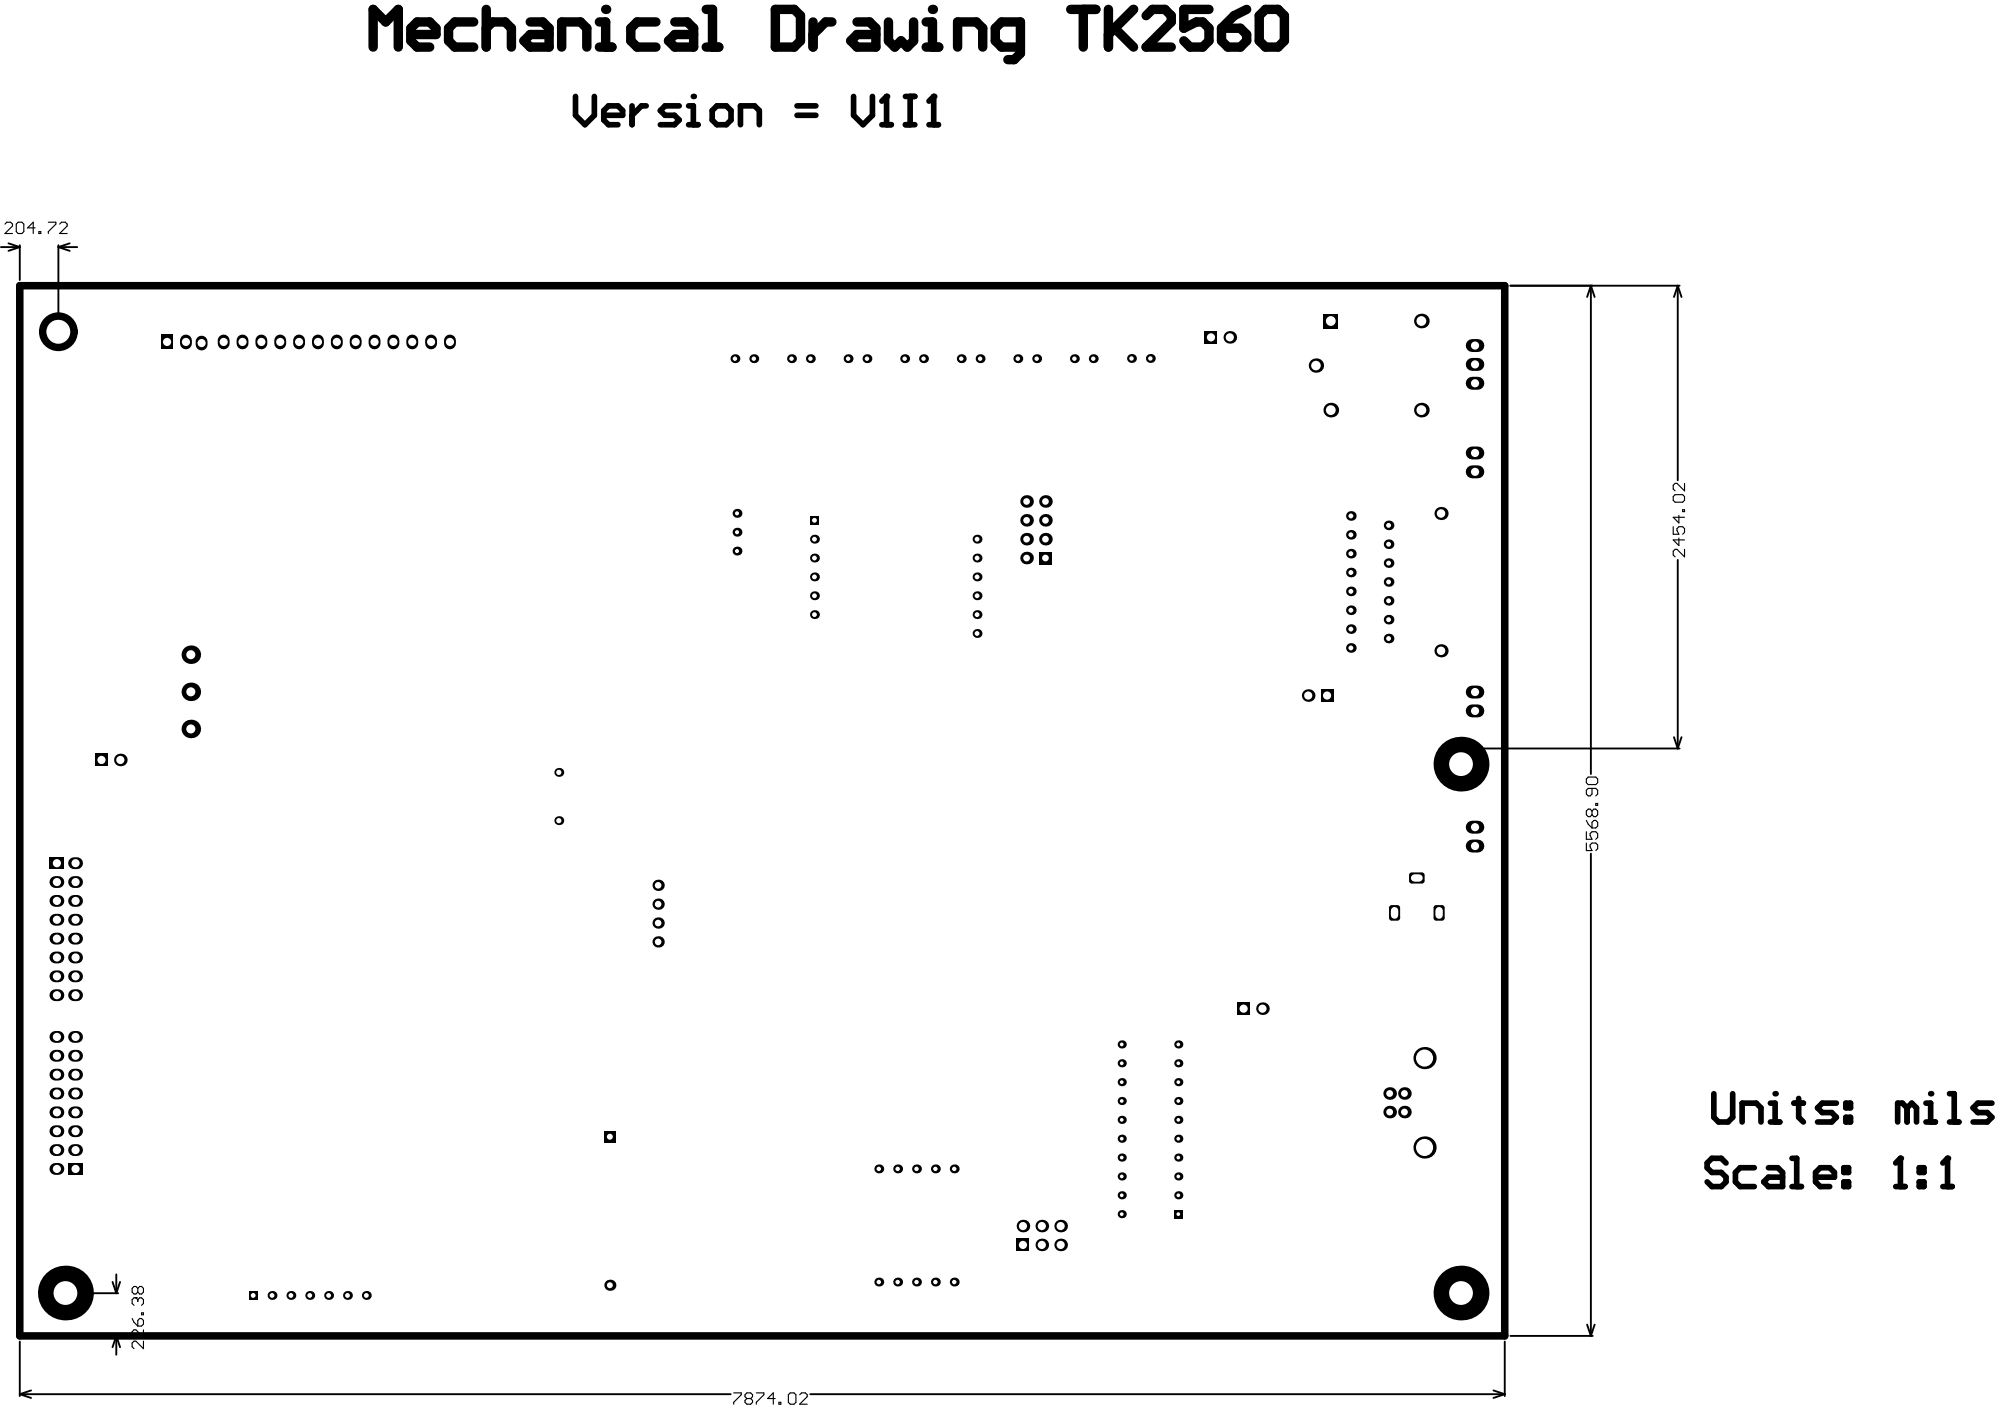
[picture p81: page 1]
