mokweri/2560_TrainingKit/Release Files/2 - Board Assembly/TK2560_Top View.PDF

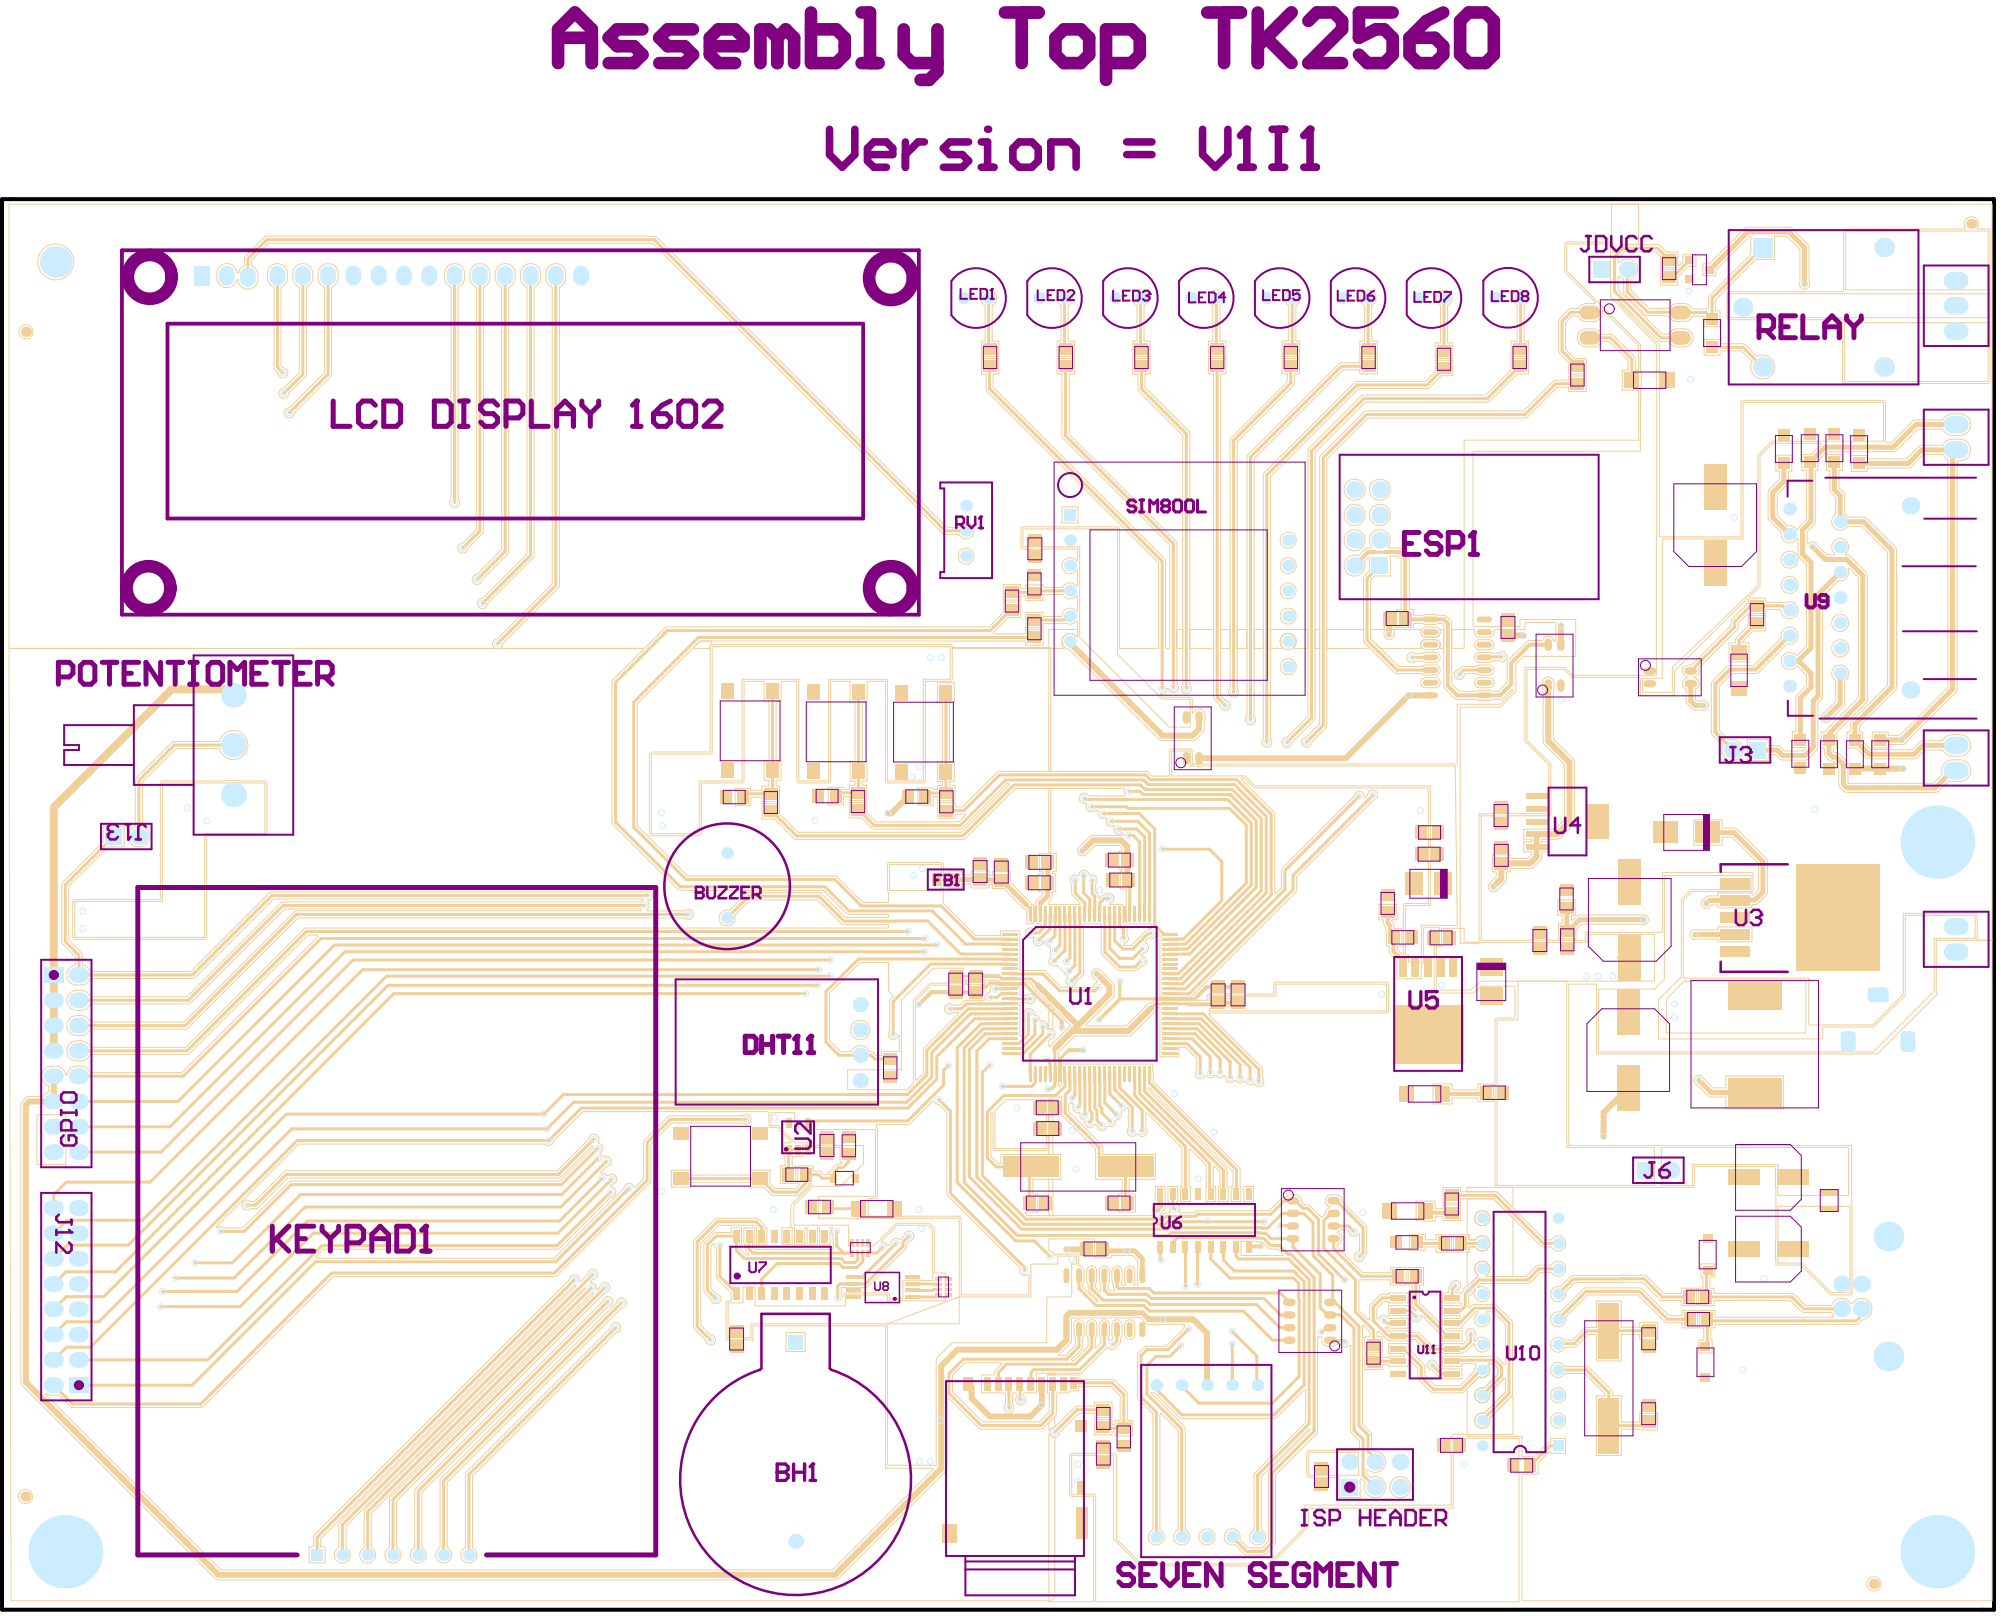
[picture p82: page 1]
