mokweri/2560_TrainingKit/Documentation/Schematic Samples/MCU_Kit_V0_Schematic.pdf

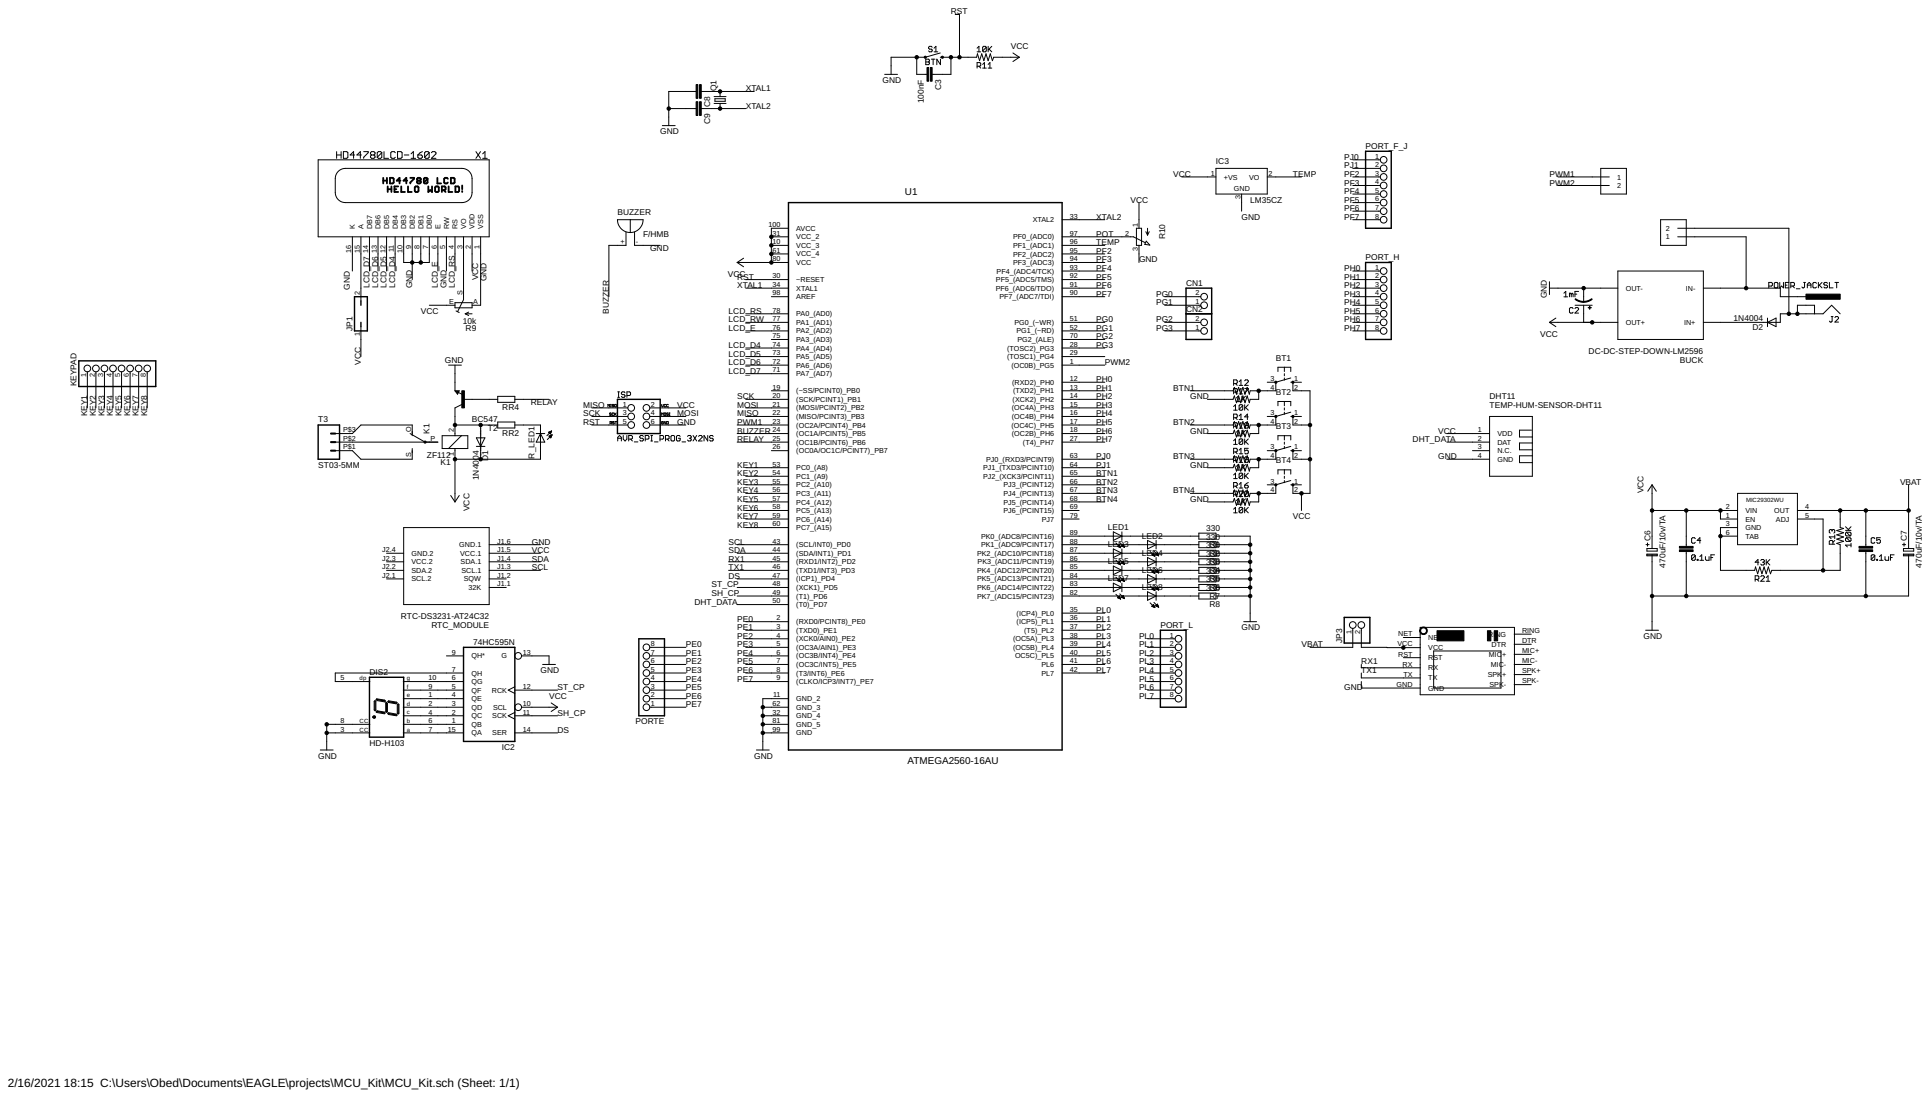
[picture p83: page 1]

DC-DC-STEP-DOWN-LM2596

2/16/2021 18:15 C:\Users\Obed\Documents\EAGLE\projects\MCU_Kit\MCU_Kit.sch (Sheet: 1/1)
