mokweri/2560_TrainingKit/Production/NC Drill Output/TK2560_Drill Drawing.PDF

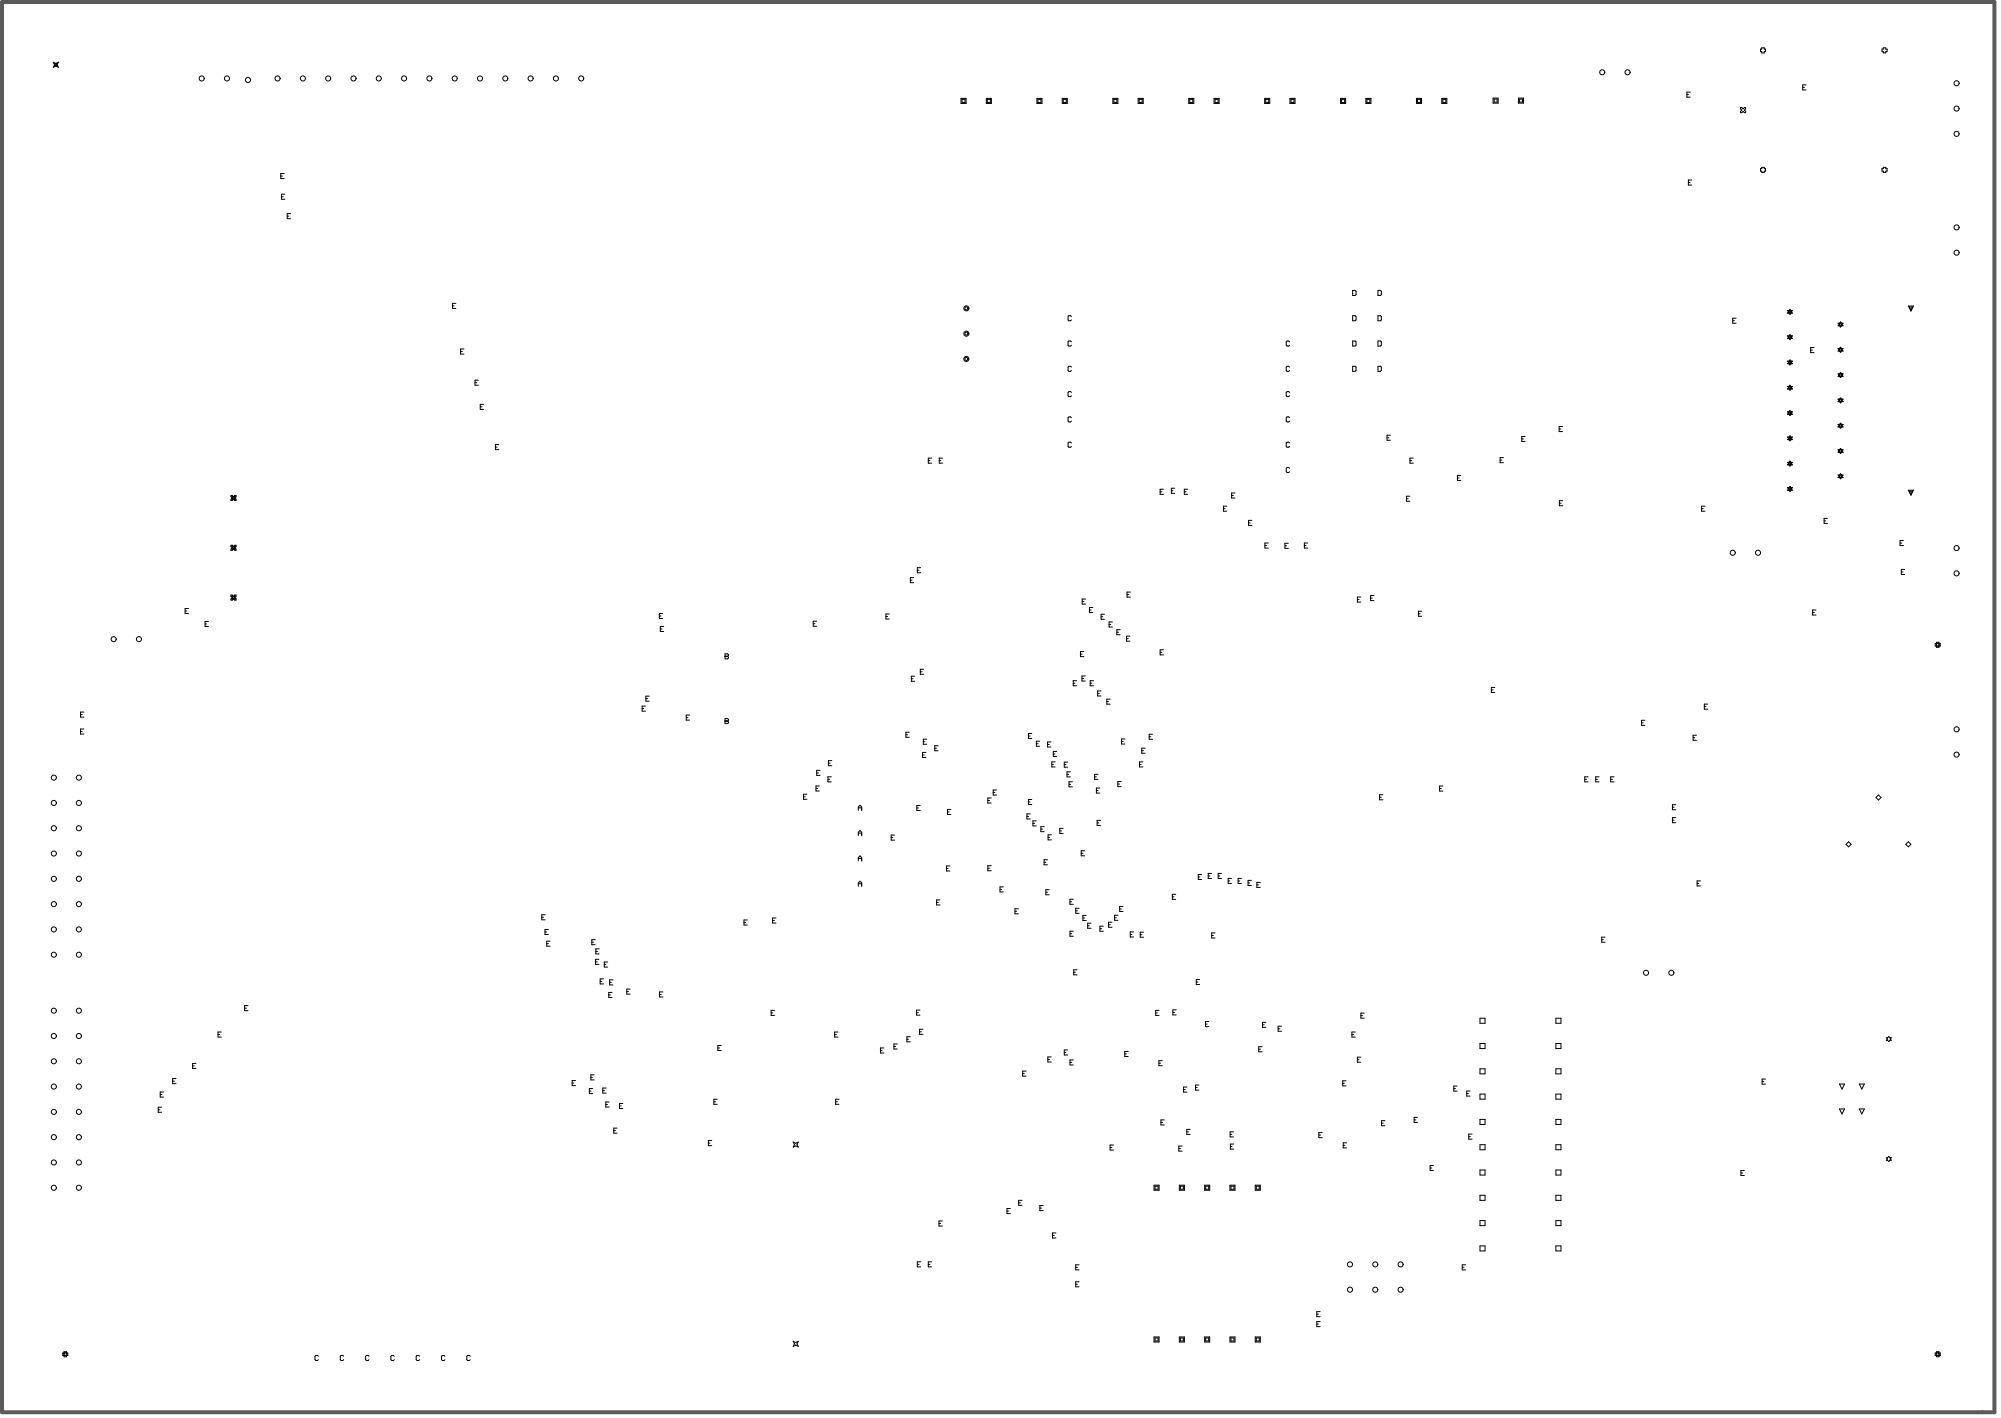
[picture p84: page 1]

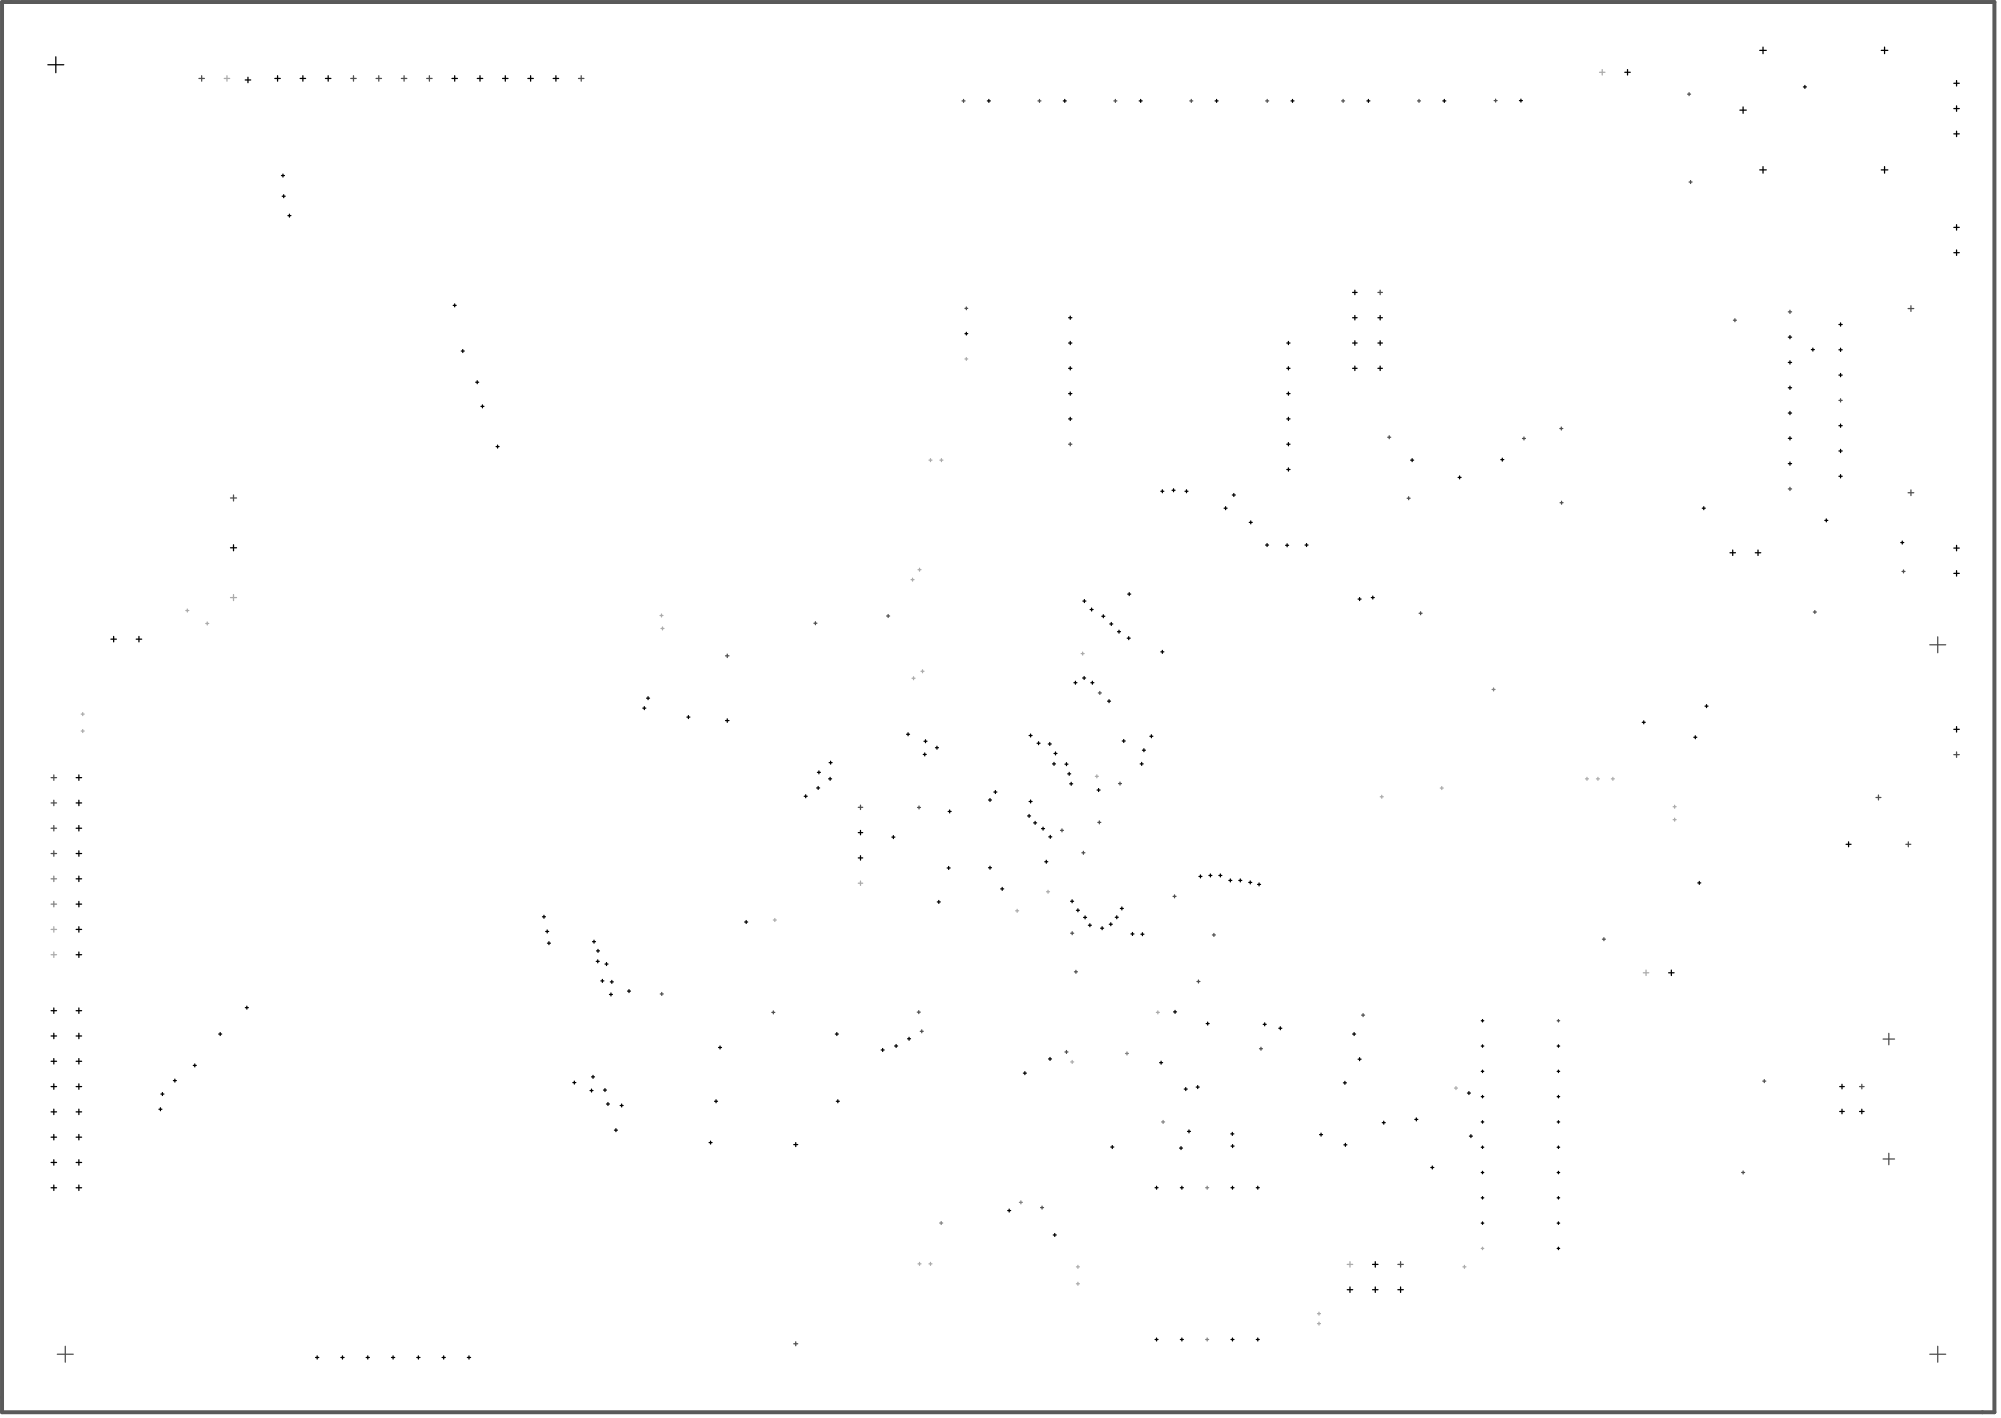
[picture p85: page 2]
