mokweri/2560_TrainingKit/(list of files, drawings)

Other design files:
DesignFiles/2560_TrainingKit/2560_TrainingKit.PrjPcb
DesignFiles/2560_TrainingKit/2560TK_PCBLib.PcbLib
DesignFiles/2560_TrainingKit/2560TK_SchematicLib.SchLib
DesignFiles/2560_TrainingKit/[00] - TK2560_MainBlock.SchDoc
DesignFiles/2560_TrainingKit/[01] - TK2560_CoverPage.SchDoc
DesignFiles/2560_TrainingKit/[02] - TK2560_BlockDiagram.SchDoc
DesignFiles/2560_TrainingKit/[03] - TK2560_MCU.SchDoc
DesignFiles/2560_TrainingKit/[04] - TK2560_Power.SchDoc
DesignFiles/2560_TrainingKit/[05] - TK2560_OutputLEDs.SchDoc
DesignFiles/2560_TrainingKit/[06] - TK2560_InputKeys.SchDoc
DesignFiles/2560_TrainingKit/[07] - TK2560_RTC.SchDoc
DesignFiles/2560_TrainingKit/[08] - TK2560_Relay.SchDoc
DesignFiles/2560_TrainingKit/[09] - TK2560_MotorDriver.SchDoc
DesignFiles/2560_TrainingKit/[10] - TK2560_GSMWiFi.SchDoc
DesignFiles/2560_TrainingKit/[11] - TK2560_ISP.SchDoc
DesignFiles/2560_TrainingKit/[12] - TK2560_uSD.SchDoc
DesignFiles/2560_TrainingKit/[13] - TK2560_GPIO.SchDoc
DesignFiles/2560_TrainingKit/PCBtest.PcbDoc
DesignFiles/2560_TrainingKit/TK2560_PCB.PcbDoc
Templates/Schematic/[01] - TK2560_CoverPage.SchDoc
Templates/Schematic/[14] - TK2560_RevisionHistory.SchDoc
