mokweri/2560_TrainingKit/Firmware/TK2560/TK2560/TK2560/drivers/pinChangeInterruptPins.h

/*
 * pinChangeInterruptPins.h
 *
 * Created: 18/08/2021 12:30:44
 *  Author: OBED
 */ 

#ifndef PINCHANGEINTERRUPTPINS_H_
#define PINCHANGEINTERRUPTPINS_H_

//================================================================================
// Board Definitions
//================================================================================
//For ATMega2560 Ports
#define PCINT_INPUT_PORT0	PINB //0-7//8 is on PE0
#define PCINT_INPUT_PORT1	((PINE & 0x01) | (PINJ << 1)) //PINJ //9-15
#define PCINT_INPUT_PORT2	PINK //16-23

#define PCINT_ENABLE_PORT0
#define PCINT_ENABLE_PORT1
#define PCINT_ENABLE_PORT2

#define PCINT_ENABLE_PCINT0
#define PCINT_ENABLE_PCINT1
#define PCINT_ENABLE_PCINT2
#define PCINT_ENABLE_PCINT3
#define PCINT_ENABLE_PCINT4
#define PCINT_ENABLE_PCINT5
#define PCINT_ENABLE_PCINT6
#define PCINT_ENABLE_PCINT7
#define PCINT_ENABLE_PCINT8
#define PCINT_ENABLE_PCINT9
#define PCINT_ENABLE_PCINT10
#define PCINT_ENABLE_PCINT11
#define PCINT_ENABLE_PCINT12
#define PCINT_ENABLE_PCINT13
#define PCINT_ENABLE_PCINT14
#define PCINT_ENABLE_PCINT15
#define PCINT_ENABLE_PCINT16
#define PCINT_ENABLE_PCINT17
#define PCINT_ENABLE_PCINT18
#define PCINT_ENABLE_PCINT19
#define PCINT_ENABLE_PCINT20
#define PCINT_ENABLE_PCINT21
#define PCINT_ENABLE_PCINT22
#define PCINT_ENABLE_PCINT23
#define PCINT_ENABLE_PCINT24
#define PCINT_ENABLE_PCINT25
#define PCINT_ENABLE_PCINT26
#define PCINT_ENABLE_PCINT27
#define PCINT_ENABLE_PCINT28
#define PCINT_ENABLE_PCINT29
#define PCINT_ENABLE_PCINT30
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
#define PCINT_USE_PCINT19 true
#else
#define PCINT_USE_PCINT19 false
#endif
#if (PCINT_HAS_PCINT20 == true) && defined(PCINT_ENABLE_PCINT20)
#define PCINT_USE_PCINT20 true
#else
#define PCINT_USE_PCINT20 false
#endif
#if (PCINT_HAS_PCINT21 == true) && defined(PCINT_ENABLE_PCINT21)
#define PCINT_USE_PCINT21 true
#else
#define PCINT_USE_PCINT21 false
#endif
#if (PCINT_HAS_PCINT22 == true) && defined(PCINT_ENABLE_PCINT22)
#define PCINT_USE_PCINT22 true
#else
#define PCINT_USE_PCINT22 false
#endif
#if (PCINT_HAS_PCINT23 == true) && defined(PCINT_ENABLE_PCINT23)
#define PCINT_USE_PCINT23 true
#else
#define PCINT_USE_PCINT23 false
#endif


//================================================================================
// Number Used Pins
//================================================================================
#define PCINT_NUM_USED_PINS_PORT0 ( \
PCINT_USE_PCINT0 + \
PCINT_USE_PCINT1 + \
PCINT_USE_PCINT2 + \
PCINT_USE_PCINT3 + \
PCINT_USE_PCINT4 + \
PCINT_USE_PCINT5 + \
PCINT_USE_PCINT6 + \
PCINT_USE_PCINT7)

#define PCINT_NUM_USED_PINS_PORT1 ( \
PCINT_USE_PCINT8 + \
PCINT_USE_PCINT9 + \
PCINT_USE_PCINT10 + \
PCINT_USE_PCINT11 + \
PCINT_USE_PCINT12 + \
PCINT_USE_PCINT13 + \
PCINT_USE_PCINT14 + \
PCINT_USE_PCINT15)

#define PCINT_NUM_USED_PINS_PORT2 ( \
PCINT_USE_PCINT16 + \
PCINT_USE_PCINT17 + \
PCINT_USE_PCINT18 + \
PCINT_USE_PCINT19 + \
PCINT_USE_PCINT20 + \
PCINT_USE_PCINT21 + \
PCINT_USE_PCINT22 + \
PCINT_USE_PCINT23)

// number of used hardware pins
#define EXTERNAL_NUM_USED_PINCHANGEINTERRUPT ( \
PCINT_NUM_USED_PINS_PORT0 + \
PCINT_NUM_USED_PINS_PORT1 + \
PCINT_NUM_USED_PINS_PORT2)

//================================================================================
// Used Ports
//================================================================================
// check if ports are used
#if PCINT_NUM_USED_PINS_PORT0
#define PCINT_USE_PORT0 true
#else
#define PCINT_USE_PORT0 false
#endif
#if PCINT_NUM_USED_PINS_PORT1
#define PCINT_USE_PORT1 true
#else
#define PCINT_USE_PORT1 false
#endif
#if PCINT_NUM_USED_PINS_PORT2
#define PCINT_USE_PORT2 true
#else
#define PCINT_USE_PORT2 false
#endif


// number of used ports
#define PCINT_NUM_USED_PORTS ( \
PCINT_USE_PORT0 + \
PCINT_USE_PORT1 + \
PCINT_USE_PORT2)

// add fakes if ports are not used
#ifndef PCINT_INPUT_PORT0
#define PCINT_INPUT_PORT0 0
#else
#define PCINT_INPUT_PORT0_USED
#endif
#ifndef PCINT_INPUT_PORT1
#define PCINT_INPUT_PORT1 0
#else
#define PCINT_INPUT_PORT1_USED
#endif
#ifndef PCINT_INPUT_PORT2
#define PCINT_INPUT_PORT2 0
#else
#define PCINT_INPUT_PORT2_USED
#endif


#endif /* PINCHANGEINTERRUPTPINS_H_ */
