mokweri/2560_TrainingKit/Firmware/MCU Training Kit V1.0/DHT11.h

/*
 * DHT11.h
 *
 * Created: 7/16/2019 8:19:48 PM
 *  Author: OBED
 */ 


#ifndef DHT11_H_
#define DHT11_H_

#define DHT_PORT_OUT PORTE
#define DHT_PORT_IN PINE
#define DHT_PIN PE4


#define SET_BIT(byte, bit) ((byte) |= (1UL << (bit)))
#define CLEAR_BIT(byte,bit) ((byte) &= ~(1UL << (bit)))
#define IS_SET(byte,bit) (((byte) & (1UL << (bit))) >> (bit))

#include <stdint.h>

void DHT11_Init (void)
{
    /* According to the DHT11's datasheet, the sensor needs about
       1-2 seconds to get ready when first getting power, so we wait
     */
    _delay_ms(2000);
}


uint8_t fetchData(uint8_t* arr)
{
    uint8_t data [5];
    uint8_t cnt, check;
    int8_t i,j;
    
    /******************* Sensor communication start *******************/
    
    /* Set data pin as output first */
    SET_BIT(DDRB,DHT_PIN);
    
    /* First we need milliseconds delay, so set clk/1024 prescaler */
    TCCR0B = 0x05;
    
    TCNT0 = 0;
    
    /* Clear bit for 20 ms */
    CLEAR_BIT(DHT_PORT_OUT,DHT_PIN);
    
    /* Wait about 20 ms */
    while(TCNT0 < 160);
    
    /* Now set Timer0 with clk/8 prescaling.
     Gives 1µs per cycle @8Mhz */
    TCCR0B = 0x02;
    
    TCNT0 = 0;
    
    /* Pull high again */
    SET_BIT(DHT_PORT_OUT,DHT_PIN);
    
    /* And set data pin as input */
    CLEAR_BIT(DDRB,DHT_PIN);
    
    /* Wait for response from sensor, 20-40µs according to datasheet */
    while(IS_SET(DHT_PORT_IN,DHT_PIN))
    { if (TCNT0 >= 60) return 0; }
    
    /************************* Sensor preamble *************************/
    
    TCNT0 = 0;
    
    /* Now wait for the first response to finish, low ~80µs */
    while(!IS_SET(DHT_PORT_IN,DHT_PIN))
    { if (TCNT0 >= 100) return 0; }
    
    TCNT0 = 0;
    
    /* Then wait for the second response to finish, high ~80µs */
    while(IS_SET(DHT_PORT_IN,DHT_PIN))
    { if (TCNT0 >= 100) return 0; }
    
    /********************* Data transmission start **********************/
    
    for (i = 0; i < 5; ++i)
    {
        for(j = 7; j >= 0; --j)
        {
            TCNT0 = 0;
            
            /* First there is always a 50µs low period */
            while(!IS_SET(DHT_PORT_IN,DHT_PIN))
            { if (TCNT0 >= 70) return 0; }
            
            TCNT0 = 0;
            
            /* Then the data signal is sent. 26 to 28µs (ideally)
             indicate a low bit, and around 70µs a high bit */
            while(IS_SET(DHT_PORT_IN,DHT_PIN))
            { if (TCNT0 >= 90) return 0; }
            
            /* Store the value now so that the whole checking doesn't
             move the TCNT0 forward by too much to make the data look
             bad */
            cnt = TCNT0;
            
            if (cnt >= 20 && cnt <= 35)
            { CLEAR_BIT(data[i],j); }
            
            else if (cnt >= 60 && cnt <= 80)
            { SET_BIT(data[i],j); }
            
            else return 0;
        }
    }
    
    /********************* Sensor communication end *********************/
    
    check = (data[0] + data[1] + data[2] + data[3]) & 0xFF;
    
    if (check != data[4]) return 0;
    
    for(i = 0; i < 4; ++i)
    { arr[i] = data[i]; }
    
    return 1;
}

#endif /* DHT11_H_ */
