mokweri/2560_TrainingKit/Firmware/MCU Training Kit V1.0/dht.h

/*
 * dht.h
 *
 * Created: 7/16/2019 9:43:26 PM
 *  Author: OBED
 */ 


#ifndef DHT_H_
#define DHT_H_

#include <stdlib.h>
#include <avr/io.h>
#include <util/delay.h>

//setup parameters
#define DHT11_DDR DDRE
#define DHT11_PORT PORTE
#define DHT11_PIN PINE
#define DHT11_INPUTPIN PE4

#define DHT11_DATA_TEMPERATURE 0
#define DHT11_DATA_HUMIDITY 1
#define DHT11_ERROR 150

uint8_t DHT11_GetData(uint8_t select);


uint8_t DHT11_GetData(uint8_t select) {
	uint8_t bits[5];
	uint8_t i, j = 0;

	//reset port
	DHT11_DDR |= (1 << DHT11_INPUTPIN); //output
	DHT11_PORT |= (1 << DHT11_INPUTPIN); //high
	_delay_ms(100);

	//send request
	DHT11_PORT &= ~(1 << DHT11_INPUTPIN); //low
	_delay_ms(18);
	DHT11_PORT |= (1 << DHT11_INPUTPIN); //high
	_delay_us(1);
	DHT11_DDR &= ~(1 << DHT11_INPUTPIN); //input
	_delay_us(39);

	//check start condition 1
	if ((DHT11_PIN & (1 << DHT11_INPUTPIN))) {
		return DHT11_ERROR;
	}
	_delay_us(80);
	//check start condition 2
	if (!(DHT11_PIN & (1 << DHT11_INPUTPIN))) {
		return DHT11_ERROR;
	}
	_delay_us(80);

	//read the data
	for (j = 0; j < 5; j++) { //read 5 byte
		uint8_t result = 0;
		for (i = 0; i < 8; i++) { //read every bit
			while (!(DHT11_PIN & (1 << DHT11_INPUTPIN)))
			; //wait for an high input
			_delay_us(30);
			if (DHT11_PIN & (1 << DHT11_INPUTPIN)) //if input is high after 30 us, get result
			result |= (1 << (7 - i));
			while (DHT11_PIN & (1 << DHT11_INPUTPIN))
			; //wait until input get low
		}
		bits[j] = result;
	}

	//reset port
	DHT11_DDR |= (1 << DHT11_INPUTPIN); //output
	DHT11_PORT |= (1 << DHT11_INPUTPIN); //low
	_delay_ms(100);

	//check checksum
	if (bits[0] + bits[1] + bits[2] + bits[3] == bits[4]) {
		if (select == DHT11_DATA_TEMPERATURE) { //return temperature
			return (bits[2]);
			} else if (select == DHT11_DATA_HUMIDITY) { //return humidity
			return (bits[0]);
		}
	}

	return DHT11_ERROR;
}

#endif /* DHT_H_ */
