mokweri/2560_TrainingKit/(commit log)

2021-01-12 Added Altium Project
    [2560TK_PCBLib.PcbLib, 2560TK_Schematic.SchDoc, 2560TK_SchematicLib.SchLib, 2560_TrainingKit.PrjPcb]
2021-01-12 created 2560 schematic library
    [2560TK_Schematic.SchDoc, 2560TK_SchematicLib.SchLib, 2560_TrainingKit.PrjPcb]
2021-01-12 added 100tqfp 3d model
    [2560TK_PCBLib.PcbLib, 2560TK_Schematic.SchDoc, 2560TK_SchematicLib.SchLib, TQFP100_Grid_0_5.STEP]
2021-01-13 added 3d models
    [ESP8266 ESP-01.step, King Bright SA05-11.step, Potentiometer.step]
2021-01-13 added lcd library
    [2560TK_PCBLib.PcbLib, 2560TK_SchematicLib.SchLib]
2021-01-14 created pot library
    [2560TK_PCBLib.PcbLib, 2560TK_SchematicLib.SchLib, PotentiometerB10K.step, Relay - SRD-03VDC-SL-C.stp]
2021-01-18 added esp-01 to library
    [2560TK_PCBLib.PcbLib, 2560TK_SchematicLib.SchLib]
2021-01-20 created more libraries
    [2560TK_PCBLib.PcbLib, 2560TK_SchematicLib.SchLib, User Library-DHT11-right.step, buzzer.STEP]
2021-01-21 added more libraries
    [2560TK_PCBLib.PcbLib, 2560TK_SchematicLib.SchLib, D²PAK TO-263-5.step, User Library-20mm_coin_holder.step, User Library-CR 2032 Lithium Cell.step]
2021-01-26 added l298n lib
    [2560TK_SchematicLib.SchLib, 2560_TrainingKit.PrjPcb]
2021-02-01 new libraries
    [2560TK_SchematicLib.SchLib, DIP20.STEP, Keypad3x4.step, User Library-DIP-20P-M01.step]
2021-02-16 update on libraries
    [2560TK_Schematic.SchDoc, 2560TK_SchematicLib.SchLib, 2560_TrainingKit.PrjPcb, PCB_test.PcbDoc, [01] - COVER PAGE.SchDoc, [02] - BLOCK DIAGRAM.SchDoc, [03] - 2560TK_Schematic.SchDoc, [04] - REVISION HISTORY.SchDoc]
2021-02-16 Added Block diagram
    [2560TK_SchematicLib.SchLib, [01] - COVER PAGE.SchDoc, [02] - BLOCK DIAGRAM.SchDoc, [03] - 2560TK_Schematic.SchDoc, [04] - REVISION HISTORY.SchDoc]
2021-02-16 added sim800l step file
    [SIM800L v10.step]
2021-02-18 added sim800l module
    [2560TK_SchematicLib.SchLib, [03] - 2560TK_Schematic.SchDoc]
2021-02-18 Schematic started
    [2560TK_SchematicLib.SchLib, [03] - 2560TK_Schematic.SchDoc]
2021-02-18 updated schematic
    [2560TK_SchematicLib.SchLib, 5MM-LED-GREEN.STEP, [03] - 2560TK_Schematic.SchDoc]
2021-02-22 schematic update
    [2560TK_SchematicLib.SchLib, [03] - 2560TK_Schematic.SchDoc]
2021-02-24 Multisheet design
    [2560_TrainingKit.PrjPcb, TK2560_InputKeys.SchDoc, TK2560_MotorDriver.SchDoc, TK2560_OutputLEDs.SchDoc, TK2560_Power.SchDoc, TK2560_RTC.SchDoc, [03] - 2560TK_Schematic.SchDoc, [04] - 2560TK_Schematic_2.SchDoc]
2021-02-24 updates sch
    [2560_TrainingKit.PrjPcb, PCB_test.PcbDoc, TK2560_BlockDiagram.SchDoc, TK2560_CoverPage.SchDoc, TK2560_ISP.SchDoc, TK2560_MCU.SchDoc, TK2560_RevisionHistory.SchDoc, [01] - COVER PAGE.SchDoc]
2021-02-26 Schematics Hierarchical
    [2560TK_SchematicLib.SchLib, 2560_TrainingKit.PrjPcb, TK2560_GPIO.SchDoc, TK2560_GSMWiFi.SchDoc, TK2560_ISP.SchDoc, TK2560_InputKeys.SchDoc, TK2560_MCU.SchDoc, TK2560_MainBlock.SchDoc]
2021-03-02 Reviewed schematics
    [2560_TrainingKit.PrjPcb, TK2560_PCB.PcbDoc, [04] - TK2560_Power.SchDoc, [07] - TK2560_RTC.SchDoc, [08] - TK2560_Relay.SchDoc, [09] - TK2560_MotorDriver.SchDoc]
2021-03-02 pcb setup
    [2560TK_SchematicLib.SchLib, [00] - TK2560_MainBlock.SchDoc, [03] - TK2560_MCU.SchDoc]
2021-03-02 pcb placement
    [[03] - TK2560_MCU.SchDoc, [05] - TK2560_OutputLEDs.SchDoc]
2021-03-03 pcb prep
    [2560_TrainingKit.PrjPcb, [03] - TK2560_MCU.SchDoc, [10] - TK2560_GSMWiFi.SchDoc, [13] - TK2560_GPIO.SchDoc]
2021-03-07 pcb update
2021-03-09 refined pcb
2021-03-11 power planes
2021-03-12 finished PCB
    [2560_TrainingKit.PrjPcb]
2021-03-16 BOM jlcsmd
    [JLCSMT_BOM.xlsx, TK2560_BOM Purchasing.xlsx, TK2560_Component Reference BOM.xlsx, TK2560_Grouped BOM.xlsx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]
2021-03-16 JLCPCB BOM
    [JLCSMT_BOM.xlsx]
2021-03-23 updated BOM
    [TK2560_Grouped BOM.xlsx]
2021-07-01 latest updates
    [2560_TrainingKit.PrjPcb]
2021-07-04 Added casing
    [Bottom.SLDPRT]
2021-07-30 arduino core
2021-08-08 resolved multiple definition error
    Resolved multiple definition of PROGMEM variables
    [gpio.c, main.c, tk2560.h]
2021-08-09 pin map for 2560
2021-08-09 timers_tone_not working
2021-08-16 millis, pwm
    Implemented the millis function on timer0 and pwm
2021-08-19 adc done
